h3llf/Euclid-8/Controller/ADC.kicad_sch

## KiCad design Controller/ADC.kicad_sch (2026-04-20)

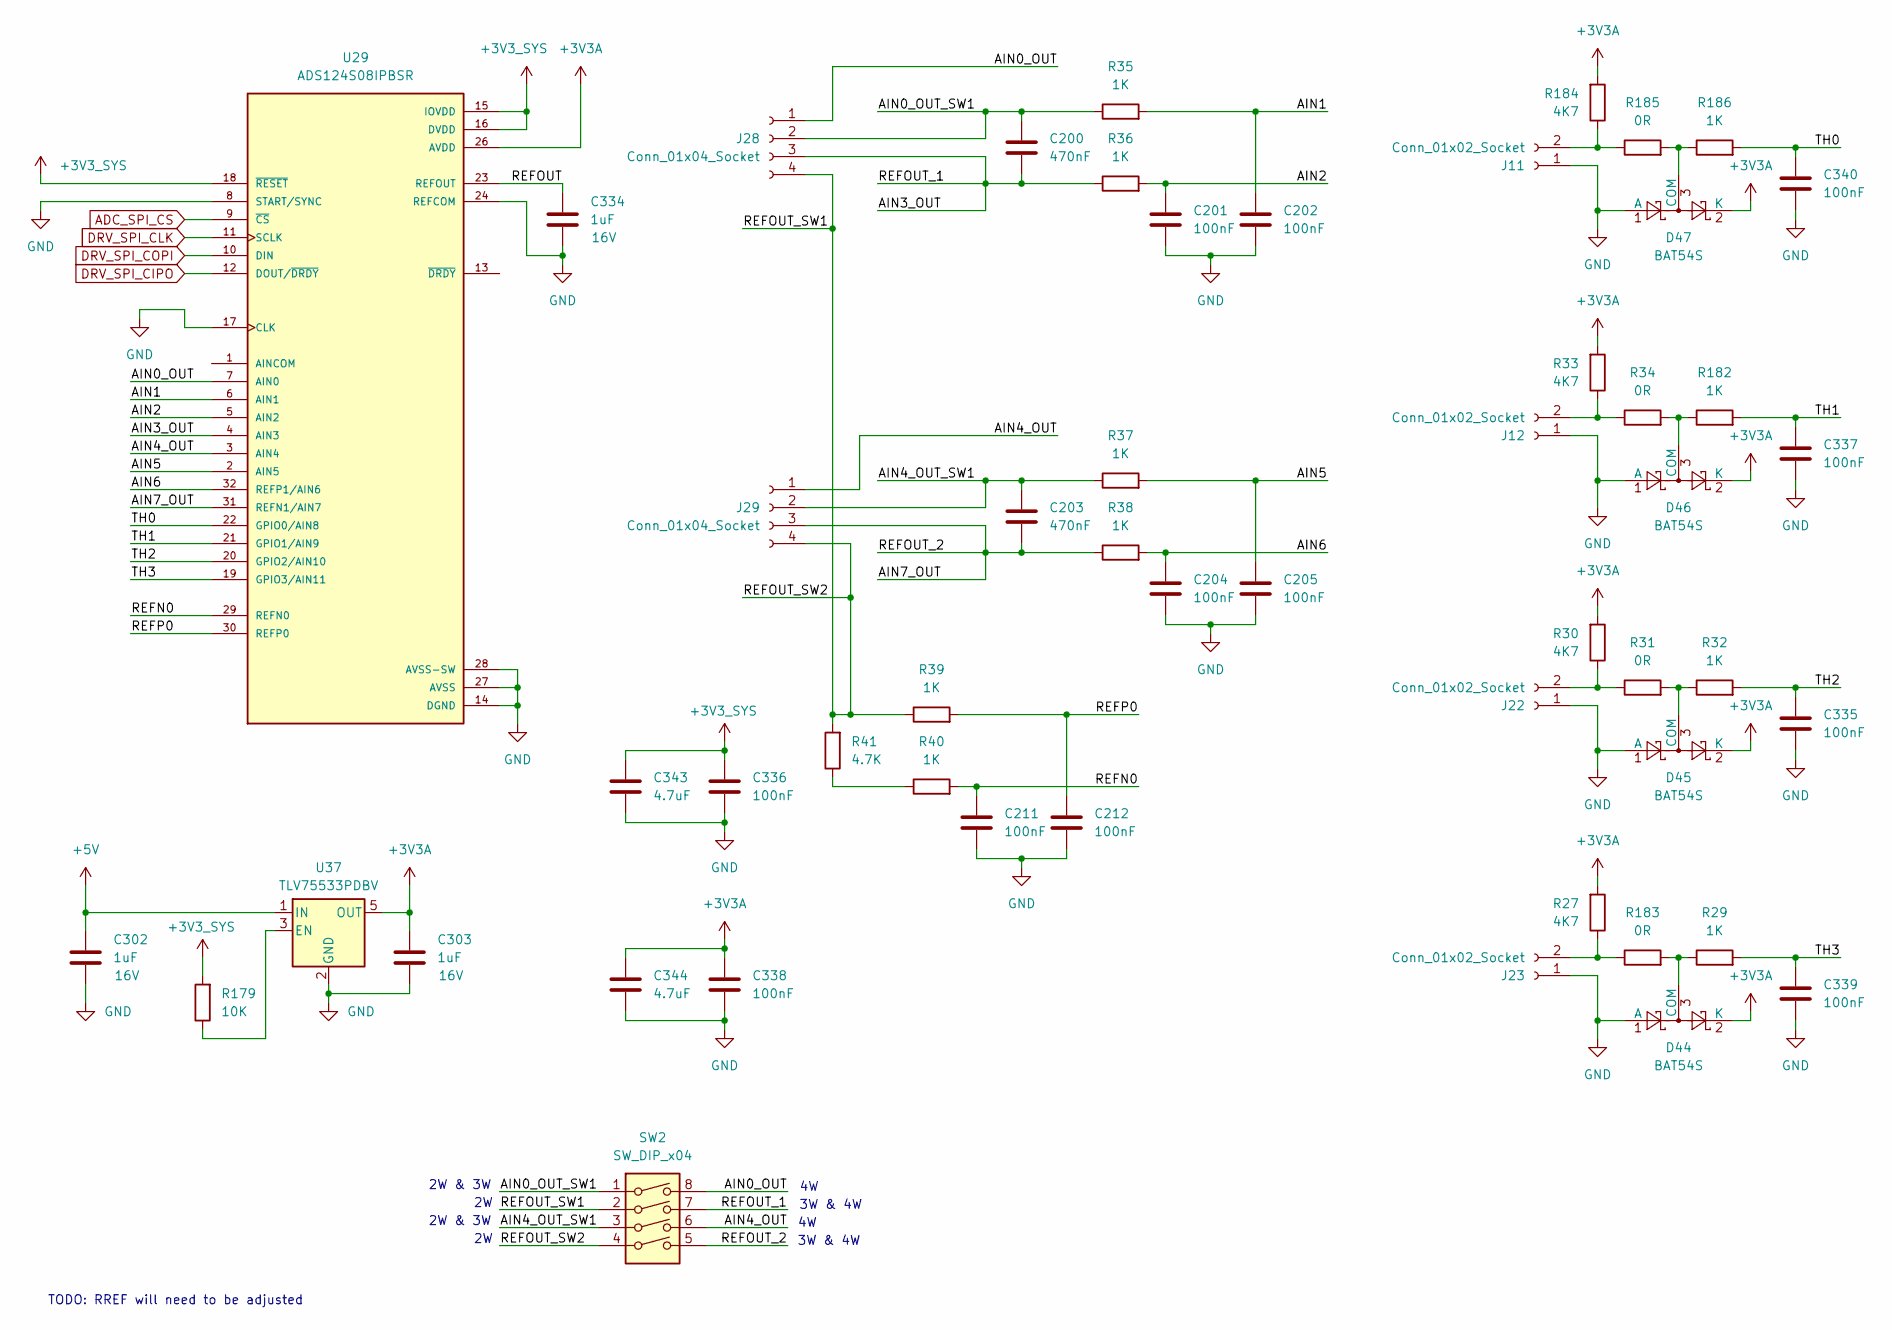
[picture p1: schematic ADC.kicad_sch]

Parts:
C200, C203: 470nF; C_0603_1608Metric
C201, C202, C204, C205, C211, C212, C335, C336, C337, C338, C339, C340: 100nF; C_0603_1608Metric
C302, C303, C334: 1uF; C_0402_1005Metric; voltage 16V; LCSC C29266
C343, C344: 4.7uF; C_0603_1608Metric; LCSC C69335
D44, D45, D46, D47: BAT54S; SOT-23
J11, J12, J22, J23: Conn_01x02_Socket; JST_XH_B2B-XH-A_1x02_P2.50mm_Vertical
J28, J29: Conn_01x04_Socket; JST_XH_B4B-XH-A_1x04_P2.50mm_Vertical
R27, R30, R33, R184: 4K7; R_0603_1608Metric
R29, R32, R35, R36, R37, R38, R39, R40, R182, R186: 1K; R_0603_1608Metric
R31, R34, R183, R185: 0R; R_0603_1608Metric
R41: 4.7K; R_0603_1608Metric
R179: 10K; R_0603_1608Metric
SW2: SW_DIP_x04; SW_DIP_SPSTx04_Slide_KingTek_DSHP04TS_W7.62mm_P1.27mm
U29: ADS124S08IPBSR; QFP50P700X700X120-32N; PARTREV C
U37: TLV75533PDBV; SOT-23-5

Connections:
+3V3A: C303.1, C338.1, C344.1, D44.2 (K), D45.2 (K), D46.2 (K), D47.2 (K), R27.2, R30.2, R33.2, R184.2, U29.26 (AVDD), U37.5 (OUT)
+3V3_SYS: C336.1, C343.1, R179.2, U29.15 (IOVDD), U29.16 (DVDD), U29.18 (~RESET)
+5V: C302.1, U37.1 (IN)
ADC_SPI_CS: U29.9 (~CS)
AIN0_OUT: J28.1, SW2.8, U29.7 (AIN0)
AIN0_OUT_SW1: C200.1, J28.2, R35.1, SW2.1
AIN1: C202.1, R35.2, U29.6 (AIN1)
AIN2: C201.1, R36.2, U29.5 (AIN2)
AIN3_OUT: C200.2, J28.3, R36.1, SW2.7, U29.4 (AIN3)
AIN4_OUT: J29.1, SW2.6, U29.3 (AIN4)
AIN4_OUT_SW1: C203.1, J29.2, R37.1, SW2.3
AIN5: C205.1, R37.2, U29.2 (AIN5)
AIN6: C204.1, R38.2, U29.32 (REFP1/AIN6)
AIN7_OUT: C203.2, J29.3, R38.1, SW2.5, U29.31 (REFN1/AIN7)
DRV_SPI_CIPO: U29.12 (DOUT/~DRDY)
DRV_SPI_CLK: U29.11 (SCLK)
DRV_SPI_COPI: U29.10 (DIN)
GND: C201.2, C202.2, C204.2, C205.2, C211.2, C212.2, C302.2, C303.2, C334.2, C335.2, C336.2, C337.2, C338.2, C339.2, C340.2, C343.2, C344.2, D44.1 (A), D45.1 (A), D46.1 (A), D47.1 (A), J11.1, J12.1, J22.1, J23.1, U29.8 (START/SYNC), U29.14 (DGND), U29.17 (CLK), U29.24 (REFCOM), U29.27 (AVSS), U29.28 (AVSS-SW), U37.2 (GND)
unnamed: D44.3 (COM), R29.1, R183.2
unnamed: D45.3 (COM), R31.2, R32.1
unnamed: D46.3 (COM), R34.2, R182.1
unnamed: D47.3 (COM), R185.2, R186.1
unnamed: J11.2, R184.1, R185.1
unnamed: J12.2, R33.1, R34.1
unnamed: J22.2, R30.1, R31.1
unnamed: J23.2, R27.1, R183.1
unnamed: R40.1, R41.1
unnamed: R179.1, U37.3 (EN)
REFN0: C211.1, R40.2, U29.29 (REFN0)
REFOUT: C334.1, U29.23 (REFOUT)
REFOUT_SW1: J28.4, J29.4, R39.1, R41.2, SW2.2, SW2.4
REFP0: C212.1, R39.2, U29.30 (REFP0)
TH0: C340.1, R186.2, U29.22 (GPIO0/AIN8)
TH1: C337.1, R182.2, U29.21 (GPIO1/AIN9)
TH2: C335.1, R32.2, U29.20 (GPIO2/AIN10)
TH3: C339.1, R29.2, U29.19 (GPIO3/AIN11)

Notes on the sheet:
TODO: RREF will need to be adjusted
3W & 4W
2W & 3W
