h3llf/Euclid-8/Controller/AM6254_DDR4.kicad_sch

## KiCad design Controller/AM6254_DDR4.kicad_sch (2026-04-20)

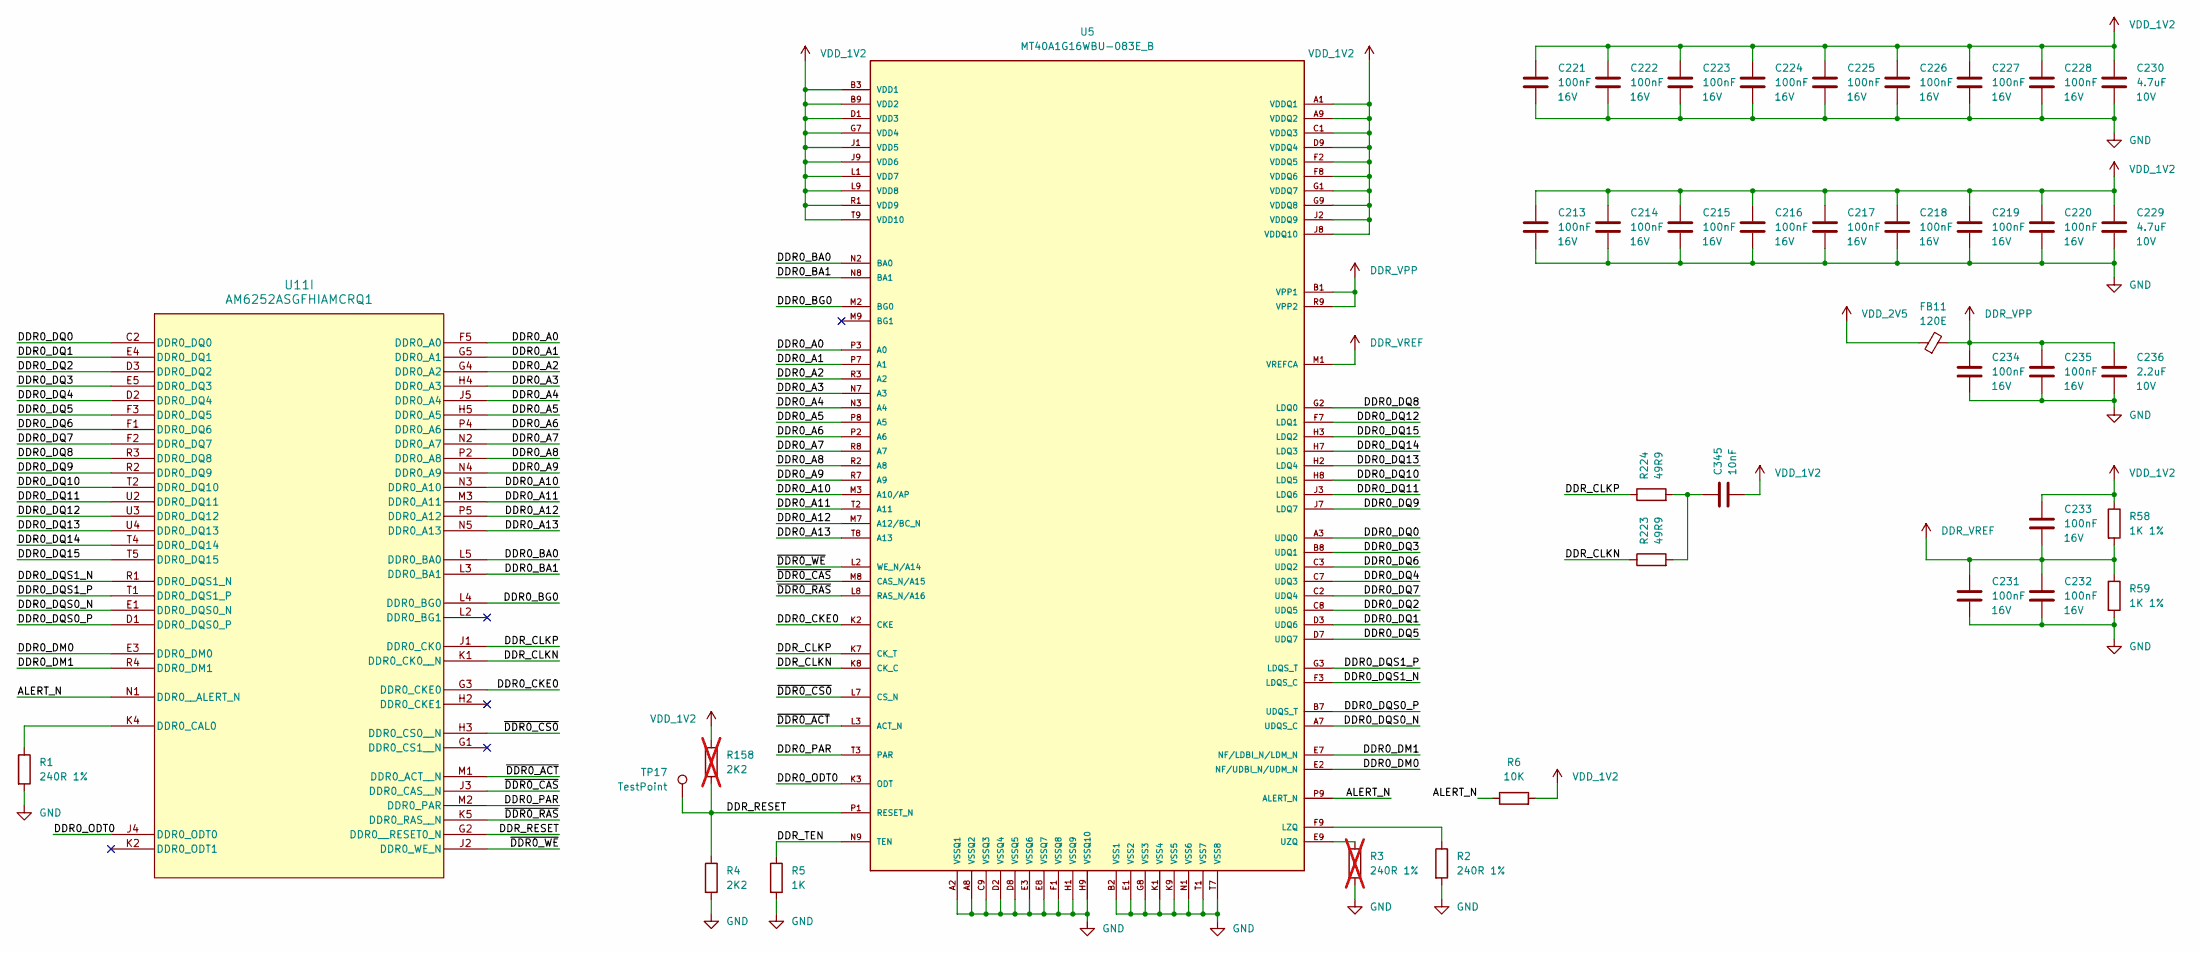
[picture p2: schematic AM6254_DDR4.kicad_sch]

Parts:
C213, C214, C215, C216, C217, C218, C219, C220, C221, C222, C223, C224, C225, C226, C227, C228, C231, C232, C233, C234, C235: 100nF; C_0402_1005Metric; Voltage 16V
C229, C230: 4.7uF; C_0402_1005Metric; voltage 10V; LCSC C368809
C236: 2.2uF; C_0402_1005Metric; voltage 10V; LCSC C170151
C345: 10nF; C_0402_1005Metric
FB11: 120E; L_0402_1005Metric; LCSC C88970
R1, R2: 240R 1%; R_0402_1005Metric; LCSC C114755
R3: 240R 1%; R_0402_1005Metric; LCSC C114755; not fitted
R4: 2K2; R_0402_1005Metric
R5: 1K; R_0402_1005Metric
R6: 10K; R_0402_1005Metric
R58, R59: 1K 1%; R_0402_1005Metric
R158: 2K2; R_0402_1005Metric; not fitted
R223, R224: 49R9; R_0402_1005Metric
TP17: TestPoint; TestPoint_Pad_D1.0mm
U5: MT40A1G16WBU-083E_B; BGA96C80P16X9_1400X800X110N
U11: AM6252ASGFHIAMCRQ1; FCBGA441_AMC_TEX

Connections:
ALERT_N: R6.1, U5.P9 (ALERT_N), U11.N1 (DDR0__ALERT_N)
DDR0_A0: U5.P3 (A0), U11.F5 (DDR0_A0)
DDR0_A1: U5.P7 (A1), U11.G5 (DDR0_A1)
DDR0_A2: U5.R3 (A2), U11.G4 (DDR0_A2)
DDR0_A3: U5.N7 (A3), U11.H4 (DDR0_A3)
DDR0_A4: U5.N3 (A4), U11.J5 (DDR0_A4)
DDR0_A5: U5.P8 (A5), U11.H5 (DDR0_A5)
DDR0_A6: U5.P2 (A6), U11.P4 (DDR0_A6)
DDR0_A7: U5.R8 (A7), U11.N2 (DDR0_A7)
DDR0_A8: U5.R2 (A8), U11.P2 (DDR0_A8)
DDR0_A9: U5.R7 (A9), U11.N4 (DDR0_A9)
DDR0_A10: U5.M3 (A10/AP), U11.N3 (DDR0_A10)
DDR0_A11: U5.T2 (A11), U11.M3 (DDR0_A11)
DDR0_A12: U5.M7 (A12/BC_N), U11.P5 (DDR0_A12)
DDR0_A13: U5.T8 (A13), U11.N5 (DDR0_A13)
DDR0_BA0: U5.N2 (BA0), U11.L5 (DDR0_BA0)
DDR0_BA1: U5.N8 (BA1), U11.L3 (DDR0_BA1)
DDR0_BG0: U5.M2 (BG0), U11.L4 (DDR0_BG0)
DDR0_CKE0: U5.K2 (CKE), U11.G3 (DDR0_CKE0)
DDR0_DM0: U5.E2 (NF/UDBI_N/UDM_N), U11.E3 (DDR0_DM0)
DDR0_DM1: U5.E7 (NF/LDBI_N/LDM_N), U11.R4 (DDR0_DM1)
DDR0_DQ0: U5.A3 (UDQ0), U11.C2 (DDR0_DQ0)
DDR0_DQ1: U5.D3 (UDQ6), U11.E4 (DDR0_DQ1)
DDR0_DQ2: U5.C8 (UDQ5), U11.D3 (DDR0_DQ2)
DDR0_DQ3: U5.B8 (UDQ1), U11.E5 (DDR0_DQ3)
DDR0_DQ4: U5.C7 (UDQ3), U11.D2 (DDR0_DQ4)
DDR0_DQ5: U5.D7 (UDQ7), U11.F3 (DDR0_DQ5)
DDR0_DQ6: U5.C3 (UDQ2), U11.F1 (DDR0_DQ6)
DDR0_DQ7: U5.C2 (UDQ4), U11.F2 (DDR0_DQ7)
DDR0_DQ8: U5.G2 (LDQ0), U11.R3 (DDR0_DQ8)
DDR0_DQ9: U5.J7 (LDQ7), U11.R2 (DDR0_DQ9)
DDR0_DQ10: U5.H8 (LDQ5), U11.T2 (DDR0_DQ10)
DDR0_DQ11: U5.J3 (LDQ6), U11.U2 (DDR0_DQ11)
DDR0_DQ12: U5.F7 (LDQ1), U11.U3 (DDR0_DQ12)
DDR0_DQ13: U5.H2 (LDQ4), U11.U4 (DDR0_DQ13)
DDR0_DQ14: U5.H7 (LDQ3), U11.T4 (DDR0_DQ14)
DDR0_DQ15: U5.H3 (LDQ2), U11.T5 (DDR0_DQ15)
DDR0_DQS0_N: U5.A7 (UDQS_C), U11.E1 (DDR0_DQS0_N)
DDR0_DQS0_P: U5.B7 (UDQS_T), U11.D1 (DDR0_DQS0_P)
DDR0_DQS1_N: U5.F3 (LDQS_C), U11.R1 (DDR0_DQS1_N)
DDR0_DQS1_P: U5.G3 (LDQS_T), U11.T1 (DDR0_DQS1_P)
DDR0_ODT0: U5.K3 (ODT), U11.J4 (DDR0_ODT0)
DDR0_PAR: U5.T3 (PAR), U11.M2 (DDR0_PAR)
DDR_CLKN: R223.1, U5.K8 (CK_C), U11.K1 (DDR0_CK0__N)
DDR_CLKP: R224.1, U5.K7 (CK_T), U11.J1 (DDR0_CK0)
DDR_RESET: R4.1, R158.2, TP17.1, U5.P1 (RESET_N), U11.G2 (DDR0__RESET0_N)
DDR_TEN: R5.1, U5.N9 (TEN)
DDR_VPP: C234.1, C235.1, C236.1, FB11.2, U5.B1 (VPP1), U5.R9 (VPP2)
DDR_VREF: C231.1, C232.1, C233.2, R58.2, R59.1, U5.M1 (VREFCA)
GND: C213.2, C214.2, C215.2, C216.2, C217.2, C218.2, C219.2, C220.2, C221.2, C222.2, C223.2, C224.2, C225.2, C226.2, C227.2, C228.2, C229.2, C230.2, C231.2, C232.2, C234.2, C235.2, C236.2, R1.2, R2.2, R3.2, R4.2, R5.2, R59.2, U5.A2 (VSSQ1), U5.A8 (VSSQ2), U5.B2 (VSS1), U5.C9 (VSSQ3), U5.D2 (VSSQ4), U5.D8 (VSSQ5), U5.E1 (VSS2), U5.E3 (VSSQ6), U5.E8 (VSSQ7), U5.F1 (VSSQ8), U5.G8 (VSS3), U5.H1 (VSSQ9), U5.H9 (VSSQ10), U5.K1 (VSS4), U5.K9 (VSS5), U5.N1 (VSS6), U5.T1 (VSS7), U5.T7 (VSS8)
unnamed: C345.1, R223.2, R224.2
unnamed: R1.1, U11.K4 (DDR0_CAL0)
unnamed: R2.1, U5.F9 (LZQ)
unnamed: R3.1, U5.E9 (UZQ)
VDD_1V2: C213.1, C214.1, C215.1, C216.1, C217.1, C218.1, C219.1, C220.1, C221.1, C222.1, C223.1, C224.1, C225.1, C226.1, C227.1, C228.1, C229.1, C230.1, C233.1, C345.2, R6.2, R58.1, R158.1, U5.A1 (VDDQ1), U5.A9 (VDDQ2), U5.B3 (VDD1), U5.B9 (VDD2), U5.C1 (VDDQ3), U5.D1 (VDD3), U5.D9 (VDDQ4), U5.F2 (VDDQ5), U5.F8 (VDDQ6), U5.G1 (VDDQ7), U5.G7 (VDD4), U5.G9 (VDDQ8), U5.J1 (VDD5), U5.J2 (VDDQ9), U5.J8 (VDDQ10), U5.J9 (VDD6), U5.L1 (VDD7), U5.L9 (VDD8), U5.R1 (VDD9), U5.T9 (VDD10)
VDD_2V5: FB11.1
~DDR0_ACT: U5.L3 (ACT_N), U11.M1 (DDR0_ACT__N)
~DDR0_CAS: U5.M8 (CAS_N/A15), U11.J3 (DDR0_CAS__N)
~DDR0_CS0: U5.L7 (CS_N), U11.H3 (DDR0_CS0__N)
~DDR0_RAS: U5.L8 (RAS_N/A16), U11.K5 (DDR0_RAS__N)
~DDR0_WE: U5.L2 (WE_N/A14), U11.J2 (DDR0_WE_N)
