h3llf/Euclid-8/Controller/Board_Power.kicad_sch

## KiCad design Controller/Board_Power.kicad_sch (2026-05-04)

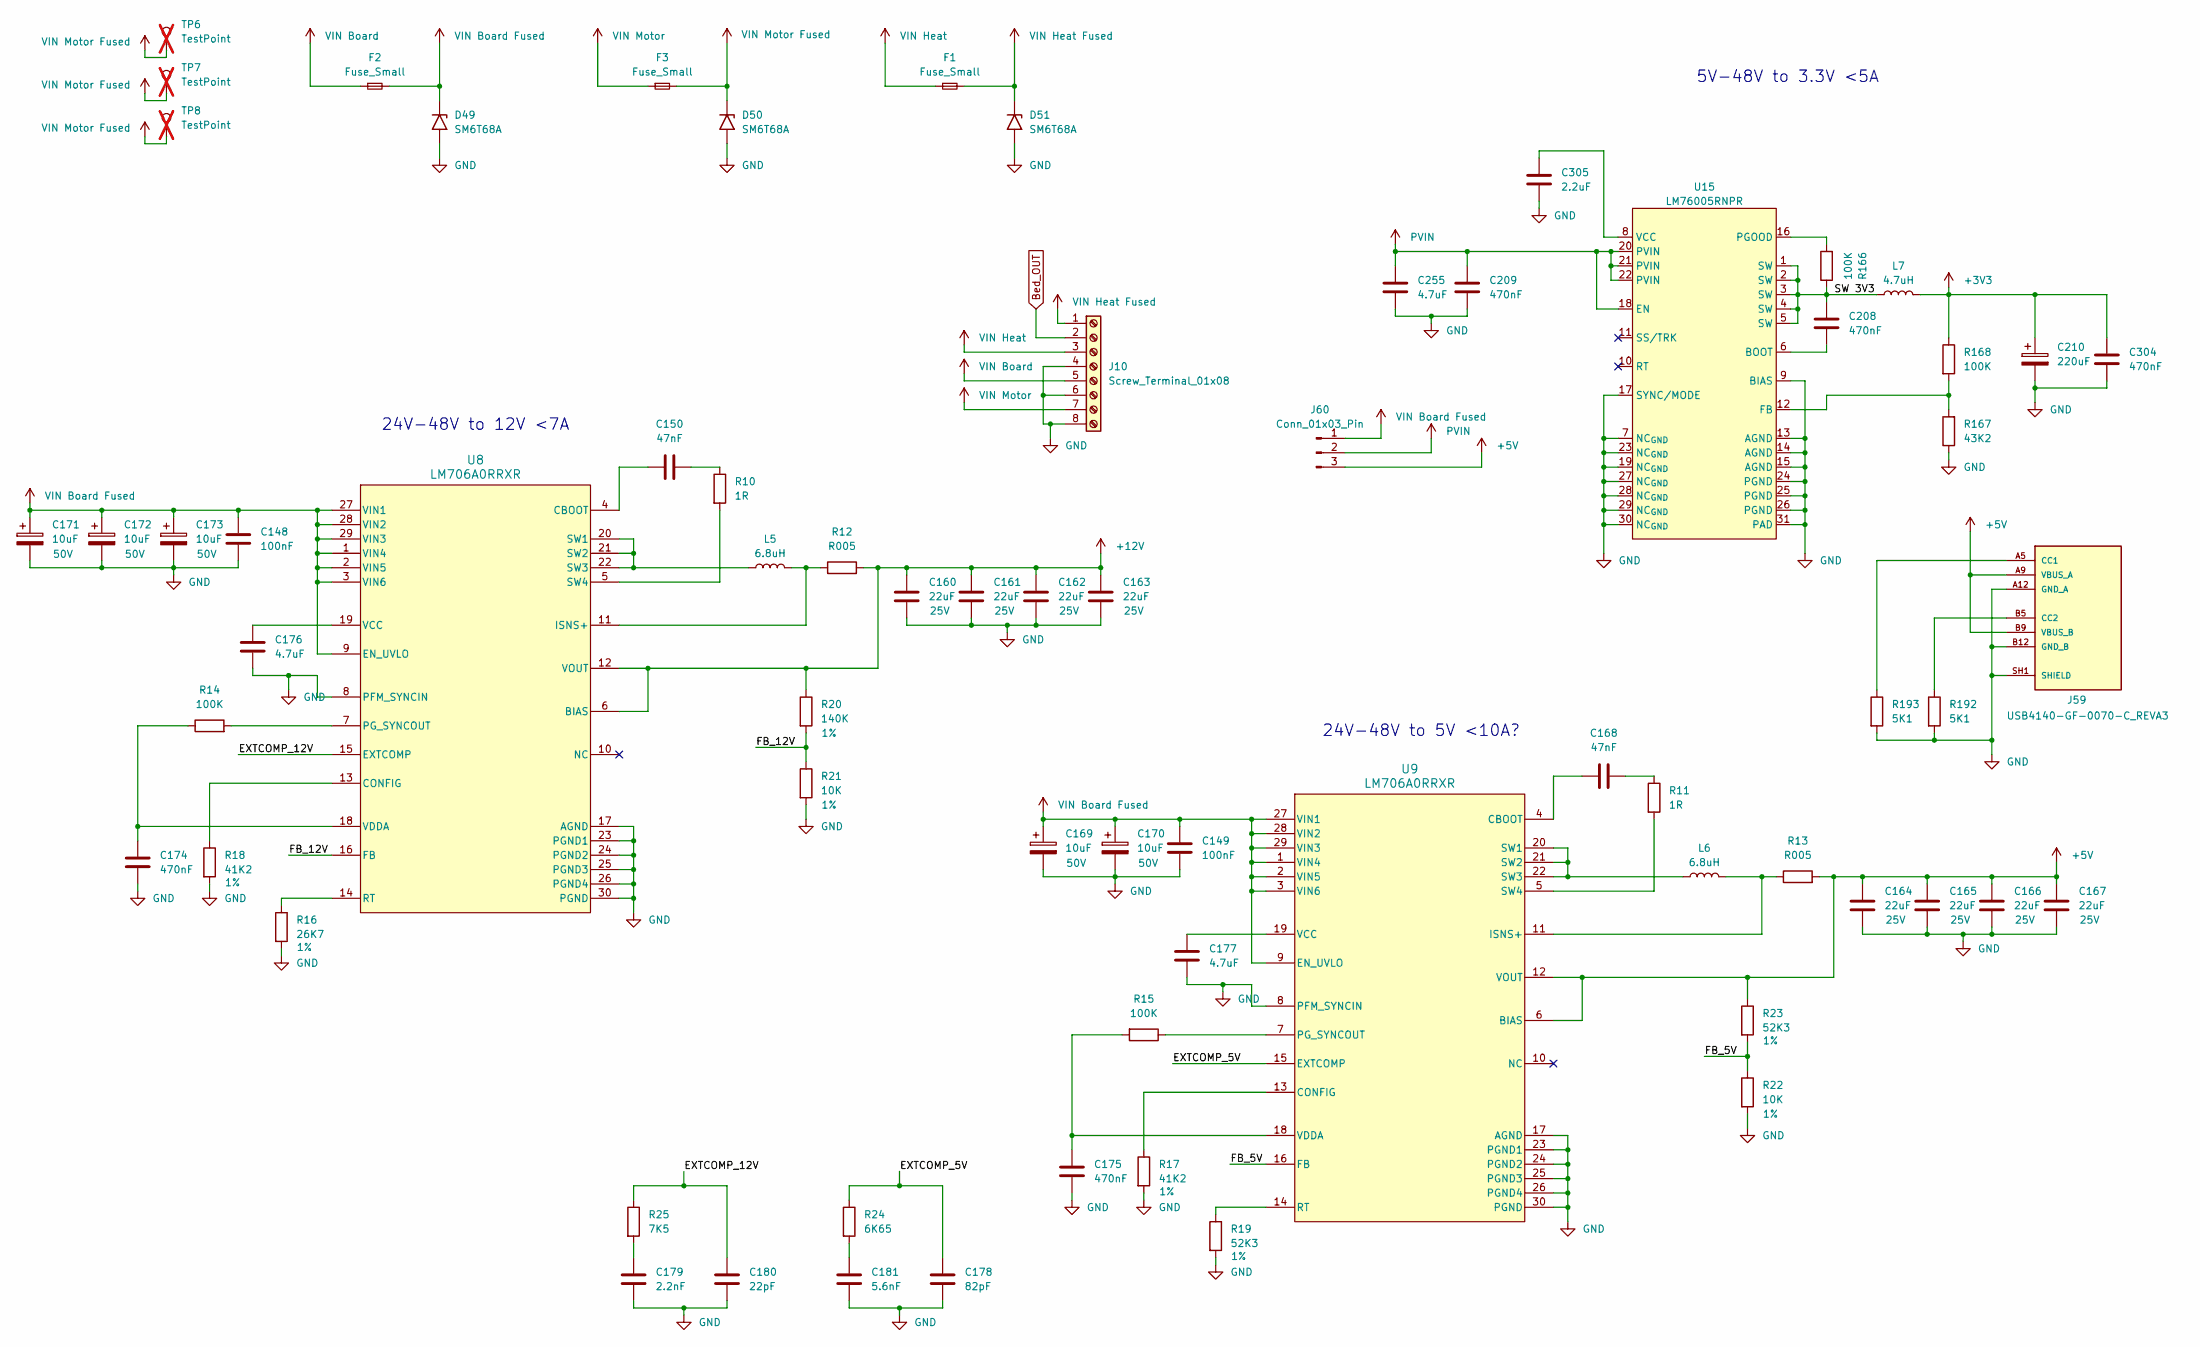
[picture p3: schematic Board_Power.kicad_sch]

Parts:
C148, C149: 100nF; C_0603_1608Metric; LCSC C15725
C150, C168: 47nF; C_0402_1005Metric; LCSC C5137574
C160, C161, C162, C163, C164, C165, C166, C167: 22uF; C_1210_3225Metric; Voltage 25V; LCSC C309062
C169, C170, C171, C172, C173: 10uF; CP_Elec_6.3x5.9; Voltage 50V; LCSC C2162323
C174, C175, C208, C209, C304: 470nF; C_0603_1608Metric; LCSC C513577
C176, C177: 4.7uF; C_0603_1608Metric; LCSC C69335
C178: 82pF; C_0603_1608Metric; LCSC C113796
C179: 2.2nF; C_0603_1608Metric; LCSC C106210
C180: 22pF; C_0603_1608Metric; LCSC C519549
C181: 5.6nF; C_0603_1608Metric; LCSC C100042
C210: 220uF; CP_EIA-3528-21_Kemet-B; LCSC C79111
C255: 4.7uF; C_1210_3225Metric; LCSC C697607
C305: 2.2uF; C_0603_1608Metric; LCSC C57895
D49, D50, D51: SM6T68A; D_SMB
F1, F2, F3: Fuse_Small; Fuseholder_Blade_Mini_Keystone_3568
J10: Screw_Terminal_01x08; DORABO-DBT50G-9.5-8P
J59: USB4140-GF-0070-C_REVA3; GCT_USB4140-GF-0070-C_REVA3; PARTREV A3
J60: Conn_01x03_Pin; PinHeader_1x03_P2.54mm_Vertical
L5, L6: 6.8uH; YJYCOIN YPRH1208-XXX; LCSC C970538
L7: 4.7uH; L_APV_APH0630
R10, R11: 1R; R_0603_1608Metric; LCSC C22936
R12: R005; R_2512_6332Metric
R13: R005; R_2512_6332Metric; LCSC C46634448
R14, R15, R166, R168: 100K; R_0603_1608Metric
R16: 26K7; R_0603_1608Metric; LCSC C23198
R17, R18: 41K2; R_0603_1608Metric; LCSC C706088
R19, R23: 52K3; R_0603_1608Metric; LCSC C23198
R20: 140K; R_0603_1608Metric; LCSC C185372
R21, R22: 10K; R_0603_1608Metric; LCSC C25804
R24: 6K65; R_0603_1608Metric; LCSC C859010
R25: 7K5; R_0603_1608Metric; LCSC C2933189
R167: 43K2; R_0603_1608Metric
R192, R193: 5K1; R_0603_1608Metric
TP6, TP7, TP8: TestPoint; TestPoint_Pad_4.0x4.0mm; not fitted
U8, U9: LM706A0RRXR; RRX0029B-MFG
U15: LM76005RNPR; Texas_RNP0030B_WQFN-30-1EP_4x6mm_P0.5mm_EP1.8x4.5mm

Connections:
+3V3: C210.1, C304.1, L7.2, R168.1
+5V: C164.1, C165.1, C166.1, C167.1, J59.A9 (VBUS_A), J59.B9 (VBUS_B), J60.3, R13.2, R23.1, U9.6 (BIAS), U9.12 (VOUT)
+12V: C160.1, C161.1, C162.1, C163.1, R12.2, R20.1, U8.6 (BIAS), U8.12 (VOUT)
Bed_OUT: J10.2
EXTCOMP_5V: C178.1, R24.1, U9.15 (EXTCOMP)
EXTCOMP_12V: C180.1, R25.1, U8.15 (EXTCOMP)
FB_5V: R22.1, R23.2, U9.16 (FB)
FB_12V: R20.2, R21.1, U8.16 (FB)
GND: C148.2, C149.2, C160.2, C161.2, C162.2, C163.2, C164.2, C165.2, C166.2, C167.2, C169.2, C170.2, C171.2, C172.2, C173.2, C174.2, C175.2, C176.2, C177.2, C178.2, C179.2, C180.2, C181.2, C209.2, C210.2, C255.2, C304.2, C305.2, D49.2 (A2), D50.2 (A2), D51.2 (A2), J10.4, J10.6, J10.8, J59.A12 (GND_A), J59.B12 (GND_B), J59.SH1 (SHIELD), J59.SH2 (SHIELD), J59.SH3 (SHIELD), J59.SH4 (SHIELD), R16.2, R17.2, R18.2, R19.2, R21.2, R22.2, R167.1, R192.2, R193.2, U8.8 (PFM_SYNCIN), U8.17 (AGND), U8.23 (PGND1), U8.24 (PGND2), U8.25 (PGND3), U8.26 (PGND4), U8.30 (PGND), U9.8 (PFM_SYNCIN), U9.17 (AGND), U9.23 (PGND1), U9.24 (PGND2), U9.25 (PGND3), U9.26 (PGND4), U9.30 (PGND), U15.7 (NC_{GND}), U15.9 (BIAS), U15.13 (AGND), U15.14 (AGND), U15.15 (AGND), U15.17 (SYNC/MODE), U15.19 (NC_{GND}), U15.23 (NC_{GND}), U15.24 (PGND), U15.25 (PGND), U15.26 (PGND), U15.27 (NC_{GND}), U15.28 (NC_{GND}), U15.29 (NC_{GND}), U15.30 (NC_{GND}), U15.31 (PAD)
unnamed: C150.1, U8.4 (CBOOT)
unnamed: C150.2, R10.1
unnamed: C168.1, U9.4 (CBOOT)
unnamed: C168.2, R11.1
unnamed: C174.1, R14.1, U8.18 (VDDA)
unnamed: C175.1, R15.2, U9.18 (VDDA)
unnamed: C176.1, U8.19 (VCC)
unnamed: C177.1, U9.19 (VCC)
unnamed: C179.1, R25.2
unnamed: C181.1, R24.2
unnamed: C208.2, U15.6 (BOOT)
unnamed: C305.1, U15.8 (VCC)
unnamed: J59.A5 (CC1), R193.1
unnamed: J59.B5 (CC2), R192.1
unnamed: L5.1, U8.20 (SW1), U8.21 (SW2), U8.22 (SW3)
unnamed: L5.2, R12.1, U8.11 (ISNS+)
unnamed: L6.1, U9.20 (SW1), U9.21 (SW2), U9.22 (SW3)
unnamed: L6.2, R13.1, U9.11 (ISNS+)
unnamed: R10.2, U8.5 (SW4)
unnamed: R11.2, U9.5 (SW4)
unnamed: R14.2, U8.7 (PG_SYNCOUT)
unnamed: R15.1, U9.7 (PG_SYNCOUT)
unnamed: R16.1, U8.14 (RT)
unnamed: R17.1, U9.13 (CONFIG)
unnamed: R18.1, U8.13 (CONFIG)
unnamed: R19.1, U9.14 (RT)
unnamed: R166.2, U15.16 (PGOOD)
unnamed: R167.2, R168.2, U15.12 (FB)
PVIN: C209.1, C255.1, J60.2, U15.18 (EN), U15.20 (PVIN), U15.21 (PVIN), U15.22 (PVIN)
SW 3V3: C208.1, L7.1, R166.1, U15.1 (SW), U15.2 (SW), U15.3 (SW), U15.4 (SW), U15.5 (SW)
VIN Board: F2.1, J10.5
VIN Board Fused: C148.1, C149.1, C169.1, C170.1, C171.1, C172.1, C173.1, D49.1 (A1), F2.2, J60.1, U8.1 (VIN4), U8.2 (VIN5), U8.3 (VIN6), U8.9 (EN_UVLO), U8.27 (VIN1), U8.28 (VIN2), U8.29 (VIN3), U9.1 (VIN4), U9.2 (VIN5), U9.3 (VIN6), U9.9 (EN_UVLO), U9.27 (VIN1), U9.28 (VIN2), U9.29 (VIN3)
VIN Heat: F1.1, J10.3
VIN Heat Fused: D51.1 (A1), F1.2, J10.1
VIN Motor: F3.1, J10.7
VIN Motor Fused: D50.1 (A1), F3.2, TP6.1, TP7.1, TP8.1

Notes on the sheet:
5V-48V to 3.3V <5A
24V-48V to 5V <10A?
24V-48V to 12V <7A
