h3llf/Euclid-8/Controller/CAN.kicad_sch

## KiCad design Controller/CAN.kicad_sch (2026-03-28)

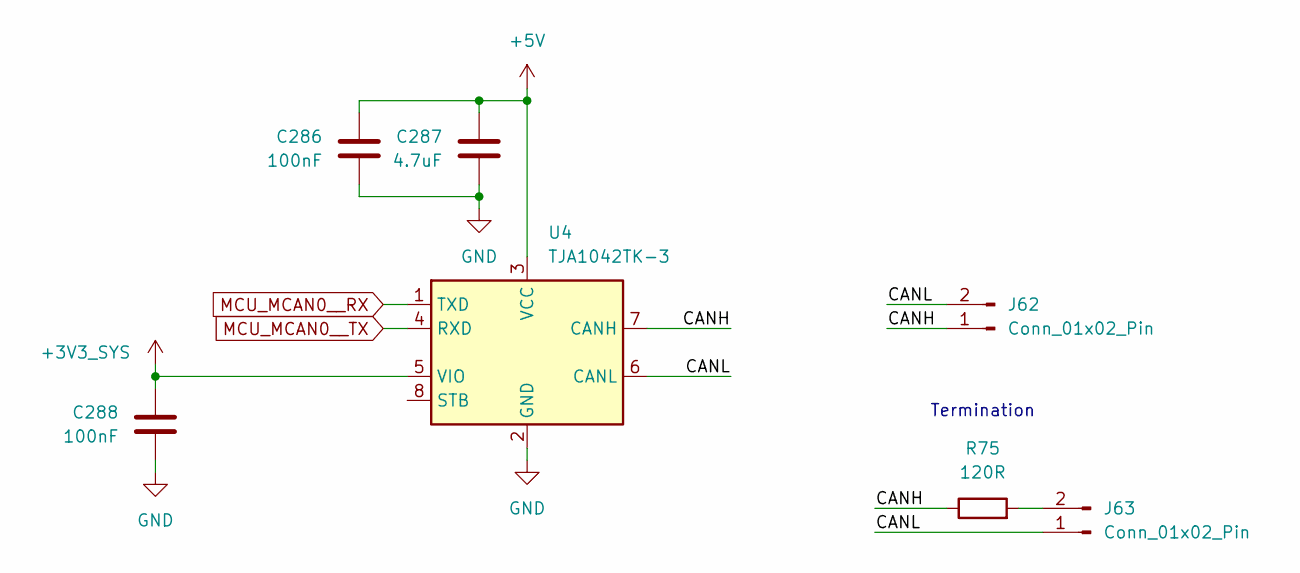
[picture p4: schematic CAN.kicad_sch]

Parts:
C286, C288: 100nF; C_0603_1608Metric
C287: 4.7uF; C_0603_1608Metric
J62, J63: Conn_01x02_Pin; PinHeader_1x02_P2.54mm_Vertical
R75: 120R; R_0603_1608Metric
U4: TJA1042TK-3; HVSON-8-1EP_3x3mm_P0.65mm_EP1.6x2.4mm

Connections:
+3V3_SYS: C288.1, U4.5 (VIO)
+5V: C286.1, C287.1, U4.3 (VCC)
CANH: J62.1, R75.1, U4.7 (CANH)
CANL: J62.2, J63.1, U4.6 (CANL)
GND: C286.2, C287.2, C288.2, U4.2 (GND), U4.9 (GND)
MCU_MCAN0__RX: U4.1 (TXD)
MCU_MCAN0__TX: U4.4 (RXD)
unnamed: J63.2, R75.2

Notes on the sheet:
Termination
