h3llf/Euclid-8/Controller/Controller.kicad_sch

## KiCad design Controller/Controller.kicad_sch (2026-04-20)

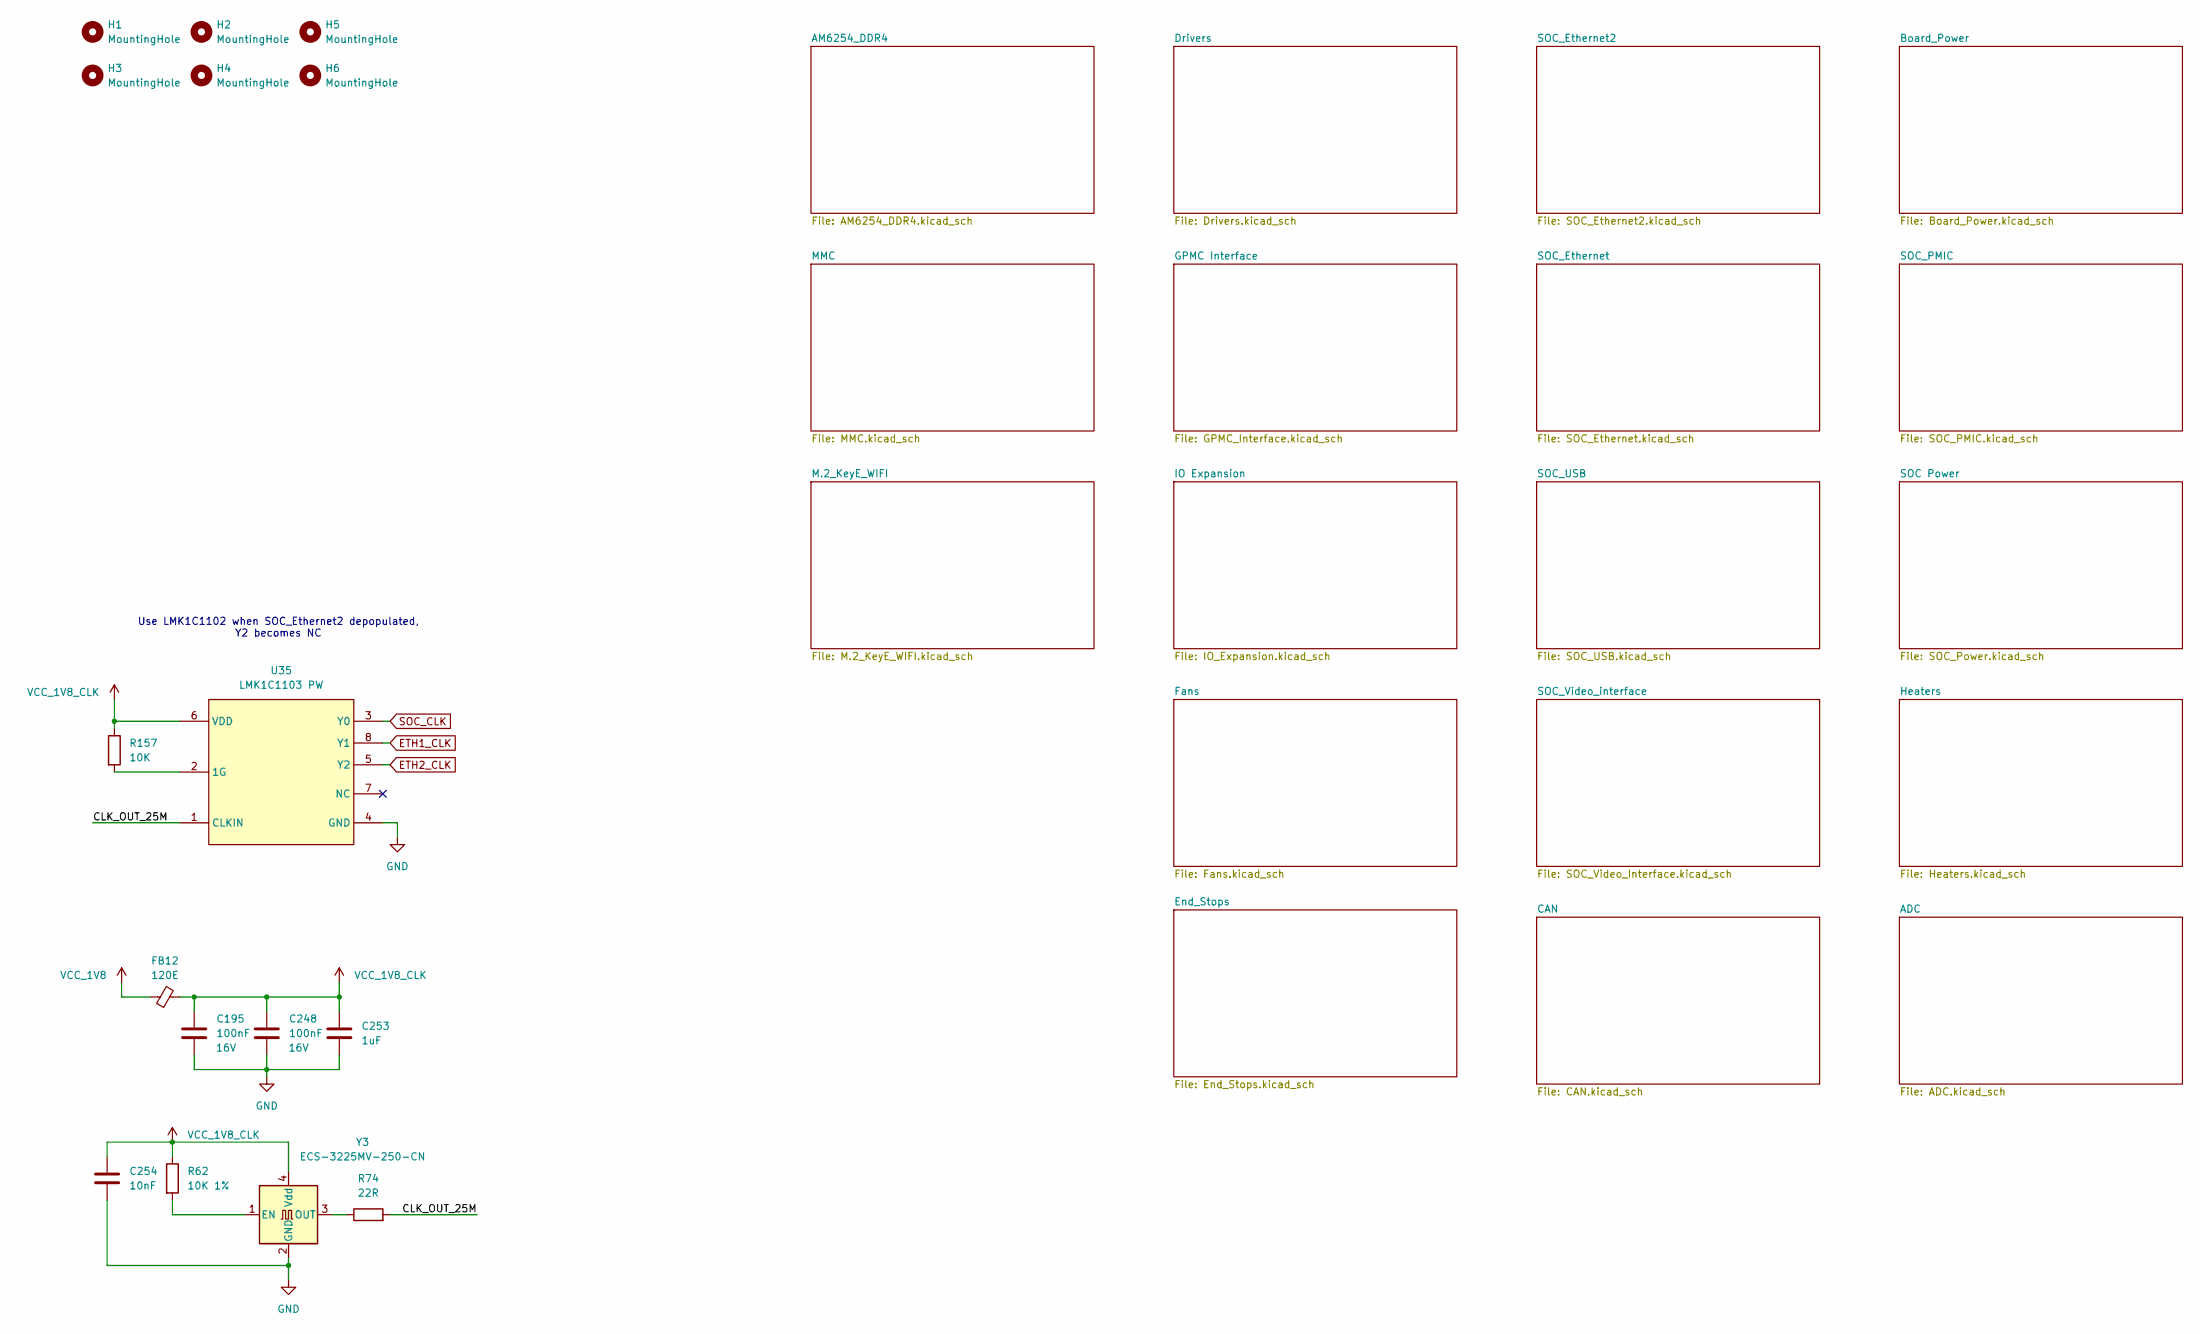
[picture p5: schematic Controller.kicad_sch]

Parts:
C195, C248: 100nF; C_0402_1005Metric; Voltage 16V
C253: 1uF; C_0603_1608Metric
C254: 10nF; C_0402_1005Metric
FB12: 120E; L_0402_1005Metric; LCSC C88970
H1, H2, H3, H4, H5, H6: MountingHole; MountingHole_4.3mm_M4
R62: 10K 1%; R_0603_1608Metric
R74: 22R; R_0402_1005Metric
R157: 10K; R_0603_1608Metric
U35: LMK1C1103 PW; LMK1C110X TSSOP-8
Y3: ECS-3225MV-250-CN; Oscillator_SMD_Abracon_ASE-4Pin_3.2x2.5mm

Connections:
CLK_OUT_25M: R74.2, U35.1 (CLKIN)
ETH1_CLK: U35.8 (Y1)
ETH2_CLK: U35.5 (Y2)
GND: C195.2, C248.2, C253.2, C254.2, U35.4 (GND), Y3.2 (GND)
unnamed: R62.2, Y3.1 (EN)
unnamed: R74.1, Y3.3 (OUT)
unnamed: R157.2, U35.2 (1G)
SOC_CLK: U35.3 (Y0)
VCC_1V8: FB12.1
VCC_1V8_CLK: C195.1, C248.1, C253.1, C254.1, FB12.2, R62.1, R157.1, U35.6 (VDD), Y3.4 (Vdd)

Notes on the sheet:
Use LMK1C1102 when SOC_Ethernet2 depopulated, Y2 becomes NC
