h3llf/Euclid-8/Controller/Drivers.kicad_sch

## KiCad design Controller/Drivers.kicad_sch (2026-04-20)

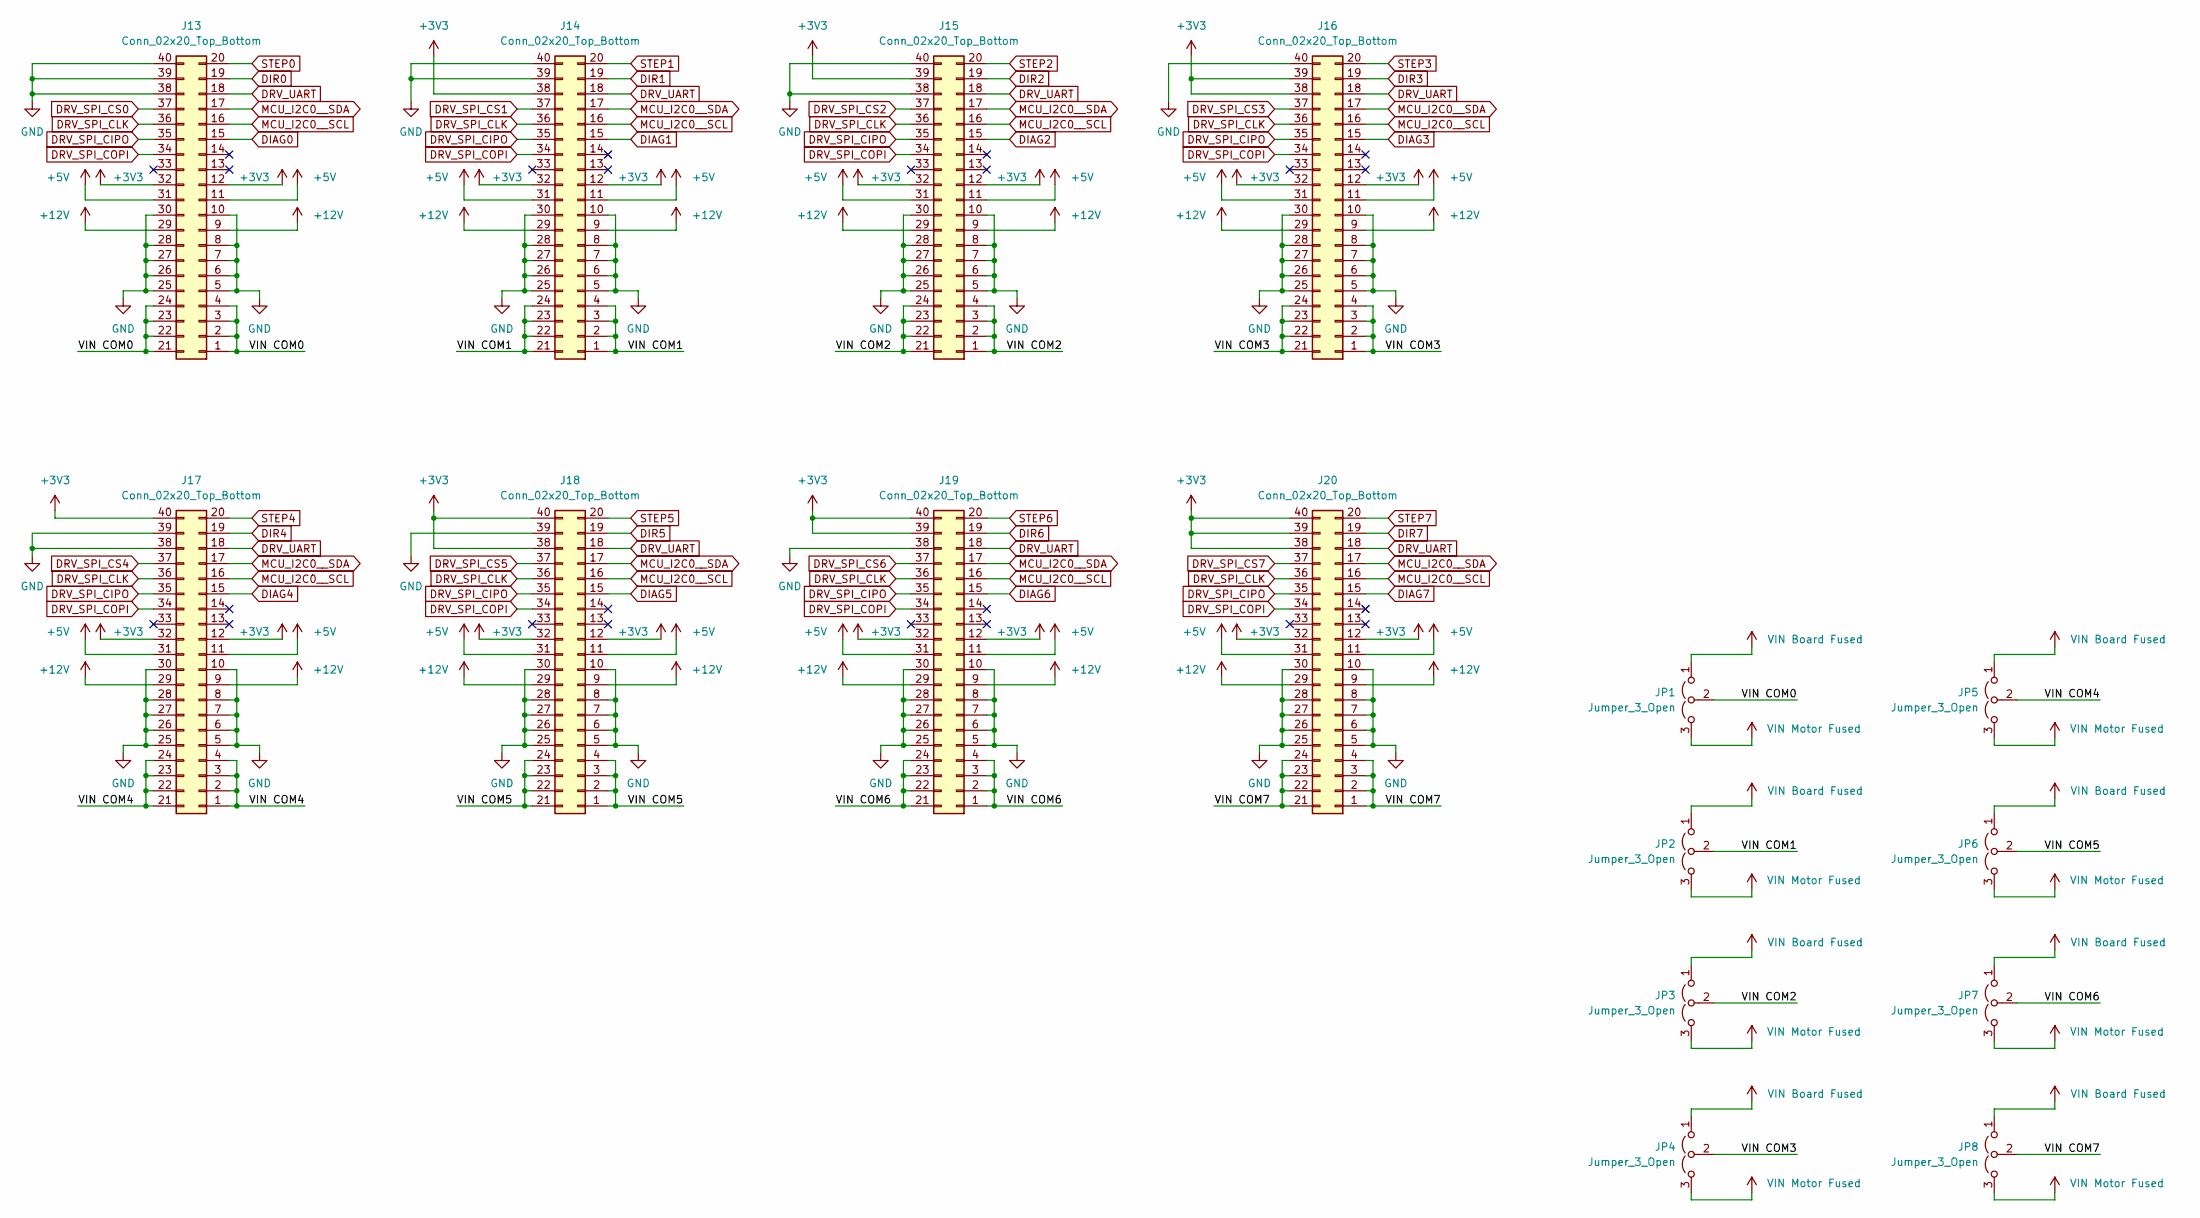
[picture p6: schematic Drivers.kicad_sch]

Parts:
J13, J14, J15, J16, J17, J18, J19, J20: Conn_02x20_Top_Bottom; TX24-40R-6ST-H1E
JP1, JP2, JP3, JP4, JP5, JP6, JP7, JP8: Jumper_3_Open; HarwinPinSocketX3

Connections:
+3V3: J13.12, J13.32, J14.12, J14.32, J14.38, J15.12, J15.32, J15.39, J16.12, J16.32, J16.38, J16.39, J17.12, J17.32, J17.40, J18.12, J18.32, J18.38, J18.40, J19.12, J19.32, J19.39, J19.40, J20.12, J20.32, J20.38, J20.39, J20.40
+5V: J13.11, J13.31, J14.11, J14.31, J15.11, J15.31, J16.11, J16.31, J17.11, J17.31, J18.11, J18.31, J19.11, J19.31, J20.11, J20.31
+12V: J13.9, J13.29, J14.9, J14.29, J15.9, J15.29, J16.9, J16.29, J17.9, J17.29, J18.9, J18.29, J19.9, J19.29, J20.9, J20.29
DIAG0: J13.15
DIAG1: J14.15
DIAG2: J15.15
DIAG3: J16.15
DIAG4: J17.15
DIAG5: J18.15
DIAG6: J19.15
DIAG7: J20.15
DIR0: J13.19
DIR1: J14.19
DIR2: J15.19
DIR3: J16.19
DIR4: J17.19
DIR5: J18.19
DIR6: J19.19
DIR7: J20.19
DRV_SPI_CIPO: J13.35, J14.35, J15.35, J16.35, J17.35, J18.35, J19.35, J20.35
DRV_SPI_CLK: J13.36, J14.36, J15.36, J16.36, J17.36, J18.36, J19.36, J20.36
DRV_SPI_COPI: J13.34, J14.34, J15.34, J16.34, J17.34, J18.34, J19.34, J20.34
DRV_SPI_CS0: J13.37
DRV_SPI_CS1: J14.37
DRV_SPI_CS2: J15.37
DRV_SPI_CS3: J16.37
DRV_SPI_CS4: J17.37
DRV_SPI_CS5: J18.37
DRV_SPI_CS6: J19.37
DRV_SPI_CS7: J20.37
DRV_UART: J13.18, J14.18, J15.18, J16.18, J17.18, J18.18, J19.18, J20.18
GND: J13.5, J13.6, J13.7, J13.8, J13.10, J13.25, J13.26, J13.27, J13.28, J13.30, J13.38, J13.39, J13.40, J14.5, J14.6, J14.7, J14.8, J14.10, J14.25, J14.26, J14.27, J14.28, J14.30, J14.39, J14.40, J15.5, J15.6, J15.7, J15.8, J15.10, J15.25, J15.26, J15.27, J15.28, J15.30, J15.38, J15.40, J16.5, J16.6, J16.7, J16.8, J16.10, J16.25, J16.26, J16.27, J16.28, J16.30, J16.40, J17.5, J17.6, J17.7, J17.8, J17.10, J17.25, J17.26, J17.27, J17.28, J17.30, J17.38, J17.39, J18.5, J18.6, J18.7, J18.8, J18.10, J18.25, J18.26, J18.27, J18.28, J18.30, J18.39, J19.5, J19.6, J19.7, J19.8, J19.10, J19.25, J19.26, J19.27, J19.28, J19.30, J19.38, J20.5, J20.6, J20.7, J20.8, J20.10, J20.25, J20.26, J20.27, J20.28, J20.30
MCU_I2C0__SCL: J13.16, J14.16, J15.16, J16.16, J17.16, J18.16, J19.16, J20.16
MCU_I2C0__SDA: J13.17, J14.17, J15.17, J16.17, J17.17, J18.17, J19.17, J20.17
STEP0: J13.20
STEP1: J14.20
STEP2: J15.20
STEP3: J16.20
STEP4: J17.20
STEP5: J18.20
STEP6: J19.20
STEP7: J20.20
VIN Board Fused: JP1.1 (A), JP2.1 (A), JP3.1 (A), JP4.1 (A), JP5.1 (A), JP6.1 (A), JP7.1 (A), JP8.1 (A)
VIN COM0: J13.1, J13.2, J13.3, J13.4, J13.21, J13.22, J13.23, J13.24, JP1.2 (C)
VIN COM1: J14.1, J14.2, J14.3, J14.4, J14.21, J14.22, J14.23, J14.24, JP2.2 (C)
VIN COM2: J15.1, J15.2, J15.3, J15.4, J15.21, J15.22, J15.23, J15.24, JP3.2 (C)
VIN COM3: J16.1, J16.2, J16.3, J16.4, J16.21, J16.22, J16.23, J16.24, JP4.2 (C)
VIN COM4: J17.1, J17.2, J17.3, J17.4, J17.21, J17.22, J17.23, J17.24, JP5.2 (C)
VIN COM5: J18.1, J18.2, J18.3, J18.4, J18.21, J18.22, J18.23, J18.24, JP6.2 (C)
VIN COM6: J19.1, J19.2, J19.3, J19.4, J19.21, J19.22, J19.23, J19.24, JP7.2 (C)
VIN COM7: J20.1, J20.2, J20.3, J20.4, J20.21, J20.22, J20.23, J20.24, JP8.2 (C)
VIN Motor Fused: JP1.3 (B), JP2.3 (B), JP3.3 (B), JP4.3 (B), JP5.3 (B), JP6.3 (B), JP7.3 (B), JP8.3 (B)
