h3llf/Euclid-8/Controller/End_Stops.kicad_sch

## KiCad design Controller/End_Stops.kicad_sch (2026-03-28)

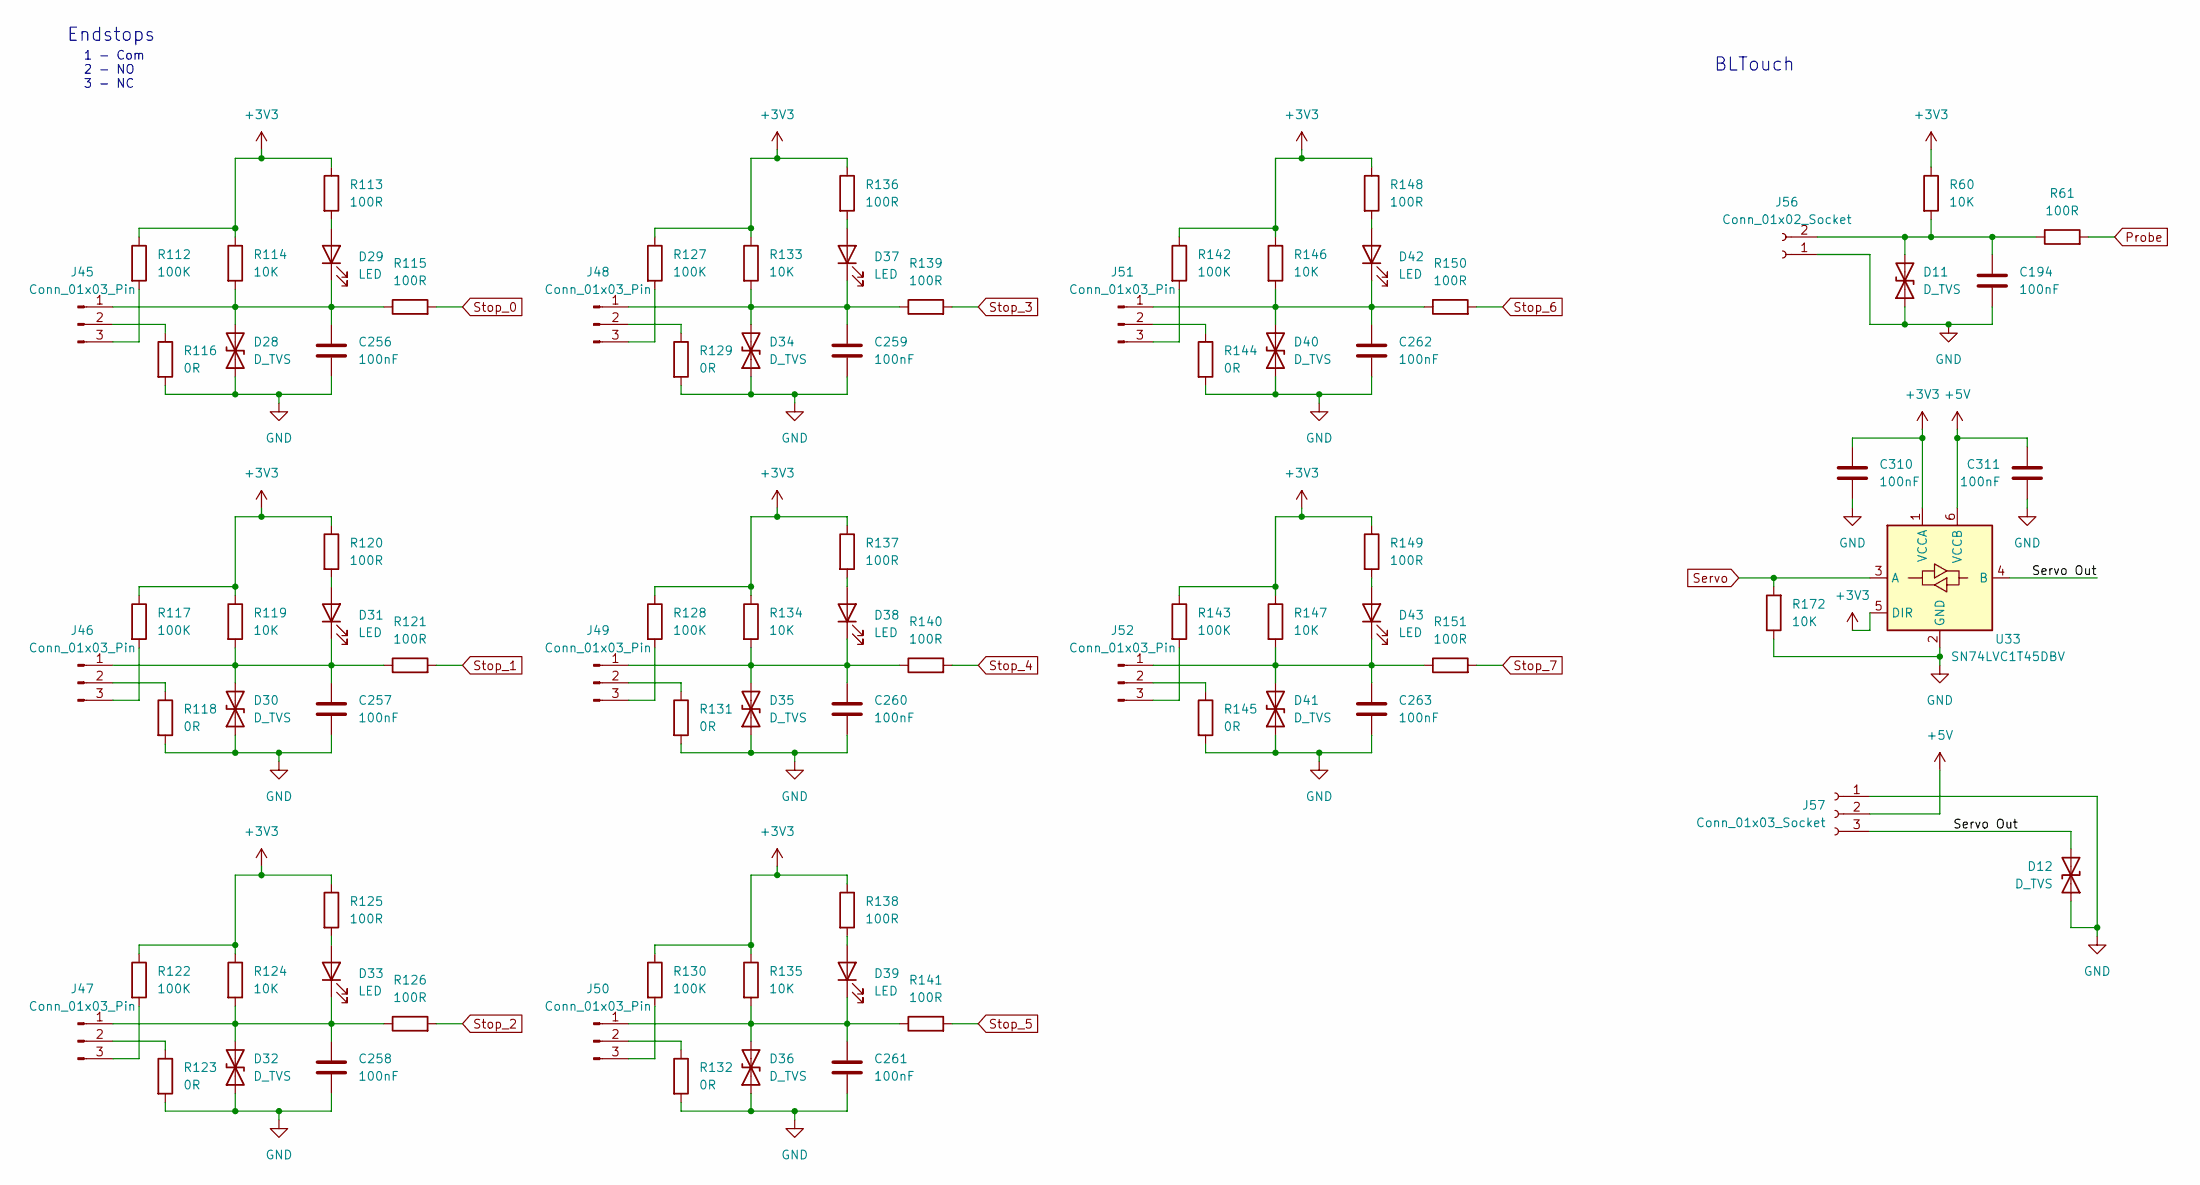
[picture p7: schematic End_Stops.kicad_sch]

Parts:
C194, C256, C257, C258, C259, C260, C261, C262, C263, C310, C311: 100nF; C_0603_1608Metric
D11, D12, D28, D30, D32, D34, D35, D36, D40, D41: D_TVS; D_SOD-882
D29, D31, D33, D37, D38, D39, D42, D43: LED; LED_0603_1608Metric
J45, J46, J47, J48, J49, J50, J51, J52: Conn_01x03_Pin; JST_XH_B3B-XH-A_1x03_P2.50mm_Vertical
J56: Conn_01x02_Socket; JST_XH_B2B-XH-A_1x02_P2.50mm_Vertical
J57: Conn_01x03_Socket; JST_XH_B3B-XH-A_1x03_P2.50mm_Vertical
R60, R114, R119, R124, R133, R134, R135, R146, R147, R172: 10K; R_0603_1608Metric
R61, R113, R115, R120, R121, R125, R126, R136, R137, R138, R139, R140, R141, R148, R149, R150, R151: 100R; R_0603_1608Metric
R112, R117, R122, R127, R128, R130, R142, R143: 100K; R_0603_1608Metric
R116, R118, R123, R129, R131, R132, R144, R145: 0R; R_0603_1608Metric
U33: SN74LVC1T45DBV; SOT-23-6

Connections:
+3V3: C310.1, R60.1, R112.1, R113.1, R114.1, R117.1, R119.1, R120.1, R122.1, R124.1, R125.1, R127.1, R128.1, R130.1, R133.1, R134.1, R135.1, R136.1, R137.1, R138.1, R142.1, R143.1, R146.1, R147.1, R148.1, R149.1, U33.1 (VCCA), U33.5 (DIR)
+5V: C311.1, J57.2, U33.6 (VCCB)
GND: C194.2, C256.2, C257.2, C258.2, C259.2, C260.2, C261.2, C262.2, C263.2, C310.2, C311.2, D11.1 (A1), D12.1 (A1), D28.1 (A1), D30.1 (A1), D32.1 (A1), D34.1 (A1), D35.1 (A1), D36.1 (A1), D40.1 (A1), D41.1 (A1), J56.1, J57.1, R116.2, R118.2, R123.2, R129.2, R131.2, R132.2, R144.2, R145.2, R172.1, U33.2 (GND)
unnamed: C194.1, D11.2 (A2), J56.2, R60.2, R61.1
unnamed: C256.1, D28.2 (A2), D29.1 (K), J45.1, R114.2, R115.1
unnamed: C257.1, D30.2 (A2), D31.1 (K), J46.1, R119.2, R121.1
unnamed: C258.1, D32.2 (A2), D33.1 (K), J47.1, R124.2, R126.1
unnamed: C259.1, D34.2 (A2), D37.1 (K), J48.1, R133.2, R139.1
unnamed: C260.1, D35.2 (A2), D38.1 (K), J49.1, R134.2, R140.1
unnamed: C261.1, D36.2 (A2), D39.1 (K), J50.1, R135.2, R141.1
unnamed: C262.1, D40.2 (A2), D42.1 (K), J51.1, R146.2, R150.1
unnamed: C263.1, D41.2 (A2), D43.1 (K), J52.1, R147.2, R151.1
unnamed: D29.2 (A), R113.2
unnamed: D31.2 (A), R120.2
unnamed: D33.2 (A), R125.2
unnamed: D37.2 (A), R136.2
unnamed: D38.2 (A), R137.2
unnamed: D39.2 (A), R138.2
unnamed: D42.2 (A), R148.2
unnamed: D43.2 (A), R149.2
unnamed: J45.2, R116.1
unnamed: J45.3, R112.2
unnamed: J46.2, R118.1
unnamed: J46.3, R117.2
unnamed: J47.2, R123.1
unnamed: J47.3, R122.2
unnamed: J48.2, R129.1
unnamed: J48.3, R127.2
unnamed: J49.2, R131.1
unnamed: J49.3, R128.2
unnamed: J50.2, R132.1
unnamed: J50.3, R130.2
unnamed: J51.2, R144.1
unnamed: J51.3, R142.2
unnamed: J52.2, R145.1
unnamed: J52.3, R143.2
Probe: R61.2
Servo: R172.2, U33.3 (A)
Servo Out: D12.2 (A2), J57.3, U33.4 (B)
Stop_0: R115.2
Stop_1: R121.2
Stop_2: R126.2
Stop_3: R139.2
Stop_4: R140.2
Stop_5: R141.2
Stop_6: R150.2
Stop_7: R151.2

Notes on the sheet:
1 - Com 2 - NO 3 - NC
Endstops
BLTouch
