h3llf/Euclid-8/Controller/Fans.kicad_sch

## KiCad design Controller/Fans.kicad_sch (2026-03-28)

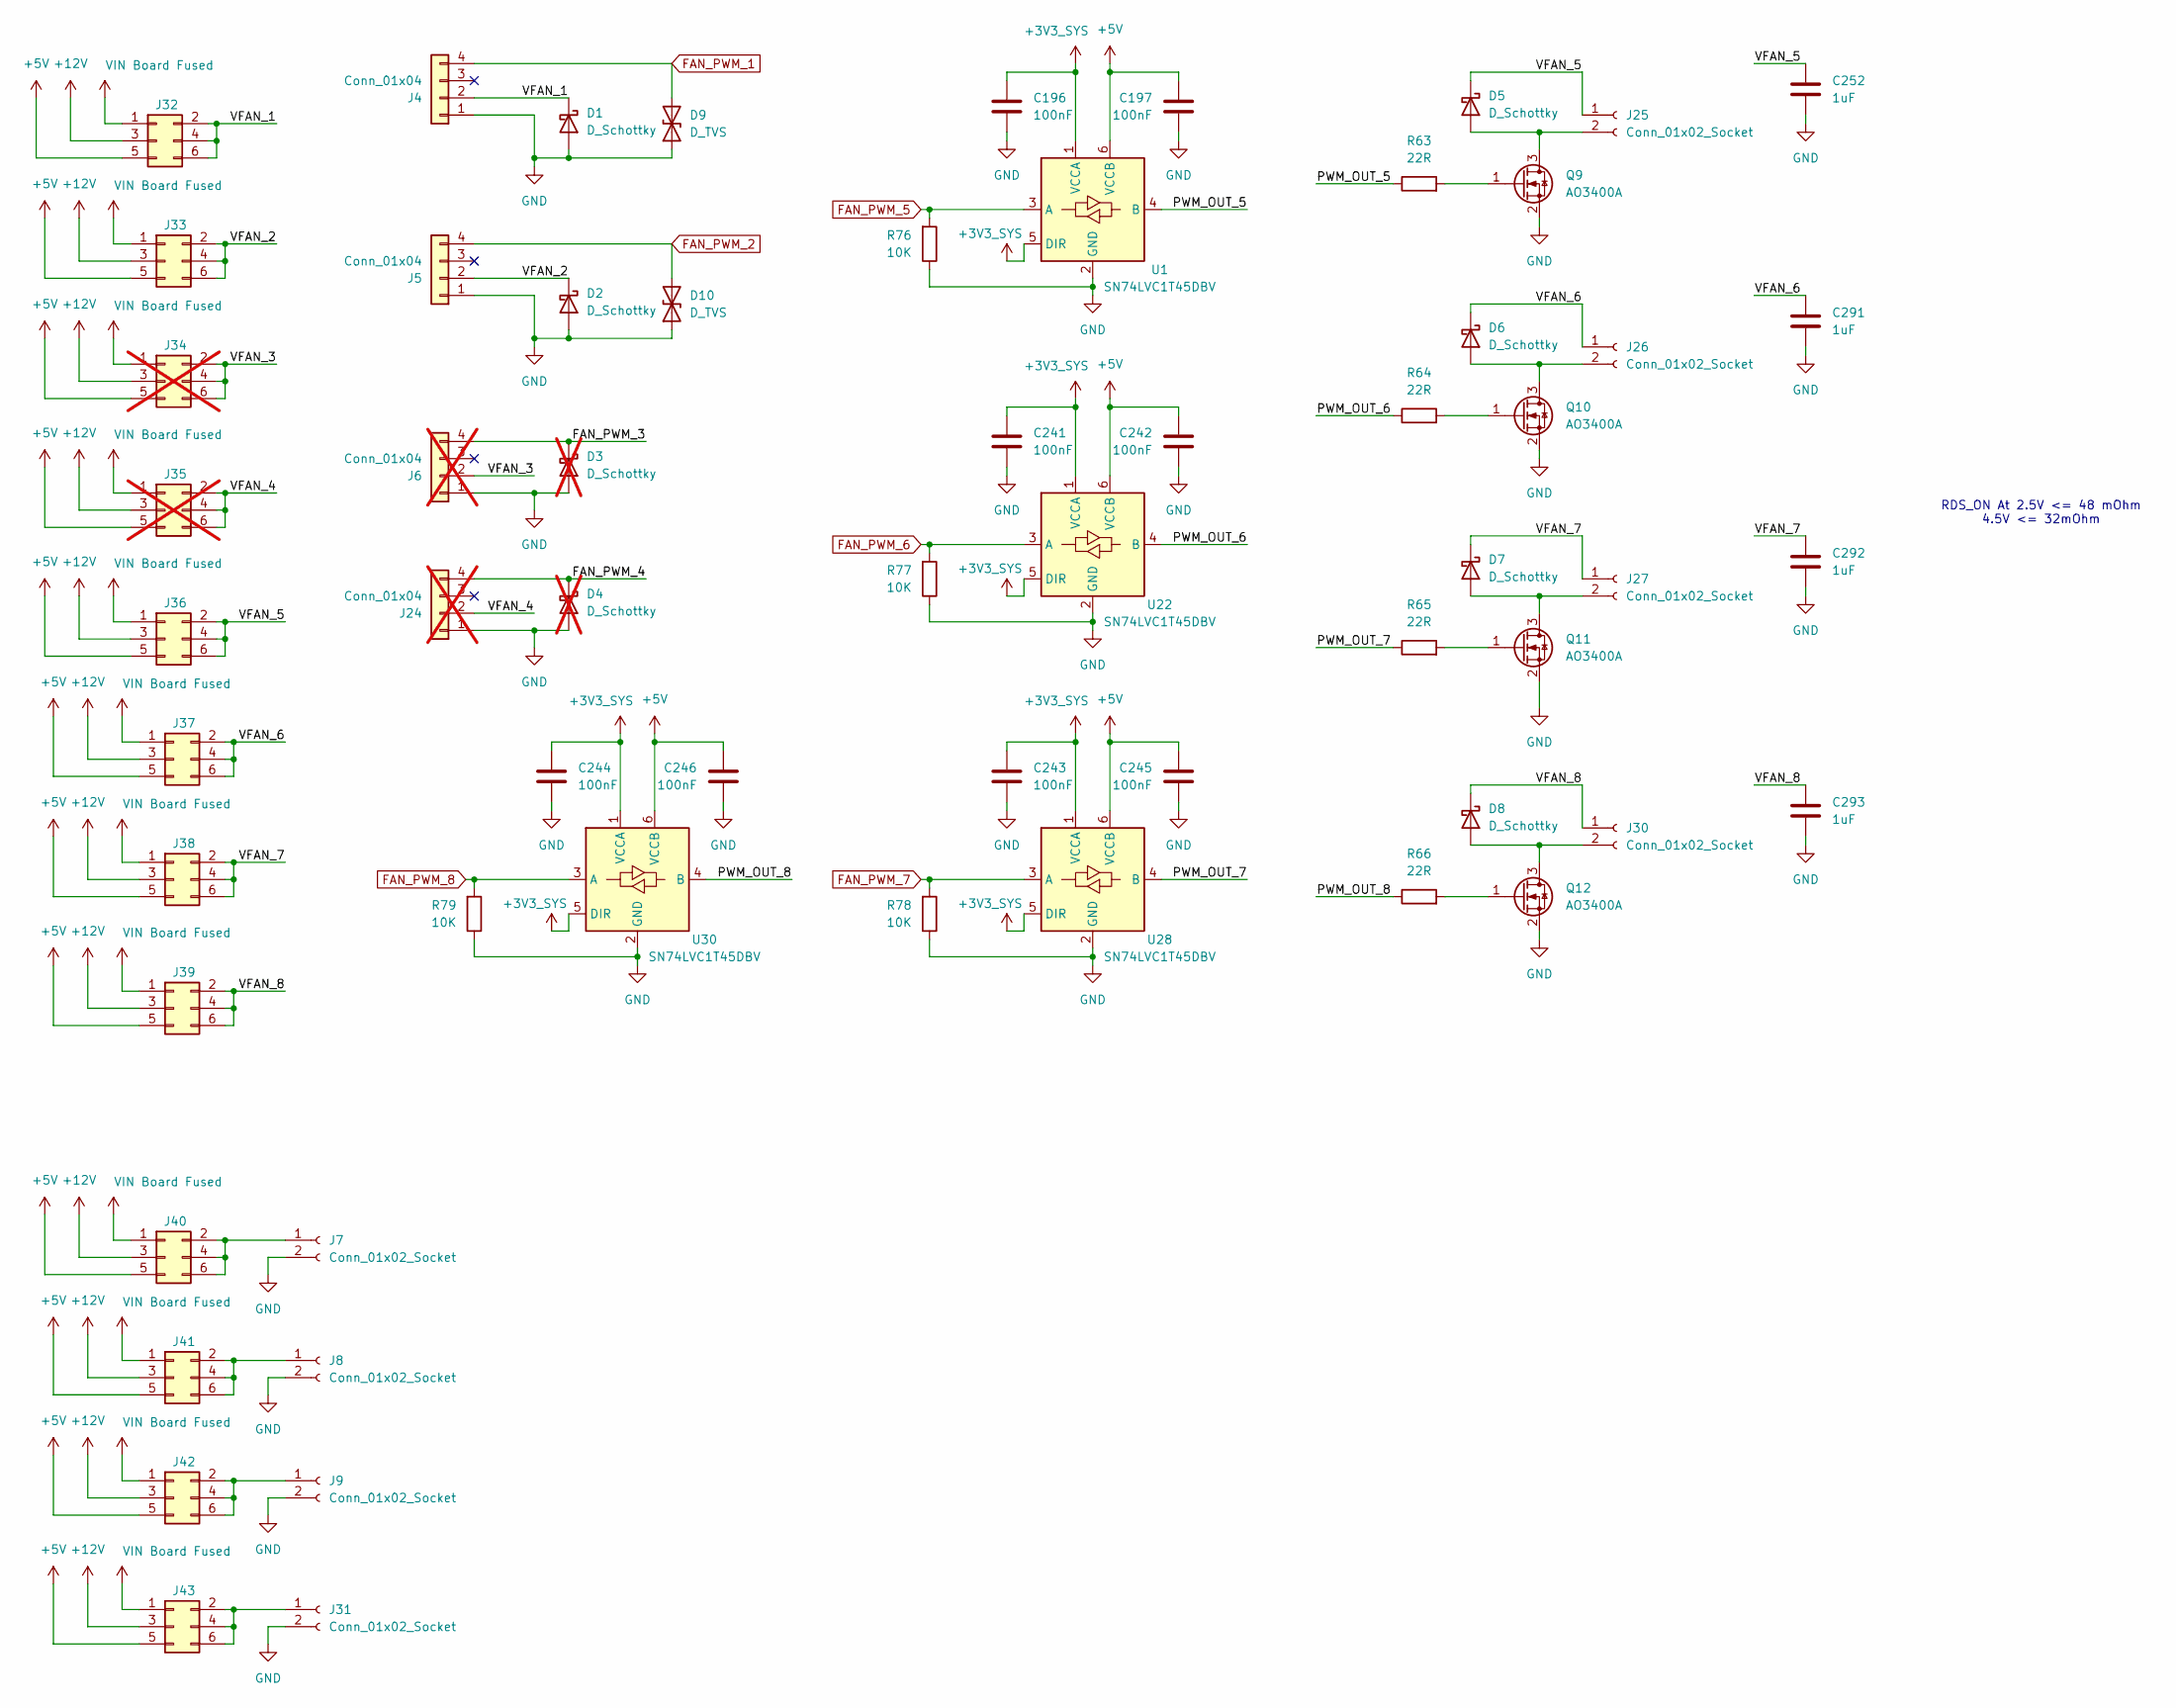
[picture p8: schematic Fans.kicad_sch]

Parts:
C196, C197, C241, C242, C243, C244, C245, C246: 100nF; C_0603_1608Metric
C252, C291, C292, C293: 1uF; C_1206_3216Metric; LCSC c13832
D1, D2, D5, D6, D7, D8: D_Schottky; D_SOD-123
D3, D4: D_Schottky; D_SOD-123; not fitted
D9, D10: D_TVS; D_SOD-882
J4, J5: Conn_01x04; FanPinHeader_1x04_P2.54mm_Vertical
J6, J24: Conn_01x04; FanPinHeader_1x04_P2.54mm_Vertical; not fitted
J7, J8, J9, J25, J26, J27, J30, J31: Conn_01x02_Socket; JST_XH_B2B-XH-A_1x02_P2.50mm_Vertical
J32, J33, J36, J37, J38, J39, J40, J41, J42, J43: Conn_02x03_Odd_Even; PinHeader_2x03_P2.54mm_Vertical
J34, J35: Conn_02x03_Odd_Even; PinHeader_2x03_P2.54mm_Vertical; not fitted
Q9, Q10, Q11, Q12: AO3400A; SOT-23
R63, R64, R65, R66: 22R; R_0603_1608Metric
R76, R77, R78, R79: 10K; R_0603_1608Metric
U1, U22, U28, U30: SN74LVC1T45DBV; SOT-23-6

Connections:
+3V3_SYS: C196.1, C241.1, C243.1, C244.1, U1.1 (VCCA), U1.5 (DIR), U22.1 (VCCA), U22.5 (DIR), U28.1 (VCCA), U28.5 (DIR), U30.1 (VCCA), U30.5 (DIR)
+5V: C197.1, C242.1, C245.1, C246.1, J32.5, J33.5, J34.5, J35.5, J36.5, J37.5, J38.5, J39.5, J40.5, J41.5, J42.5, J43.5, U1.6 (VCCB), U22.6 (VCCB), U28.6 (VCCB), U30.6 (VCCB)
+12V: J32.3, J33.3, J34.3, J35.3, J36.3, J37.3, J38.3, J39.3, J40.3, J41.3, J42.3, J43.3
FAN_PWM_1: D9.2 (A2), J4.4
FAN_PWM_2: D10.2 (A2), J5.4
FAN_PWM_3: D3.1 (K), J6.4
FAN_PWM_4: D4.1 (K), J24.4
FAN_PWM_5: R76.2, U1.3 (A)
FAN_PWM_6: R77.2, U22.3 (A)
FAN_PWM_7: R78.2, U28.3 (A)
FAN_PWM_8: R79.2, U30.3 (A)
GND: C196.2, C197.2, C241.2, C242.2, C243.2, C244.2, C245.2, C246.2, C252.2, C291.2, C292.2, C293.2, D1.2 (A), D2.2 (A), D3.2 (A), D4.2 (A), D9.1 (A1), D10.1 (A1), J4.1, J5.1, J6.1, J7.2, J8.2, J9.2, J24.1, J31.2, Q9.2 (S), Q10.2 (S), Q11.2 (S), Q12.2 (S), R76.1, R77.1, R78.1, R79.1, U1.2 (GND), U22.2 (GND), U28.2 (GND), U30.2 (GND)
unnamed: D5.2 (A), J25.2, Q9.3 (D)
unnamed: D6.2 (A), J26.2, Q10.3 (D)
unnamed: D7.2 (A), J27.2, Q11.3 (D)
unnamed: D8.2 (A), J30.2, Q12.3 (D)
unnamed: J31.1, J43.2, J43.4, J43.6
unnamed: J7.1, J40.2, J40.4, J40.6
unnamed: J8.1, J41.2, J41.4, J41.6
unnamed: J9.1, J42.2, J42.4, J42.6
unnamed: Q9.1 (G), R63.2
unnamed: Q10.1 (G), R64.2
unnamed: Q11.1 (G), R65.2
unnamed: Q12.1 (G), R66.2
PWM_OUT_5: R63.1, U1.4 (B)
PWM_OUT_6: R64.1, U22.4 (B)
PWM_OUT_7: R65.1, U28.4 (B)
PWM_OUT_8: R66.1, U30.4 (B)
VFAN_1: D1.1 (K), J4.2, J32.2, J32.4, J32.6
VFAN_2: D2.1 (K), J5.2, J33.2, J33.4, J33.6
VFAN_3: J6.2, J34.2, J34.4, J34.6
VFAN_4: J24.2, J35.2, J35.4, J35.6
VFAN_5: C252.1, D5.1 (K), J25.1, J36.2, J36.4, J36.6
VFAN_6: C291.1, D6.1 (K), J26.1, J37.2, J37.4, J37.6
VFAN_7: C292.1, D7.1 (K), J27.1, J38.2, J38.4, J38.6
VFAN_8: C293.1, D8.1 (K), J30.1, J39.2, J39.4, J39.6
VIN Board Fused: J32.1, J33.1, J34.1, J35.1, J36.1, J37.1, J38.1, J39.1, J40.1, J41.1, J42.1, J43.1

Notes on the sheet:
RDS_ON At 2.5V <= 48 mOhm 4.5V <= 32mOhm
