h3llf/Euclid-8/Controller/GPMC_Interface.kicad_sch

## KiCad design Controller/GPMC_Interface.kicad_sch (2026-05-04)

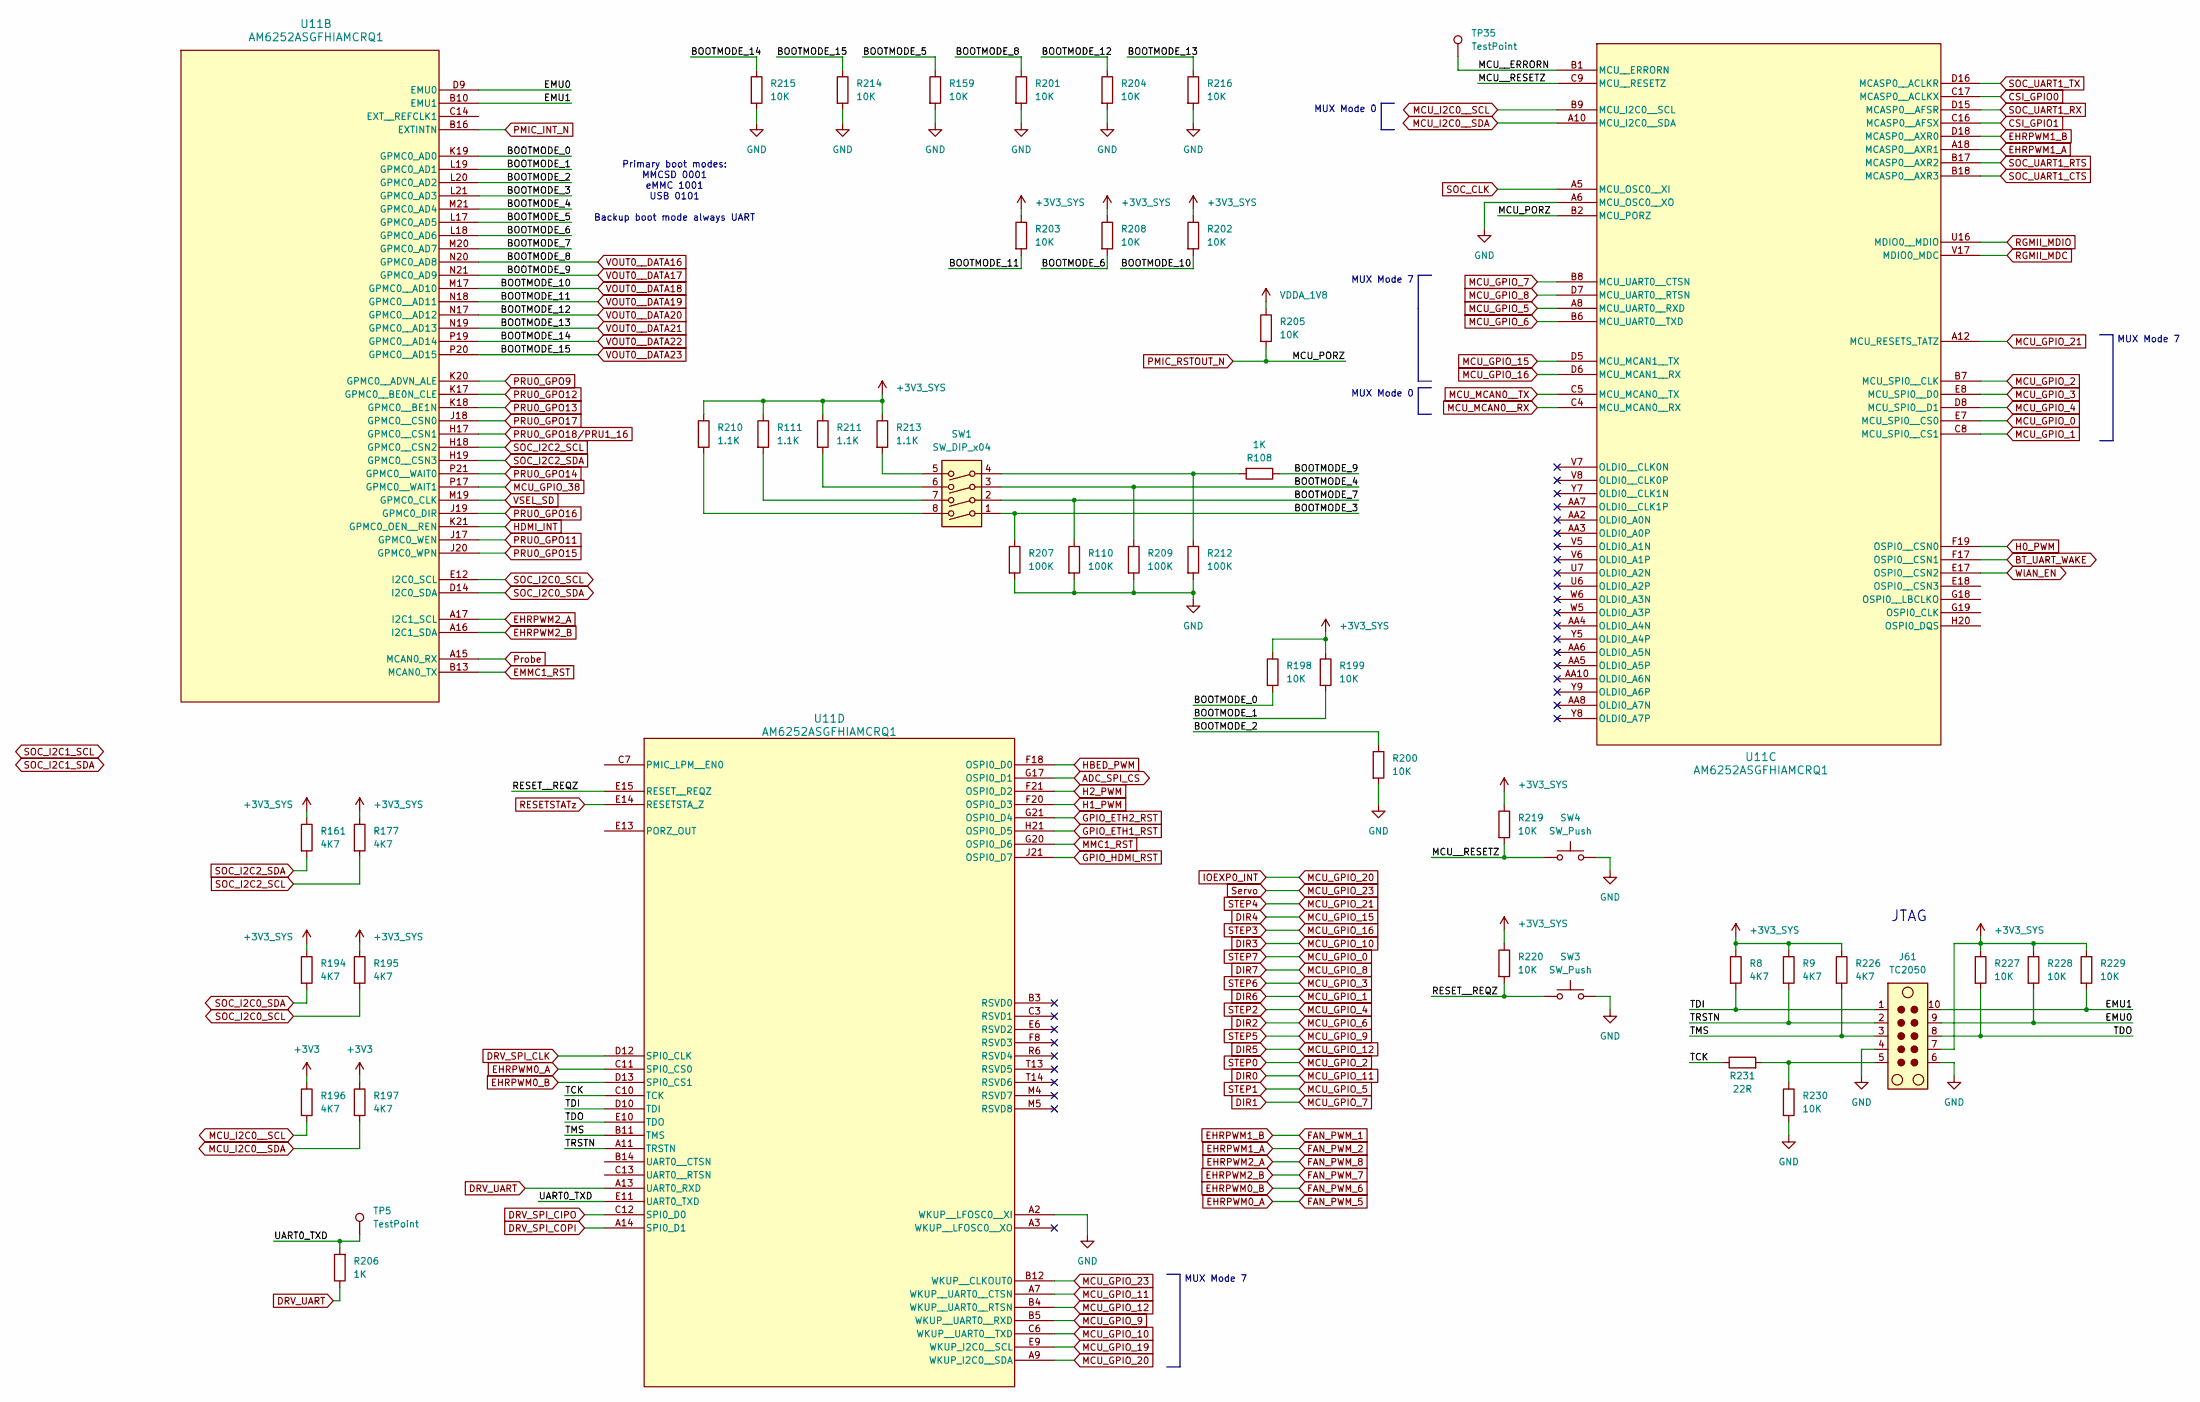
[picture p9: schematic GPMC_Interface.kicad_sch]

Parts:
J61: TC2050; Tag-Connect_TC2050-IDC-NL_2x05_P1.27mm_Vertical
R8, R9, R161, R177, R194, R195, R196, R197, R226: 4K7; R_0603_1608Metric
R108, R206: 1K; R_0402_1005Metric
R110, R207, R209, R212: 100K; R_0402_1005Metric
R111, R210, R211, R213: 1.1K; R_0402_1005Metric
R159, R198, R199, R200, R201, R202, R203, R204, R205, R208, R214, R215, R216, R219, R220: 10K; R_0402_1005Metric
R227, R228, R229, R230: 10K; R_0603_1608Metric
R231: 22R; R_0402_1005Metric
SW1: SW_DIP_x04; SW_DIP_SPSTx04_Slide_KingTek_DSHP04TS_W7.62mm_P1.27mm
SW3, SW4: SW_Push; SW_Push_1P1T_NO_Vertical_Wuerth_434133025816
TP5: TestPoint; TestPoint_THTPad_D2.0mm_Drill1.0mm
TP35: TestPoint; TestPoint_Pad_D1.5mm
U11: AM6252ASGFHIAMCRQ1; FCBGA441_AMC_TEX

Connections:
+3V3: R196.1, R197.1
+3V3_SYS: J61.7, R8.1, R9.1, R111.1, R161.1, R177.1, R194.1, R195.1, R198.1, R199.1, R202.1, R203.1, R208.1, R210.1, R211.1, R213.1, R219.1, R220.1, R226.1, R227.1, R228.1, R229.1
ADC_SPI_CS: U11.G17 (OSPI0_D1)
BOOTMODE_0: R198.2, U11.K19 (GPMC0_AD0)
BOOTMODE_1: R199.2, U11.L19 (GPMC0_AD1)
BOOTMODE_2: R200.1, U11.L20 (GPMC0_AD2)
BOOTMODE_3: R207.1, SW1.1, U11.L21 (GPMC0_AD3)
BOOTMODE_4: R209.1, SW1.3, U11.M21 (GPMC0_AD4)
BOOTMODE_5: R159.1, U11.L17 (GPMC0_AD5)
BOOTMODE_6: R208.2, U11.L18 (GPMC0_AD6)
BOOTMODE_7: R110.1, SW1.2, U11.M20 (GPMC0_AD7)
BT_UART_WAKE: U11.F17 (OSPI0__CSN1)
CSI_GPIO0: U11.C17 (MCASP0__ACLKX)
CSI_GPIO1: U11.C16 (MCASP0__AFSX)
DIR0: U11.A7 (WKUP__UART0__CTSN)
DIR1: U11.B8 (MCU_UART0__CTSN)
DIR2: U11.B6 (MCU_UART0__TXD)
DIR3: U11.C6 (WKUP__UART0__TXD)
DIR4: U11.D5 (MCU_MCAN1__TX)
DIR5: U11.B4 (WKUP__UART0__RTSN)
DIR6: U11.C8 (MCU_SPI0__CS1)
DIR7: U11.D7 (MCU_UART0__RTSN)
DRV_SPI_CIPO: U11.C12 (SPI0_D0)
DRV_SPI_CLK: U11.D12 (SPI0_CLK)
DRV_SPI_COPI: U11.A14 (SPI0_D1)
DRV_UART: R206.1, U11.A13 (UART0_RXD)
EHRPWM0_A: U11.C11 (SPI0_CS0)
EHRPWM0_B: U11.D13 (SPI0_CS1)
EHRPWM1_A: U11.A18 (MCASP0__AXR1)
EHRPWM1_B: U11.D18 (MCASP0__AXR0)
EHRPWM2_A: U11.A17 (I2C1_SCL)
EHRPWM2_B: U11.A16 (I2C1_SDA)
EMMC1_RST: U11.B13 (MCAN0_TX)
EMU0: J61.9, R228.2, U11.D9 (EMU0)
EMU1: J61.10, R229.2, U11.B10 (EMU1)
GND: J61.4, J61.6, R110.2, R159.2, R200.2, R201.2, R204.2, R207.2, R209.2, R212.2, R214.2, R215.2, R216.2, R230.2, SW3.2, SW4.2, U11.A2 (WKUP__LFOSC0__XI), U11.A6 (MCU_OSC0__XO)
GPIO_ETH1_RST: U11.H21 (OSPI0_D5)
GPIO_ETH2_RST: U11.G21 (OSPI0_D4)
GPIO_HDMI_RST: U11.J21 (OSPI0_D7)
H0_PWM: U11.F19 (OSPI0__CSN0)
H1_PWM: U11.F20 (OSPI0_D3)
H2_PWM: U11.F21 (OSPI0_D2)
HBED_PWM: U11.F18 (OSPI0_D0)
HDMI_INT: U11.K21 (GPMC0_OEN__REN)
IOEXP0_INT: U11.A9 (WKUP_I2C0__SDA)
MCU_GPIO_0: U11.E7 (MCU_SPI0__CS0)
MCU_GPIO_2: U11.B7 (MCU_SPI0__CLK)
MCU_GPIO_3: U11.E8 (MCU_SPI0__D0)
MCU_GPIO_4: U11.D8 (MCU_SPI0__D1)
MCU_GPIO_5: U11.A8 (MCU_UART0__RXD)
MCU_GPIO_9: U11.B5 (WKUP__UART0__RXD)
MCU_GPIO_16: U11.D6 (MCU_MCAN1__RX)
MCU_GPIO_19: U11.E9 (WKUP_I2C0__SCL)
MCU_GPIO_21: U11.A12 (MCU_RESETS_TATZ)
MCU_GPIO_23: U11.B12 (WKUP__CLKOUT0)
MCU_GPIO_38: U11.P17 (GPMC0__WAIT1)
MCU_I2C0__SCL: R196.2, U11.B9 (MCU_I2C0__SCL)
MCU_I2C0__SDA: R197.2, U11.A10 (MCU_I2C0__SDA)
MCU_MCAN0__RX: U11.C4 (MCU_MCAN0__RX)
MCU_MCAN0__TX: U11.C5 (MCU_MCAN0__TX)
MCU__ERRORN: TP35.1, U11.B1 (MCU__ERRORN)
MCU__RESETZ: R219.2, SW4.1, U11.C9 (MCU__RESETZ)
MMC1_RST: U11.G20 (OSPI0_D6)
unnamed: J61.5, R230.1, R231.2
unnamed: R108.2, R212.1, SW1.4
unnamed: R111.2, SW1.7
unnamed: R210.2, SW1.8
unnamed: R211.2, SW1.6
unnamed: R213.2, SW1.5
PMIC_INT_N: U11.B16 (EXTINTN)
PMIC_RSTOUT_N: R205.2, U11.B2 (MCU_PORZ)
PRU0_GPO9: U11.K20 (GPMC0__ADVN_ALE)
PRU0_GPO11: U11.J17 (GPMC0_WEN)
PRU0_GPO12: U11.K17 (GPMC0__BE0N_CLE)
PRU0_GPO13: U11.K18 (GPMC0__BE1N)
PRU0_GPO14: U11.P21 (GPMC0__WAIT0)
PRU0_GPO15: U11.J20 (GPMC0_WPN)
PRU0_GPO16: U11.J19 (GPMC0_DIR)
PRU0_GPO17: U11.J18 (GPMC0__CSN0)
PRU0_GPO18/PRU1_16: U11.H17 (GPMC0__CSN1)
Probe: U11.A15 (MCAN0_RX)
RESETSTATz: U11.E14 (RESETSTA_Z)
RESET__REQZ: R220.2, SW3.1, U11.E15 (RESET__REQZ)
RGMII_MDC: U11.V17 (MDIO0_MDC)
RGMII_MDIO: U11.U16 (MDIO0__MDIO)
SOC_CLK: U11.A5 (MCU_OSC0__XI)
SOC_I2C0_SCL: R195.2, U11.E12 (I2C0_SCL)
SOC_I2C0_SDA: R194.2, U11.D14 (I2C0_SDA)
SOC_I2C2_SCL: R177.2, U11.H18 (GPMC0__CSN2)
SOC_I2C2_SDA: R161.2, U11.H19 (GPMC0__CSN3)
SOC_UART1_CTS: U11.B18 (MCASP0__AXR3)
SOC_UART1_RTS: U11.B17 (MCASP0__AXR2)
SOC_UART1_RX: U11.D15 (MCASP0__AFSR)
SOC_UART1_TX: U11.D16 (MCASP0__ACLKR)
TCK: R231.1, U11.C10 (TCK)
TDI: J61.1, R8.2, U11.D10 (TDI)
TDO: J61.8, R227.2, U11.E10 (TDO)
TMS: J61.3, R226.2, U11.B11 (TMS)
TRSTN: J61.2, R9.2, U11.A11 (TRSTN)
UART0_TXD: R206.2, TP5.1, U11.E11 (UART0_TXD)
VDDA_1V8: R205.1
VOUT0__DATA16: R201.1, U11.N20 (GPMC0_AD8)
VOUT0__DATA17: R108.1, U11.N21 (GPMC0_AD9)
VOUT0__DATA18: R202.2, U11.M17 (GPMC0__AD10)
VOUT0__DATA19: R203.2, U11.N18 (GPMC0__AD11)
VOUT0__DATA20: R204.1, U11.N17 (GPMC0__AD12)
VOUT0__DATA21: R216.1, U11.N19 (GPMC0__AD13)
VOUT0__DATA22: R215.1, U11.P19 (GPMC0__AD14)
VOUT0__DATA23: R214.1, U11.P20 (GPMC0__AD15)
VSEL_SD: U11.M19 (GPMC0_CLK)
WlAN_EN: U11.E17 (OSPI0__CSN2)

Notes on the sheet:
MUX Mode 0
JTAG
MUX Mode 7
Primary boot modes: MMCSD 0001 eMMC 1001 USB 0101 Backup boot mode always UART
