h3llf/Euclid-8/Controller/Heaters.kicad_sch

## KiCad design Controller/Heaters.kicad_sch (2026-04-20)

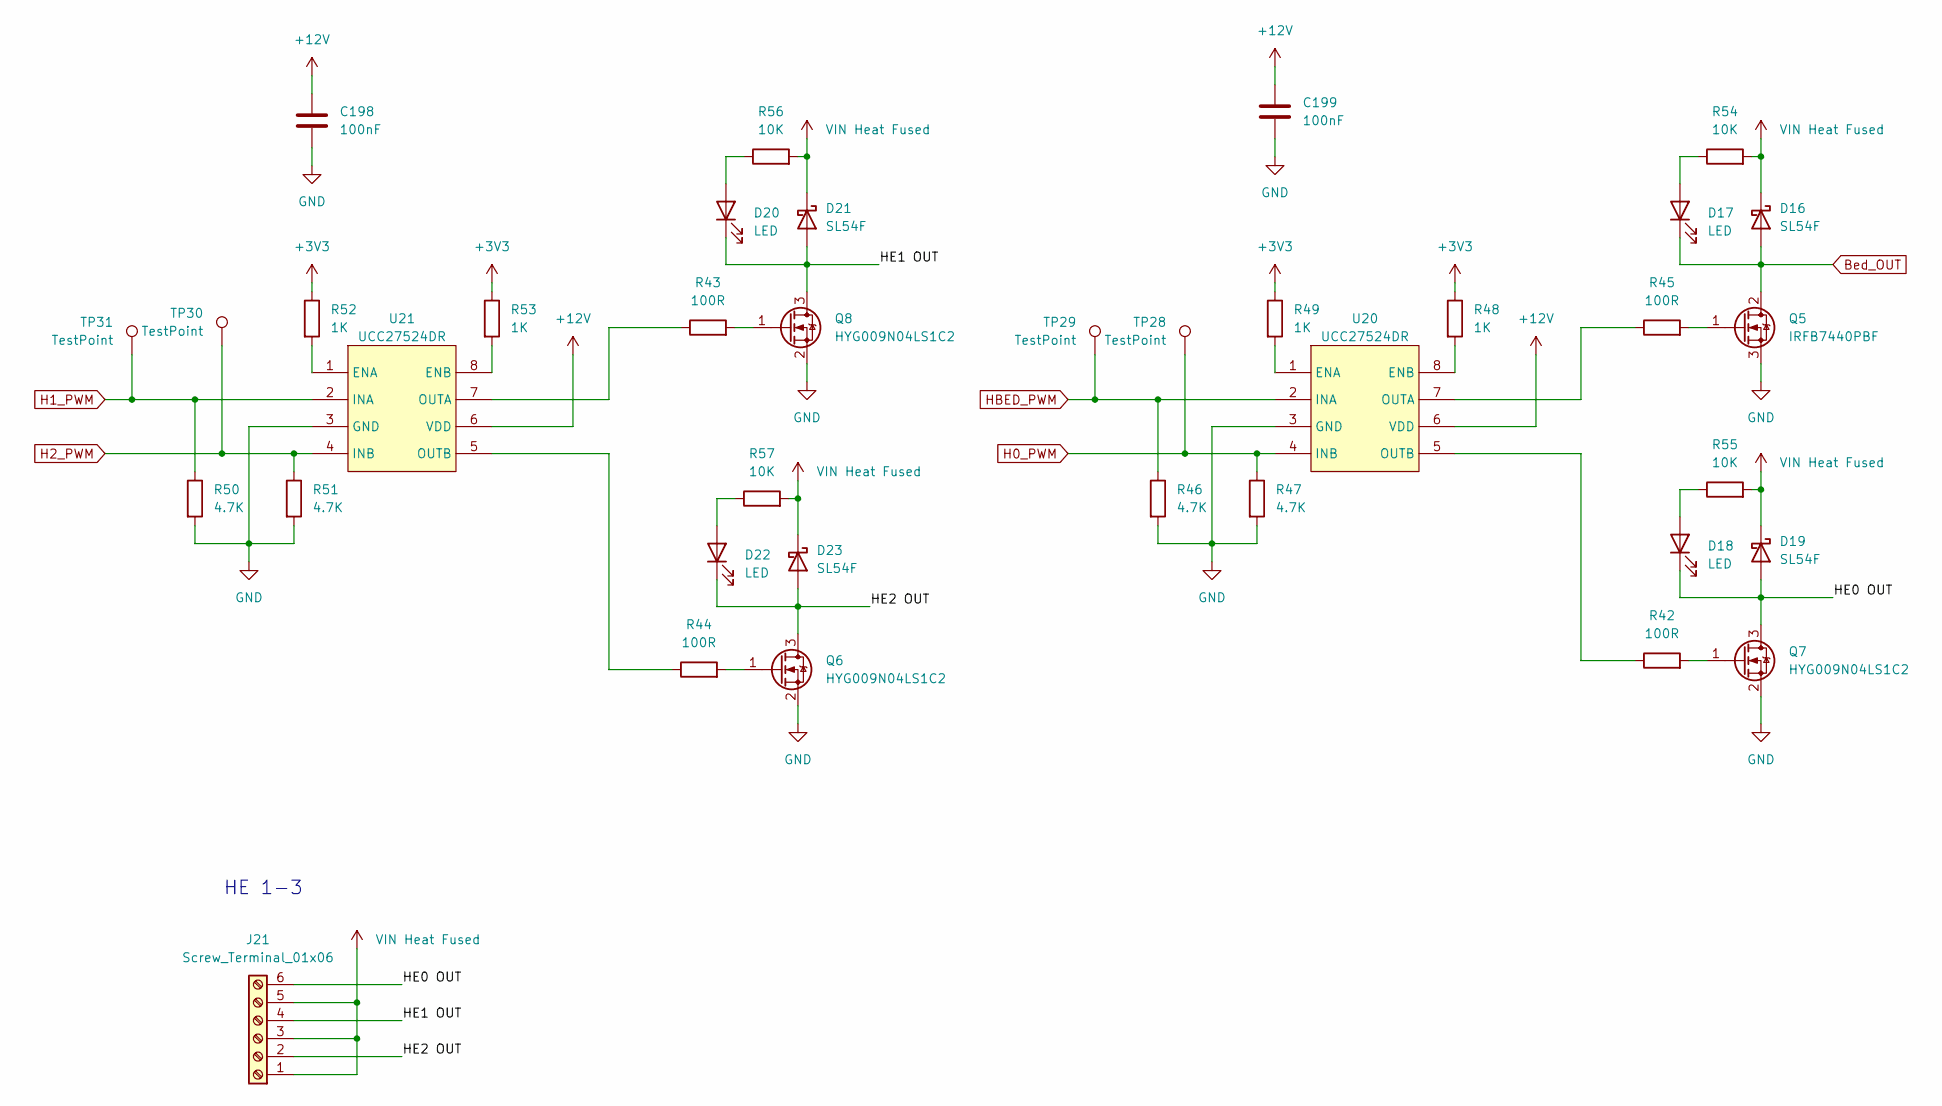
[picture p10: schematic Heaters.kicad_sch]

Parts:
C198, C199: 100nF; C_0603_1608Metric
D16, D19, D21, D23: SL54F; D_SMA; LCSC C113939
D17, D18, D20, D22: LED; LED_0603_1608Metric; LCSC C965799
J21: Screw_Terminal_01x06; TerminalBlock_Phoenix_MKDS-1,5-6_1x06_P5.00mm_Horizontal
Q5: IRFB7440PBF; TO-220-3_Vertical
Q6, Q7, Q8: HYG009N04LS1C2; PQFN-8-EP_6x5mm_P1.27mm_Generic; LCSC C2890387
R42, R43, R44, R45: 100R; R_0603_1608Metric
R46, R47, R50, R51: 4.7K; R_0603_1608Metric
R48, R49, R52, R53: 1K; R_0603_1608Metric
R54, R55, R56, R57: 10K; R_0603_1608Metric
TP28, TP29, TP30, TP31: TestPoint; TestPoint_Pad_D1.5mm
U20: UCC27524DR; SOIC-8_3.9x4.9mm_P1.27mm
U21: UCC27524DR; SOIC-8_3.9x4.9mm_P1.27mm; LCSC C465729

Connections:
+3V3: R48.1, R49.1, R52.1, R53.1
+12V: C198.1, C199.1, U20.6 (VDD), U21.6 (VDD)
Bed_OUT: D16.2 (A), D17.1 (K), Q5.2 (D)
GND: C198.2, C199.2, Q5.3 (S), Q6.2 (S), Q7.2 (S), Q8.2 (S), R46.2, R47.2, R50.2, R51.2, U20.3 (GND), U21.3 (GND)
H0_PWM: R47.1, TP28.1, U20.4 (INB)
H1_PWM: R50.1, TP31.1, U21.2 (INA)
H2_PWM: R51.1, TP30.1, U21.4 (INB)
HBED_PWM: R46.1, TP29.1, U20.2 (INA)
HE0 OUT: D18.1 (K), D19.2 (A), J21.6, Q7.3 (D)
HE1 OUT: D20.1 (K), D21.2 (A), J21.4, Q8.3 (D)
HE2 OUT: D22.1 (K), D23.2 (A), J21.2, Q6.3 (D)
unnamed: D17.2 (A), R54.1
unnamed: D18.2 (A), R55.1
unnamed: D20.2 (A), R56.1
unnamed: D22.2 (A), R57.1
unnamed: Q5.1 (G), R45.2
unnamed: Q6.1 (G), R44.2
unnamed: Q7.1 (G), R42.2
unnamed: Q8.1 (G), R43.2
unnamed: R42.1, U20.5 (OUTB)
unnamed: R43.1, U21.7 (OUTA)
unnamed: R44.1, U21.5 (OUTB)
unnamed: R45.1, U20.7 (OUTA)
unnamed: R48.2, U20.8 (ENB)
unnamed: R49.2, U20.1 (ENA)
unnamed: R52.2, U21.1 (ENA)
unnamed: R53.2, U21.8 (ENB)
VIN Heat Fused: D16.1 (K), D19.1 (K), D21.1 (K), D23.1 (K), J21.1, J21.3, J21.5, R54.2, R55.2, R56.2, R57.2

Notes on the sheet:
HE 1-3
