h3llf/Euclid-8/Controller/IO_Expansion.kicad_sch

## KiCad design Controller/IO_Expansion.kicad_sch (2026-03-28)

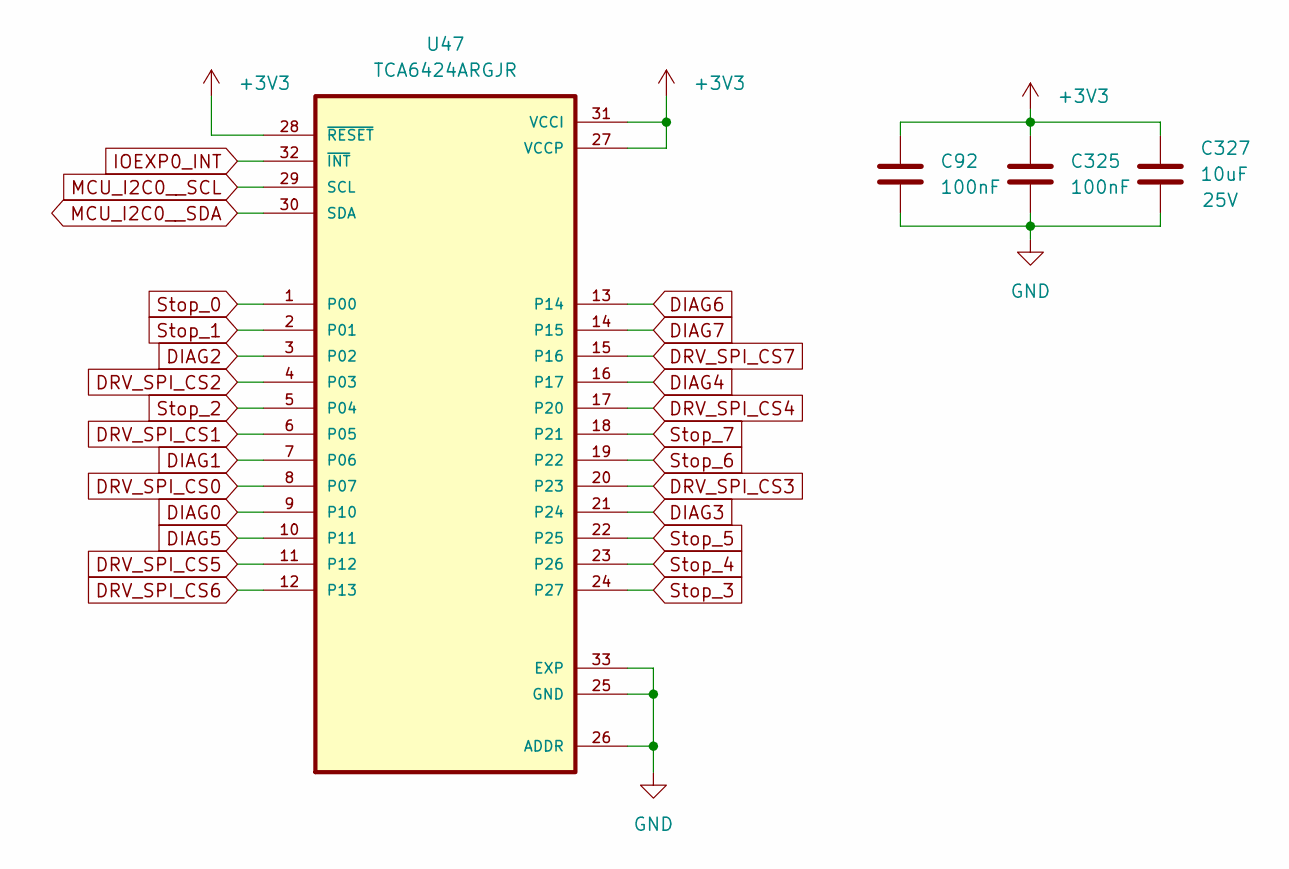
[picture p11: schematic IO_Expansion.kicad_sch]

Parts:
C92, C325: 100nF; C_0603_1608Metric
C327: 10uF; C_0603_1608Metric; voltage 25V; LCSC C96446
U47: TCA6424ARGJR; QFN-32-1EP_5x5mm_P0.5mm_EP3.1x3.1mm

Connections:
+3V3: C92.1, C325.1, C327.1, U47.27 (VCCP), U47.28 (~RESET), U47.31 (VCCI)
DIAG0: U47.9 (P10)
DIAG1: U47.7 (P06)
DIAG2: U47.3 (P02)
DIAG3: U47.21 (P24)
DIAG4: U47.16 (P17)
DIAG5: U47.10 (P11)
DIAG6: U47.13 (P14)
DIAG7: U47.14 (P15)
DRV_SPI_CS0: U47.8 (P07)
DRV_SPI_CS1: U47.6 (P05)
DRV_SPI_CS2: U47.4 (P03)
DRV_SPI_CS3: U47.20 (P23)
DRV_SPI_CS4: U47.17 (P20)
DRV_SPI_CS5: U47.11 (P12)
DRV_SPI_CS6: U47.12 (P13)
DRV_SPI_CS7: U47.15 (P16)
GND: C92.2, C325.2, C327.2, U47.25 (GND), U47.26 (ADDR), U47.33 (EXP)
IOEXP0_INT: U47.32 (~INT)
MCU_I2C0__SCL: U47.29 (SCL)
MCU_I2C0__SDA: U47.30 (SDA)
Stop_0: U47.1 (P00)
Stop_1: U47.2 (P01)
Stop_2: U47.5 (P04)
Stop_3: U47.24 (P27)
Stop_4: U47.23 (P26)
Stop_5: U47.22 (P25)
Stop_6: U47.19 (P22)
Stop_7: U47.18 (P21)
