h3llf/Euclid-8/Controller/M.2_KeyE_WIFI.kicad_sch

## KiCad design Controller/M.2_KeyE_WIFI.kicad_sch (2026-04-20)

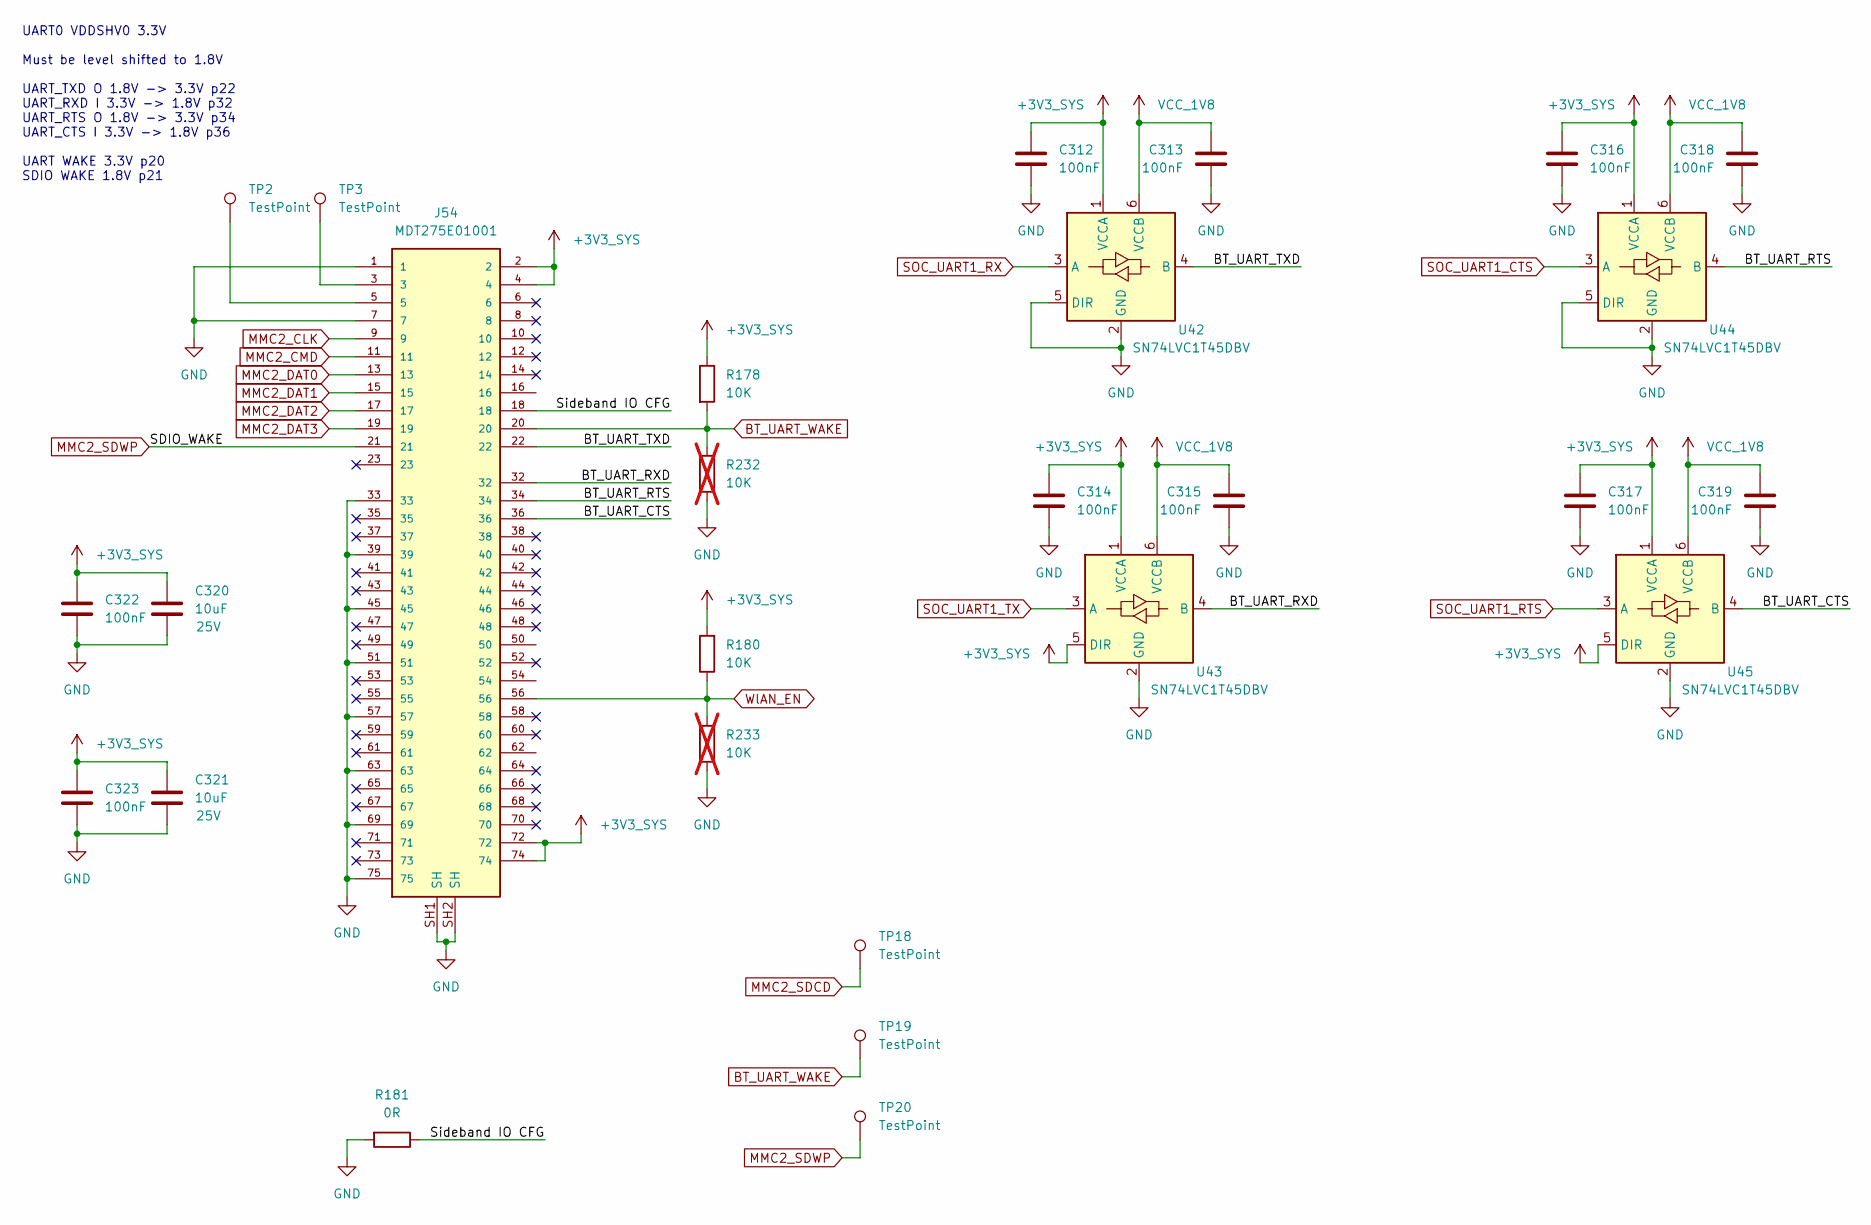
[picture p12: schematic M.2_KeyE_WIFI.kicad_sch]

Parts:
C312, C313, C314, C315, C316, C317, C318, C319, C322, C323: 100nF; C_0603_1608Metric
C320, C321: 10uF; C_0603_1608Metric; voltage 25V; LCSC C96446
J54: MDT275E01001; AMPHENOL_MDT275E01001; PARTREV 7
R178, R180: 10K; R_0603_1608Metric
R181: 0R; R_0603_1608Metric
R232, R233: 10K; R_0603_1608Metric; not fitted
TP2, TP3: TestPoint; TestPoint_Pad_1.5x1.5mm
TP18, TP19, TP20: TestPoint; TestPoint_Pad_D1.0mm
U42, U43, U44, U45: SN74LVC1T45DBV; SOT-23-6

Connections:
+3V3_SYS: C312.1, C314.1, C316.1, C317.1, C320.1, C321.1, C322.1, C323.1, J54.2, J54.4, J54.72, J54.74, R178.1, R180.2, U42.1 (VCCA), U43.1 (VCCA), U43.5 (DIR), U44.1 (VCCA), U45.1 (VCCA), U45.5 (DIR)
BT_UART_CTS: J54.36, U45.4 (B)
BT_UART_RTS: J54.34, U44.4 (B)
BT_UART_RXD: J54.32, U43.4 (B)
BT_UART_TXD: J54.22, U42.4 (B)
BT_UART_WAKE: J54.20, R178.2, R232.1, TP19.1
GND: C312.2, C313.2, C314.2, C315.2, C316.2, C317.2, C318.2, C319.2, C320.2, C321.2, C322.2, C323.2, J54.1, J54.7, J54.33, J54.39, J54.45, J54.51, J54.57, J54.63, J54.69, J54.75, J54.SH1 (SH), J54.SH2 (SH), R181.2, R232.2, R233.2, U42.2 (GND), U42.5 (DIR), U43.2 (GND), U44.2 (GND), U44.5 (DIR), U45.2 (GND)
MMC2_CLK: J54.9
MMC2_CMD: J54.11
MMC2_DAT0: J54.13
MMC2_DAT1: J54.15
MMC2_DAT2: J54.17
MMC2_DAT3: J54.19
MMC2_SDCD: TP18.1
MMC2_SDWP: J54.21, TP20.1
unnamed: J54.3, TP3.1
unnamed: J54.5, TP2.1
SOC_UART1_CTS: U44.3 (A)
SOC_UART1_RTS: U45.3 (A)
SOC_UART1_RX: U42.3 (A)
SOC_UART1_TX: U43.3 (A)
Sideband IO CFG: J54.18, R181.1
VCC_1V8: C313.1, C315.1, C318.1, C319.1, U42.6 (VCCB), U43.6 (VCCB), U44.6 (VCCB), U45.6 (VCCB)
WlAN_EN: J54.56, R180.1, R233.1

Notes on the sheet:
UART0 VDDSHV0 3.3V Must be level shifted to 1.8V UART_TXD O 1.8V -> 3.3V p22 UART_RXD I 3.3V -> 1.8V p32 UART_RTS O 1.8V -> 3.3V p34 UART_CTS I 3.3V -> 1.8V p36 UART WAKE 3.3V p20 SDIO WAKE 1.8V p21
