h3llf/Euclid-8/Controller/MMC.kicad_sch

## KiCad design Controller/MMC.kicad_sch (2026-04-20)

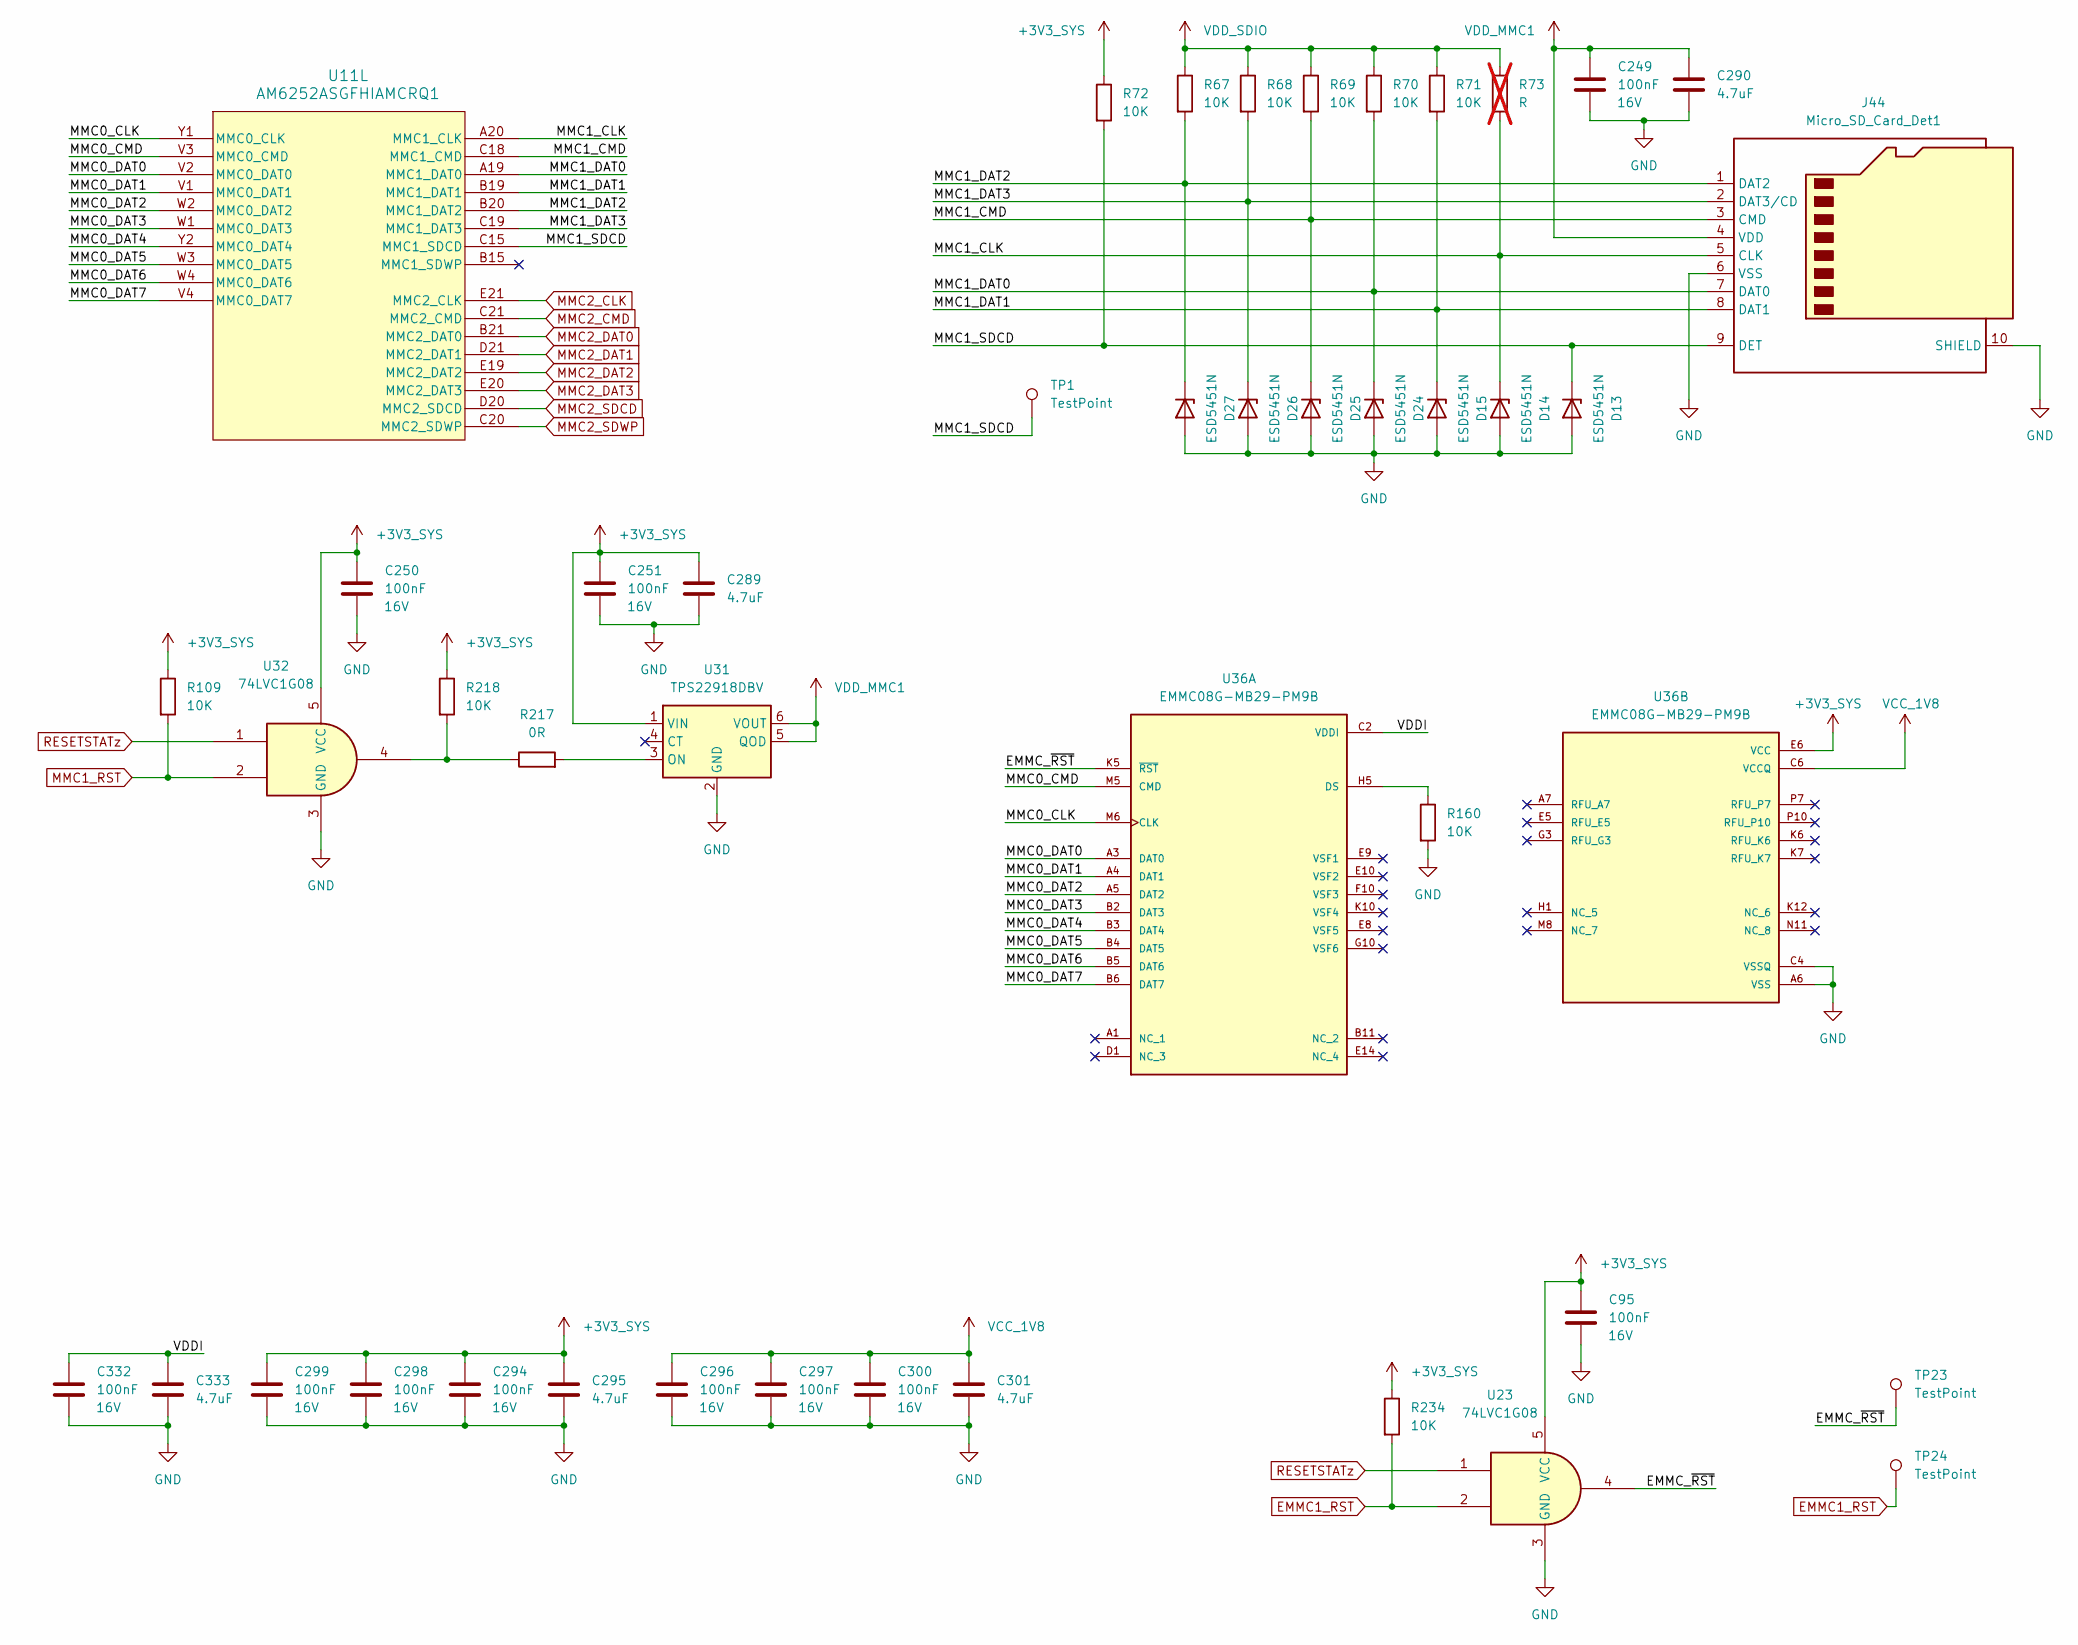
[picture p13: schematic MMC.kicad_sch]

Parts:
C95, C249, C250, C251, C294, C296, C297, C298, C299, C300, C332: 100nF; C_0402_1005Metric; Voltage 16V
C289, C290, C295, C301, C333: 4.7uF; C_0603_1608Metric; LCSC C69335
D13, D14, D15, D24, D25, D26, D27: ESD5451N; D_SOD-882; LCSC C2936977
J44: Micro_SD_Card_Det1; TF-115
R67, R68, R69, R70, R71, R72, R109, R160, R218, R234: 10K; R_0603_1608Metric
R73: R; R_0603_1608Metric; not fitted
R217: 0R; R_0603_1608Metric
TP1: TestPoint; TestPoint_Pad_2.0x2.0mm
TP23, TP24: TestPoint; TestPoint_Pad_D1.5mm
U11: AM6252ASGFHIAMCRQ1; FCBGA441_AMC_TEX
U23, U32: 74LVC1G08; Texas_R-PDSO-G5_DCK-5; LCSC2 C2983745 (UMW) or C2870856 (TI)
U31: TPS22918DBV; SOT-23-6
U36: EMMC08G-MB29-PM9B; LFBGA-153_11.5x13mm_Layout14x14_P0.5mm; PARTREV N/A

Connections:
+3V3_SYS: C95.1, C250.1, C251.1, C289.1, C294.1, C295.1, C298.1, C299.1, R72.1, R109.1, R218.1, R234.1, U23.5 (VCC), U31.1 (VIN), U32.5 (VCC), U36.E6 (VCC), U36.F5 (VCC), U36.J10 (VCC), U36.K9 (VCC)
EMMC1_RST: R234.2, TP24.1, U23.2
EMMC_~RST: TP23.1, U23.4, U36.K5 (~RST)
GND: C95.2, C249.2, C250.2, C251.2, C289.2, C290.2, C294.2, C295.2, C296.2, C297.2, C298.2, C299.2, C300.2, C301.2, C332.2, C333.2, D13.2 (A), D14.2 (A), D15.2 (A), D24.2 (A), D25.2 (A), D26.2 (A), D27.2 (A), J44.6 (VSS), J44.10 (SHIELD), R160.2, U23.3 (GND), U31.2 (GND), U32.3 (GND), U36.A6 (VSS), U36.C4 (VSSQ), U36.E7 (VSS), U36.G5 (VSS), U36.H10 (VSS), U36.J5 (VSS), U36.K8 (VSS), U36.N2 (VSSQ), U36.N5 (VSSQ), U36.P4 (VSSQ), U36.P6 (VSSQ)
MMC0_CLK: U11.Y1 (MMC0_CLK), U36.M6 (CLK)
MMC0_CMD: U11.V3 (MMC0_CMD), U36.M5 (CMD)
MMC0_DAT0: U11.V2 (MMC0_DAT0), U36.A3 (DAT0)
MMC0_DAT1: U11.V1 (MMC0_DAT1), U36.A4 (DAT1)
MMC0_DAT2: U11.W2 (MMC0_DAT2), U36.A5 (DAT2)
MMC0_DAT3: U11.W1 (MMC0_DAT3), U36.B2 (DAT3)
MMC0_DAT4: U11.Y2 (MMC0_DAT4), U36.B3 (DAT4)
MMC0_DAT5: U11.W3 (MMC0_DAT5), U36.B4 (DAT5)
MMC0_DAT6: U11.W4 (MMC0_DAT6), U36.B5 (DAT6)
MMC0_DAT7: U11.V4 (MMC0_DAT7), U36.B6 (DAT7)
MMC1_CLK: D14.1 (K), J44.5 (CLK), R73.2, U11.A20 (MMC1_CLK)
MMC1_CMD: D25.1 (K), J44.3 (CMD), R69.2, U11.C18 (MMC1_CMD)
MMC1_DAT0: D24.1 (K), J44.7 (DAT0), R70.2, U11.A19 (MMC1_DAT0)
MMC1_DAT1: D15.1 (K), J44.8 (DAT1), R71.2, U11.B19 (MMC1_DAT1)
MMC1_DAT2: D27.1 (K), J44.1 (DAT2), R67.2, U11.B20 (MMC1_DAT2)
MMC1_DAT3: D26.1 (K), J44.2 (DAT3/CD), R68.2, U11.C19 (MMC1_DAT3)
MMC1_RST: R109.2, U32.2
MMC1_SDCD: D13.1 (K), J44.9 (DET), R72.2, TP1.1, U11.C15 (MMC1_SDCD)
MMC2_CLK: U11.E21 (MMC2_CLK)
MMC2_CMD: U11.C21 (MMC2_CMD)
MMC2_DAT0: U11.B21 (MMC2_DAT0)
MMC2_DAT1: U11.D21 (MMC2_DAT1)
MMC2_DAT2: U11.E19 (MMC2_DAT2)
MMC2_DAT3: U11.E20 (MMC2_DAT3)
MMC2_SDCD: U11.D20 (MMC2_SDCD)
MMC2_SDWP: U11.C20 (MMC2_SDWP)
unnamed: R160.1, U36.H5 (DS)
unnamed: R217.1, R218.2, U32.4
unnamed: R217.2, U31.3 (ON)
unnamed: U36.A1 (NC_1), U36.A2 (NC_1), U36.A8 (NC_1), U36.A9 (NC_1), U36.A10 (NC_1), U36.A11 (NC_1), U36.A12 (NC_1), U36.A13 (NC_1), U36.A14 (NC_1), U36.B1 (NC_1), U36.B7 (NC_1), U36.B8 (NC_1), U36.B9 (NC_1), U36.B10 (NC_1)
unnamed: U36.B11 (NC_2), U36.B12 (NC_2), U36.B13 (NC_2), U36.B14 (NC_2), U36.C1 (NC_2), U36.C3 (NC_2), U36.C5 (NC_2), U36.C7 (NC_2), U36.C8 (NC_2), U36.C9 (NC_2), U36.C10 (NC_2), U36.C11 (NC_2), U36.C12 (NC_2), U36.C13 (NC_2), U36.C14 (NC_2)
unnamed: U36.D1 (NC_3), U36.D2 (NC_3), U36.D3 (NC_3), U36.D4 (NC_3), U36.D12 (NC_3), U36.D13 (NC_3), U36.D14 (NC_3), U36.E1 (NC_3), U36.E2 (NC_3), U36.E3 (NC_3), U36.E12 (NC_3), U36.E13 (NC_3)
unnamed: U36.E14 (NC_4), U36.F1 (NC_4), U36.F2 (NC_4), U36.F3 (NC_4), U36.F12 (NC_4), U36.F13 (NC_4), U36.F14 (NC_4), U36.G1 (NC_4), U36.G2 (NC_4), U36.G12 (NC_4), U36.G13 (NC_4), U36.G14 (NC_4)
unnamed: U36.H1 (NC_5), U36.H2 (NC_5), U36.H3 (NC_5), U36.H12 (NC_5), U36.H13 (NC_5), U36.H14 (NC_5), U36.J1 (NC_5), U36.J2 (NC_5), U36.J3 (NC_5), U36.J12 (NC_5), U36.J13 (NC_5), U36.J14 (NC_5), U36.K1 (NC_5), U36.K2 (NC_5), U36.K3 (NC_5)
unnamed: U36.K12 (NC_6), U36.K13 (NC_6), U36.K14 (NC_6), U36.L1 (NC_6), U36.L2 (NC_6), U36.L3 (NC_6), U36.L12 (NC_6), U36.L13 (NC_6), U36.L14 (NC_6), U36.M1 (NC_6), U36.M2 (NC_6), U36.M3 (NC_6), U36.M7 (NC_6)
unnamed: U36.M8 (NC_7), U36.M9 (NC_7), U36.M10 (NC_7), U36.M11 (NC_7), U36.M12 (NC_7), U36.M13 (NC_7), U36.M14 (NC_7), U36.N1 (NC_7), U36.N3 (NC_7), U36.N6 (NC_7), U36.N7 (NC_7), U36.N8 (NC_7), U36.N9 (NC_7), U36.N10 (NC_7)
unnamed: U36.N11 (NC_8), U36.N12 (NC_8), U36.N13 (NC_8), U36.N14 (NC_8), U36.P1 (NC_8), U36.P2 (NC_8), U36.P8 (NC_8), U36.P9 (NC_8), U36.P11 (NC_8), U36.P12 (NC_8), U36.P13 (NC_8), U36.P14 (NC_8)
RESETSTATz: U23.1, U32.1
VCC_1V8: C296.1, C297.1, C300.1, C301.1, U36.C6 (VCCQ), U36.M4 (VCCQ), U36.N4 (VCCQ), U36.P3 (VCCQ), U36.P5 (VCCQ)
VDDI: C332.1, C333.1, U36.C2 (VDDI)
VDD_MMC1: C249.1, C290.1, J44.4 (VDD), U31.5 (QOD), U31.6 (VOUT)
VDD_SDIO: R67.1, R68.1, R69.1, R70.1, R71.1, R73.1
