h3llf/Euclid-8/Controller/SOC_Ethernet2.kicad_sch

## KiCad design Controller/SOC_Ethernet2.kicad_sch (2026-03-28)

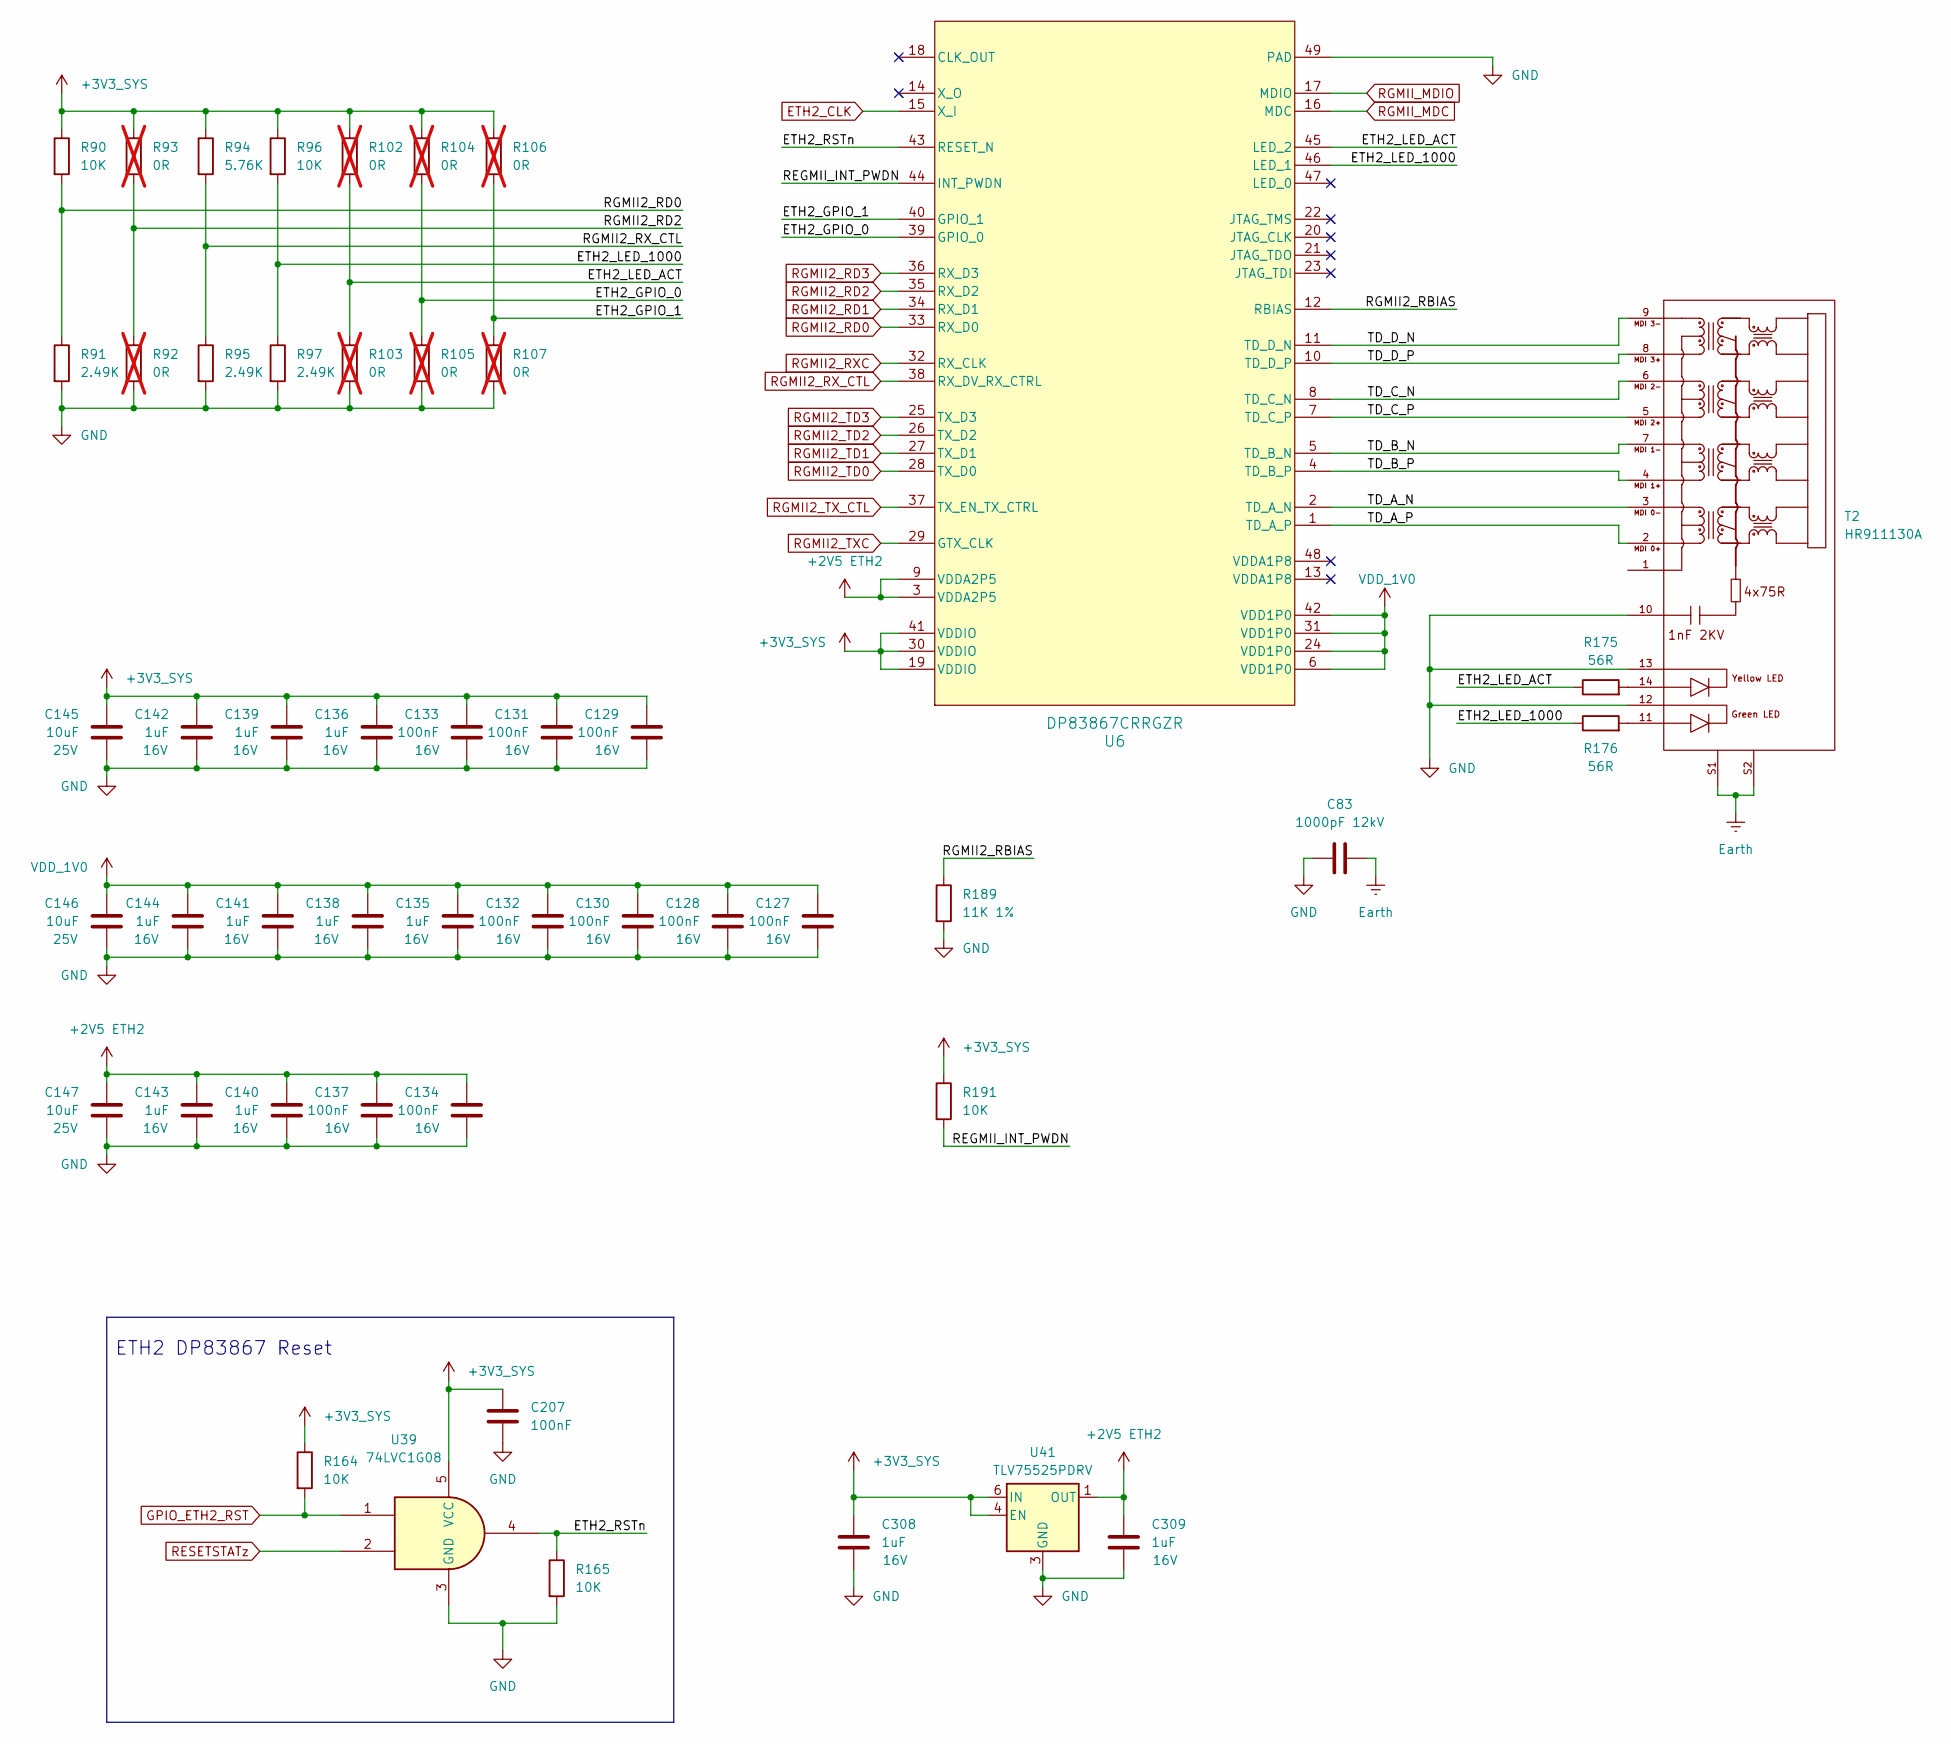
[picture p14: schematic SOC_Ethernet2.kicad_sch]

Parts:
C83: 1000pF 12kV; C_1206_3216Metric
C127, C128, C129, C130, C131, C132, C133, C134, C137: 100nF; C_0402_1005Metric; Voltage 16V
C135, C136, C138, C139, C140, C141, C142, C143, C144, C308, C309: 1uF; C_0402_1005Metric; voltage 16V; LCSC C29266
C145, C146, C147: 10uF; C_0603_1608Metric; voltage 25V; LCSC C96446
C207: 100nF; C_0603_1608Metric; LCSC C1591
R90, R96, R191: 10K; R_0402_1005Metric
R91, R95, R97: 2.49K; R_0402_1005Metric
R92, R93, R102, R103, R104, R105, R106, R107: 0R; R_0402_1005Metric; not fitted
R94: 5.76K; R_0402_1005Metric
R164, R165: 10K; R_0603_1608Metric
R175, R176: 56R; R_0603_1608Metric
R189: 11K 1%; R_0402_1005Metric
T2: HR911130A; HANRUN_HR911130A
U6: DP83867CRRGZR; RGZ0048B
U39: 74LVC1G08; Texas_R-PDSO-G5_DCK-5; LCSC2 C2983745 (UMW) or C2870856 (TI)
U41: TLV75525PDRV; WSON-6-1EP_2x2mm_P0.65mm_EP1x1.6mm

Connections:
+2V5 ETH2: C134.1, C137.1, C140.1, C143.1, C147.1, C309.1, U6.3 (VDDA2P5), U6.9 (VDDA2P5), U41.1 (OUT)
+3V3_SYS: C129.1, C131.1, C133.1, C136.1, C139.1, C142.1, C145.1, C207.1, C308.1, R90.1, R93.1, R94.1, R96.1, R102.1, R104.1, R106.1, R164.1, R191.1, U6.19 (VDDIO), U6.30 (VDDIO), U6.41 (VDDIO), U39.5 (VCC), U41.4 (EN), U41.6 (IN)
ETH2_CLK: U6.15 (X_I)
ETH2_GPIO_0: R104.2, R105.1, U6.39 (GPIO_0)
ETH2_GPIO_1: R106.2, R107.1, U6.40 (GPIO_1)
ETH2_LED_1000: R96.2, R97.1, R176.1, U6.46 (LED_1)
ETH2_LED_ACT: R102.2, R103.1, R175.1, U6.45 (LED_2)
ETH2_RSTn: R165.1, U6.43 (RESET_N), U39.4
Earth: C83.2, T2.S1, T2.S2
GND: C83.1, C127.2, C128.2, C129.2, C130.2, C131.2, C132.2, C133.2, C134.2, C135.2, C136.2, C137.2, C138.2, C139.2, C140.2, C141.2, C142.2, C143.2, C144.2, C145.2, C146.2, C147.2, C207.2, C308.2, C309.2, R91.2, R92.2, R95.2, R97.2, R103.2, R105.2, R107.2, R165.2, R189.2, T2.10, T2.12, T2.13, U6.49 (PAD), U39.3 (GND), U41.3 (GND), U41.7 (GND)
GPIO_ETH2_RST: R164.2, U39.1
unnamed: R175.2, T2.14
unnamed: R176.2, T2.11
REGMII_INT_PWDN: R191.2, U6.44 (INT_PWDN)
RESETSTATz: U39.2
RGMII2_RBIAS: R189.1, U6.12 (RBIAS)
RGMII2_RD0: R90.2, R91.1, U6.33 (RX_D0)
RGMII2_RD1: U6.34 (RX_D1)
RGMII2_RD2: R92.1, R93.2, U6.35 (RX_D2)
RGMII2_RD3: U6.36 (RX_D3)
RGMII2_RXC: U6.32 (RX_CLK)
RGMII2_RX_CTL: R94.2, R95.1, U6.38 (RX_DV_RX_CTRL)
RGMII2_TD0: U6.28 (TX_D0)
RGMII2_TD1: U6.27 (TX_D1)
RGMII2_TD2: U6.26 (TX_D2)
RGMII2_TD3: U6.25 (TX_D3)
RGMII2_TXC: U6.29 (GTX_CLK)
RGMII2_TX_CTL: U6.37 (TX_EN_TX_CTRL)
RGMII_MDC: U6.16 (MDC)
RGMII_MDIO: U6.17 (MDIO)
TD_A_N: T2.3, U6.2 (TD_A_N)
TD_A_P: T2.2, U6.1 (TD_A_P)
TD_B_N: T2.7, U6.5 (TD_B_N)
TD_B_P: T2.4, U6.4 (TD_B_P)
TD_C_N: T2.6, U6.8 (TD_C_N)
TD_C_P: T2.5, U6.7 (TD_C_P)
TD_D_N: T2.9, U6.11 (TD_D_N)
TD_D_P: T2.8, U6.10 (TD_D_P)
VDD_1V0: C127.1, C128.1, C130.1, C132.1, C135.1, C138.1, C141.1, C144.1, C146.1, U6.6 (VDD1P0), U6.24 (VDD1P0), U6.31 (VDD1P0), U6.42 (VDD1P0)

Notes on the sheet:
ETH2 DP83867 Reset
