h3llf/Euclid-8/Controller/SOC_Ethernet.kicad_sch

## KiCad design Controller/SOC_Ethernet.kicad_sch (2026-03-28)

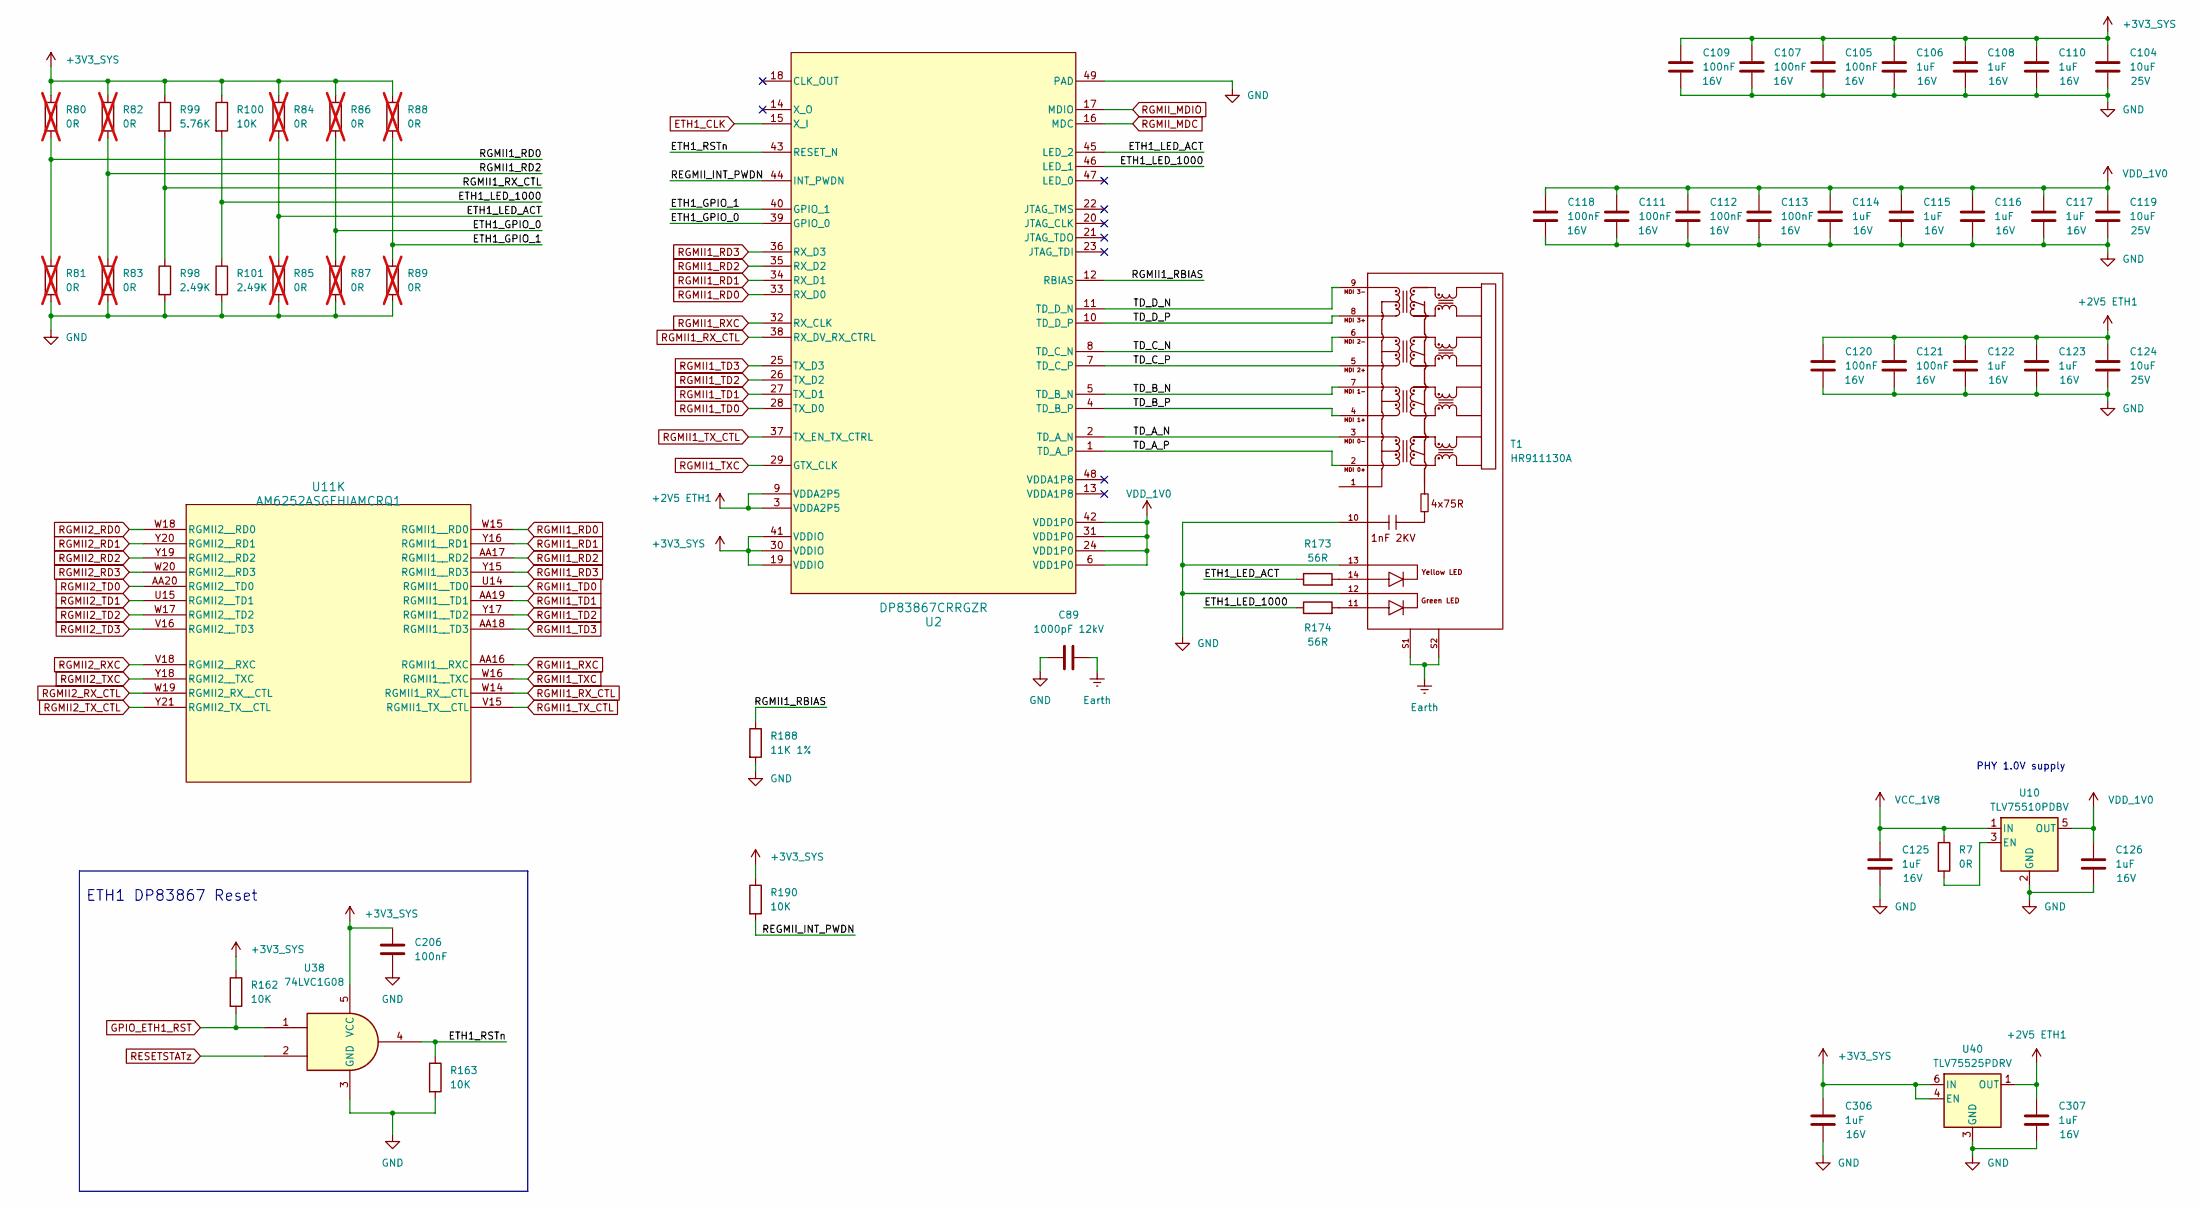
[picture p15: schematic SOC_Ethernet.kicad_sch]

Parts:
C89: 1000pF 12kV; C_1206_3216Metric
C104, C119, C124: 10uF; C_0603_1608Metric; voltage 25V; LCSC C96446
C105, C107, C109, C111, C112, C113, C118, C120, C121: 100nF; C_0402_1005Metric; Voltage 16V
C106, C108, C110, C114, C115, C116, C117, C122, C123, C125, C126, C306, C307: 1uF; C_0402_1005Metric; voltage 16V; LCSC C29266
C206: 100nF; C_0603_1608Metric; LCSC C1591
R7: 0R; R_0603_1608Metric
R80, R81, R82, R83, R84, R85, R86, R87, R88, R89: 0R; R_0402_1005Metric; not fitted
R98, R101: 2.49K; R_0402_1005Metric
R99: 5.76K; R_0402_1005Metric
R100, R190: 10K; R_0402_1005Metric
R162, R163: 10K; R_0603_1608Metric
R173, R174: 56R; R_0603_1608Metric
R188: 11K 1%; R_0402_1005Metric
T1: HR911130A; HANRUN_HR911130A
U2: DP83867CRRGZR; RGZ0048B
U10: TLV75510PDBV; SOT-23-5
U11: AM6252ASGFHIAMCRQ1; FCBGA441_AMC_TEX
U38: 74LVC1G08; Texas_R-PDSO-G5_DCK-5; LCSC2 C2983745 (UMW) or C2870856 (TI)
U40: TLV75525PDRV; WSON-6-1EP_2x2mm_P0.65mm_EP1x1.6mm

Connections:
+2V5 ETH1: C120.1, C121.1, C122.1, C123.1, C124.1, C307.1, U2.3 (VDDA2P5), U2.9 (VDDA2P5), U40.1 (OUT)
+3V3_SYS: C104.1, C105.1, C106.1, C107.1, C108.1, C109.1, C110.1, C206.1, C306.1, R80.1, R82.1, R84.1, R86.1, R88.1, R99.1, R100.1, R162.1, R190.1, U2.19 (VDDIO), U2.30 (VDDIO), U2.41 (VDDIO), U38.5 (VCC), U40.4 (EN), U40.6 (IN)
ETH1_CLK: U2.15 (X_I)
ETH1_GPIO_0: R86.2, R87.1, U2.39 (GPIO_0)
ETH1_GPIO_1: R88.2, R89.1, U2.40 (GPIO_1)
ETH1_LED_1000: R100.2, R101.1, R174.1, U2.46 (LED_1)
ETH1_LED_ACT: R84.2, R85.1, R173.1, U2.45 (LED_2)
ETH1_RSTn: R163.1, U2.43 (RESET_N), U38.4
Earth: C89.2, T1.S1, T1.S2
GND: C89.1, C104.2, C105.2, C106.2, C107.2, C108.2, C109.2, C110.2, C111.2, C112.2, C113.2, C114.2, C115.2, C116.2, C117.2, C118.2, C119.2, C120.2, C121.2, C122.2, C123.2, C124.2, C125.2, C126.2, C206.2, C306.2, C307.2, R81.2, R83.2, R85.2, R87.2, R89.2, R98.2, R101.2, R163.2, R188.2, T1.10, T1.12, T1.13, U2.49 (PAD), U10.2 (GND), U38.3 (GND), U40.3 (GND), U40.7 (GND)
GPIO_ETH1_RST: R162.2, U38.1
unnamed: R7.2, U10.3 (EN)
unnamed: R173.2, T1.14
unnamed: R174.2, T1.11
REGMII_INT_PWDN: R190.2, U2.44 (INT_PWDN)
RESETSTATz: U38.2
RGMII1_RBIAS: R188.1, U2.12 (RBIAS)
RGMII1_RD0: R80.2, R81.1, U2.33 (RX_D0), U11.W15 (RGMII1__RD0)
RGMII1_RD1: U2.34 (RX_D1), U11.Y16 (RGMII1__RD1)
RGMII1_RD2: R82.2, R83.1, U2.35 (RX_D2), U11.AA17 (RGMII1__RD2)
RGMII1_RD3: U2.36 (RX_D3), U11.Y15 (RGMII1__RD3)
RGMII1_RXC: U2.32 (RX_CLK), U11.AA16 (RGMII1__RXC)
RGMII1_RX_CTL: R98.1, R99.2, U2.38 (RX_DV_RX_CTRL), U11.W14 (RGMII1_RX__CTL)
RGMII1_TD0: U2.28 (TX_D0), U11.U14 (RGMII1__TD0)
RGMII1_TD1: U2.27 (TX_D1), U11.AA19 (RGMII1__TD1)
RGMII1_TD2: U2.26 (TX_D2), U11.Y17 (RGMII1__TD2)
RGMII1_TD3: U2.25 (TX_D3), U11.AA18 (RGMII1__TD3)
RGMII1_TXC: U2.29 (GTX_CLK), U11.W16 (RGMII1__TXC)
RGMII1_TX_CTL: U2.37 (TX_EN_TX_CTRL), U11.V15 (RGMII1_TX__CTL)
RGMII2_RD0: U11.W18 (RGMII2__RD0)
RGMII2_RD1: U11.Y20 (RGMII2__RD1)
RGMII2_RD2: U11.Y19 (RGMII2__RD2)
RGMII2_RD3: U11.W20 (RGMII2__RD3)
RGMII2_RXC: U11.V18 (RGMII2__RXC)
RGMII2_RX_CTL: U11.W19 (RGMII2_RX__CTL)
RGMII2_TD0: U11.AA20 (RGMII2__TD0)
RGMII2_TD1: U11.U15 (RGMII2__TD1)
RGMII2_TD2: U11.W17 (RGMII2__TD2)
RGMII2_TD3: U11.V16 (RGMII2__TD3)
RGMII2_TXC: U11.Y18 (RGMII2__TXC)
RGMII2_TX_CTL: U11.Y21 (RGMII2_TX__CTL)
RGMII_MDC: U2.16 (MDC)
RGMII_MDIO: U2.17 (MDIO)
TD_A_N: T1.3, U2.2 (TD_A_N)
TD_A_P: T1.2, U2.1 (TD_A_P)
TD_B_N: T1.7, U2.5 (TD_B_N)
TD_B_P: T1.4, U2.4 (TD_B_P)
TD_C_N: T1.6, U2.8 (TD_C_N)
TD_C_P: T1.5, U2.7 (TD_C_P)
TD_D_N: T1.9, U2.11 (TD_D_N)
TD_D_P: T1.8, U2.10 (TD_D_P)
VCC_1V8: C125.1, R7.1, U10.1 (IN)
VDD_1V0: C111.1, C112.1, C113.1, C114.1, C115.1, C116.1, C117.1, C118.1, C119.1, C126.1, U2.6 (VDD1P0), U2.24 (VDD1P0), U2.31 (VDD1P0), U2.42 (VDD1P0), U10.5 (OUT)

Notes on the sheet:
ETH1 DP83867 Reset
PHY 1.0V supply
