h3llf/Euclid-8/Controller/SOC_PMIC.kicad_sch

## KiCad design Controller/SOC_PMIC.kicad_sch (2026-05-04)

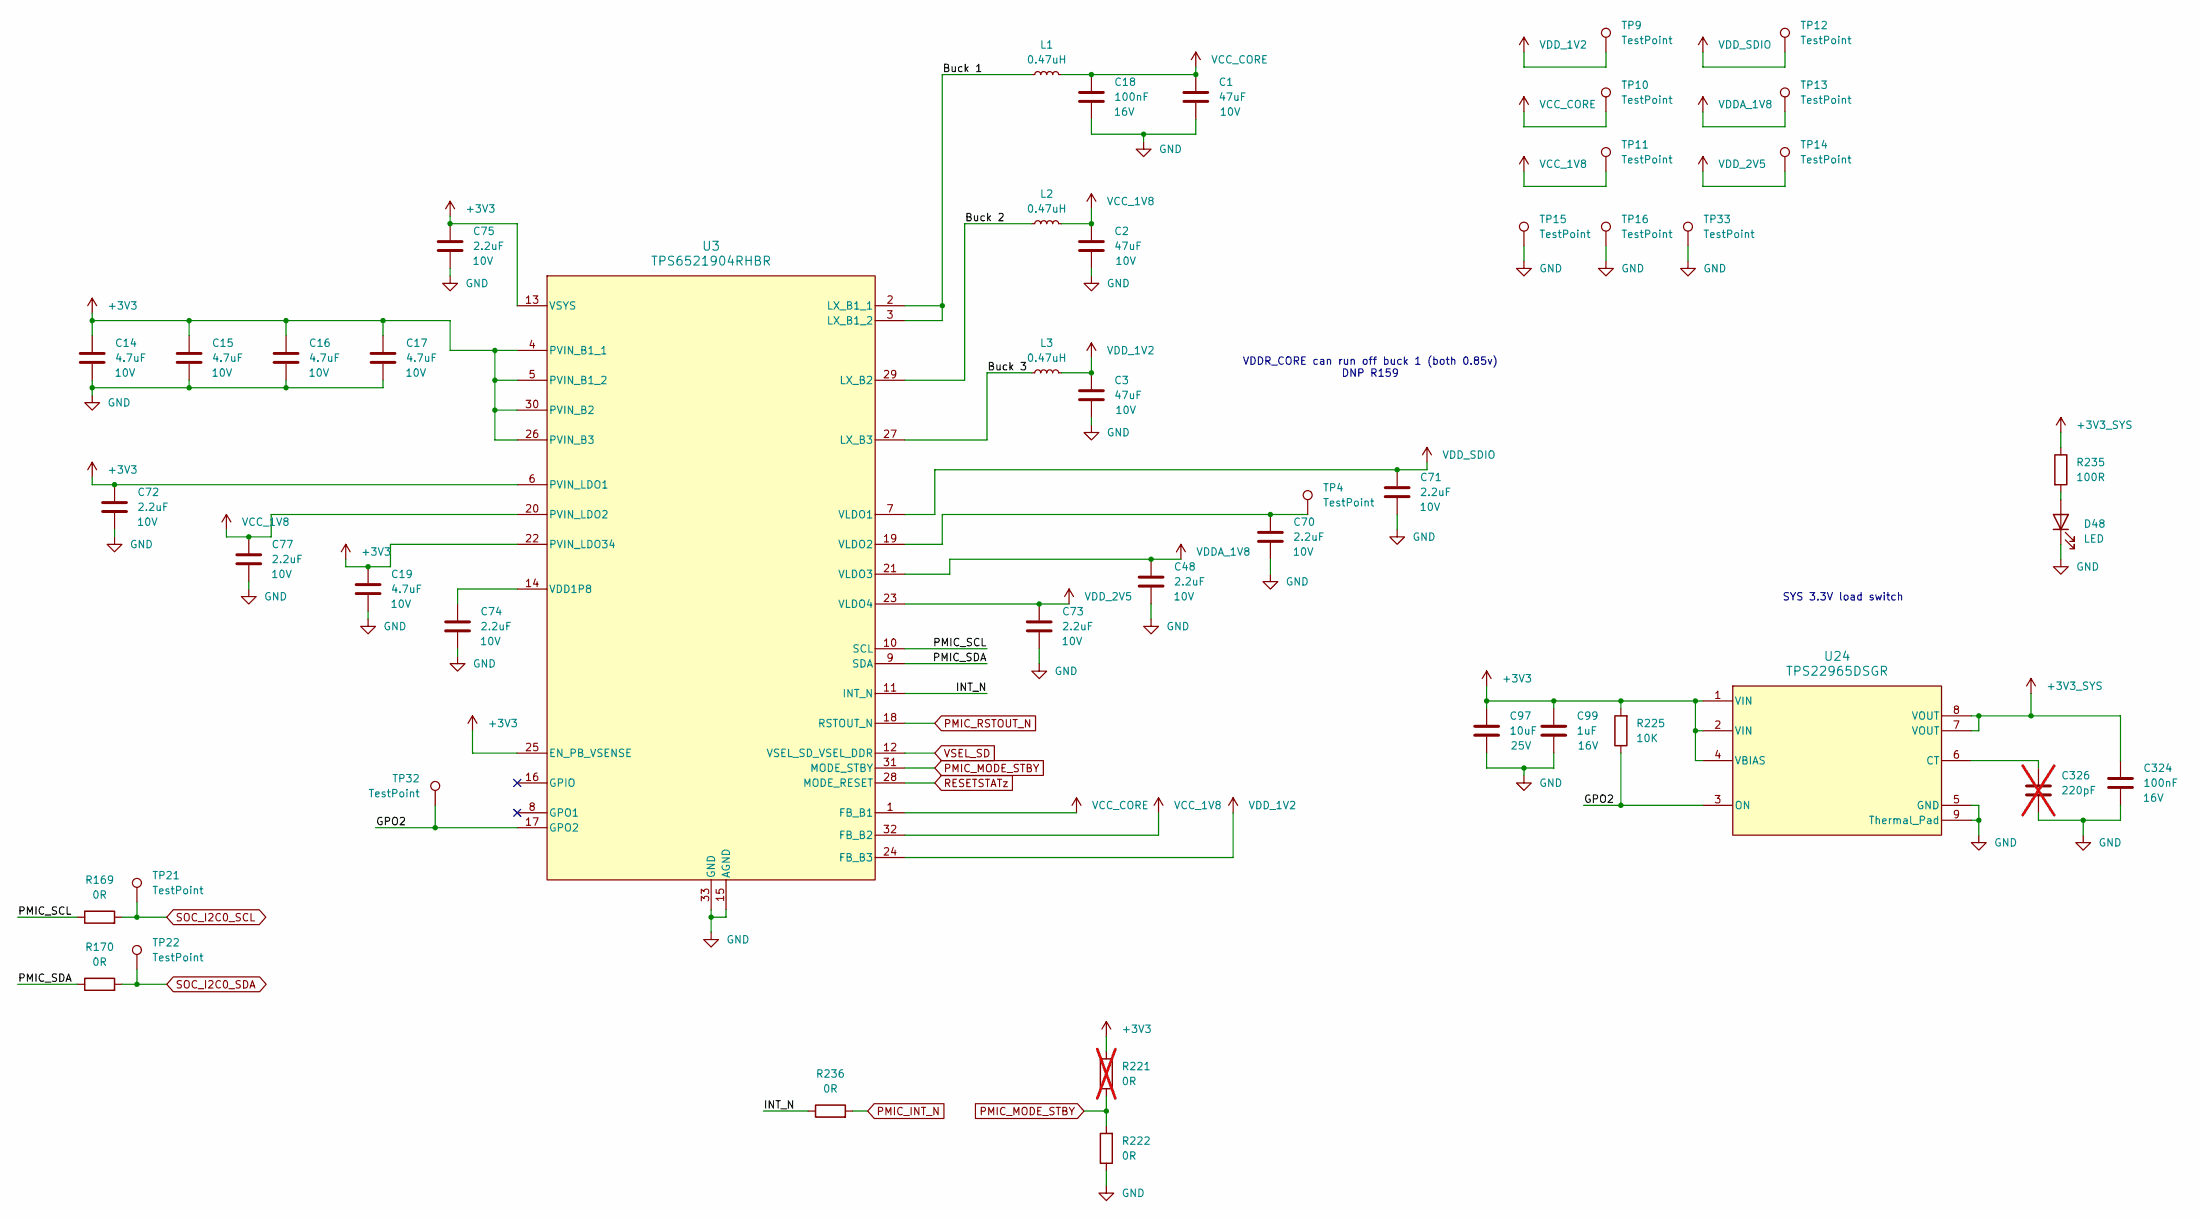
[picture p16: schematic SOC_PMIC.kicad_sch]

Parts:
C1, C2, C3: 47uF; C_0805_2012Metric; voltage 10V; LCSC C124129
C14, C15, C16, C17, C19: 4.7uF; C_0402_1005Metric; voltage 10V; LCSC C368809
C18, C324: 100nF; C_0402_1005Metric; Voltage 16V
C48, C70, C71, C72, C73, C74, C75, C77: 2.2uF; C_0402_1005Metric; voltage 10V; LCSC C170151
C97: 10uF; C_0603_1608Metric; voltage 25V; LCSC C96446
C99: 1uF; C_0402_1005Metric; voltage 16V; LCSC C29266
C326: 220pF; C_0402_1005Metric; not fitted
D48: LED; LED_0603_1608Metric
L1, L2, L3: 0.47uH; L_Cenker_CKCS201610; LCSC C5832340
R169, R170, R222, R236: 0R; R_0603_1608Metric
R221: 0R; R_0603_1608Metric; not fitted
R225: 10K; R_0603_1608Metric
R235: 100R; R_0603_1608Metric
TP4: TestPoint; TestPoint_Pad_2.0x2.0mm
TP9, TP10, TP11, TP12, TP13, TP14, TP15, TP16, TP21, TP22, TP32, TP33: TestPoint; TestPoint_Pad_D1.5mm
U3: TPS6521904RHBR; RHB0032U-IPC_A
U24: TPS22965DSGR; DSG0008A-MFG

Connections:
+3V3: C14.1, C15.1, C16.1, C17.1, C19.1, C72.1, C75.1, C97.1, C99.1, R221.2, R225.2, U3.4 (PVIN_B1_1), U3.5 (PVIN_B1_2), U3.6 (PVIN_LDO1), U3.13 (VSYS), U3.22 (PVIN_LDO34), U3.25 (EN_PB_VSENSE), U3.26 (PVIN_B3), U3.30 (PVIN_B2), U24.1 (VIN), U24.2 (VIN), U24.4 (VBIAS)
+3V3_SYS: C324.1, R235.1, U24.7 (VOUT), U24.8 (VOUT)
Buck 1: L1.1, U3.2 (LX_B1_1), U3.3 (LX_B1_2)
Buck 2: L2.1, U3.29 (LX_B2)
Buck 3: L3.1, U3.27 (LX_B3)
GND: C1.2, C2.2, C3.2, C14.2, C15.2, C16.2, C17.2, C18.2, C19.2, C48.2, C70.2, C71.2, C72.2, C73.2, C74.2, C75.2, C77.2, C97.2, C99.2, C324.2, C326.2, D48.1 (K), R222.1, TP15.1, TP16.1, TP33.1, U3.15 (AGND), U3.33 (GND), U24.5 (GND), U24.9 (Thermal_Pad)
GPO2: R225.1, TP32.1, U3.17 (GPO2), U24.3 (ON)
INT_N: R236.1, U3.11 (INT_N)
unnamed: C70.1, TP4.1, U3.19 (VLDO2)
unnamed: C74.1, U3.14 (VDD1P8)
unnamed: C326.1, U24.6 (CT)
unnamed: D48.2 (A), R235.2
PMIC_INT_N: R236.2
PMIC_MODE_STBY: R221.1, R222.2, U3.31 (MODE_STBY)
PMIC_RSTOUT_N: U3.18 (RSTOUT_N)
PMIC_SCL: R169.1, U3.10 (SCL)
PMIC_SDA: R170.1, U3.9 (SDA)
RESETSTATz: U3.28 (MODE_RESET)
SOC_I2C0_SCL: R169.2, TP21.1
SOC_I2C0_SDA: R170.2, TP22.1
VCC_1V8: C2.1, C77.1, L2.2, TP11.1, U3.20 (PVIN_LDO2), U3.32 (FB_B2)
VCC_CORE: C1.1, C18.1, L1.2, TP10.1, U3.1 (FB_B1)
VDDA_1V8: C48.1, TP13.1, U3.21 (VLDO3)
VDD_1V2: C3.1, L3.2, TP9.1, U3.24 (FB_B3)
VDD_2V5: C73.1, TP14.1, U3.23 (VLDO4)
VDD_SDIO: C71.1, TP12.1, U3.7 (VLDO1)
VSEL_SD: U3.12 (VSEL_SD_VSEL_DDR)

Notes on the sheet:
SYS 3.3V load switch
VDDR_CORE can run off buck 1 (both 0.85v) DNP R159
