h3llf/Euclid-8/Controller/SOC_Power.kicad_sch

## KiCad design Controller/SOC_Power.kicad_sch (2026-03-28)

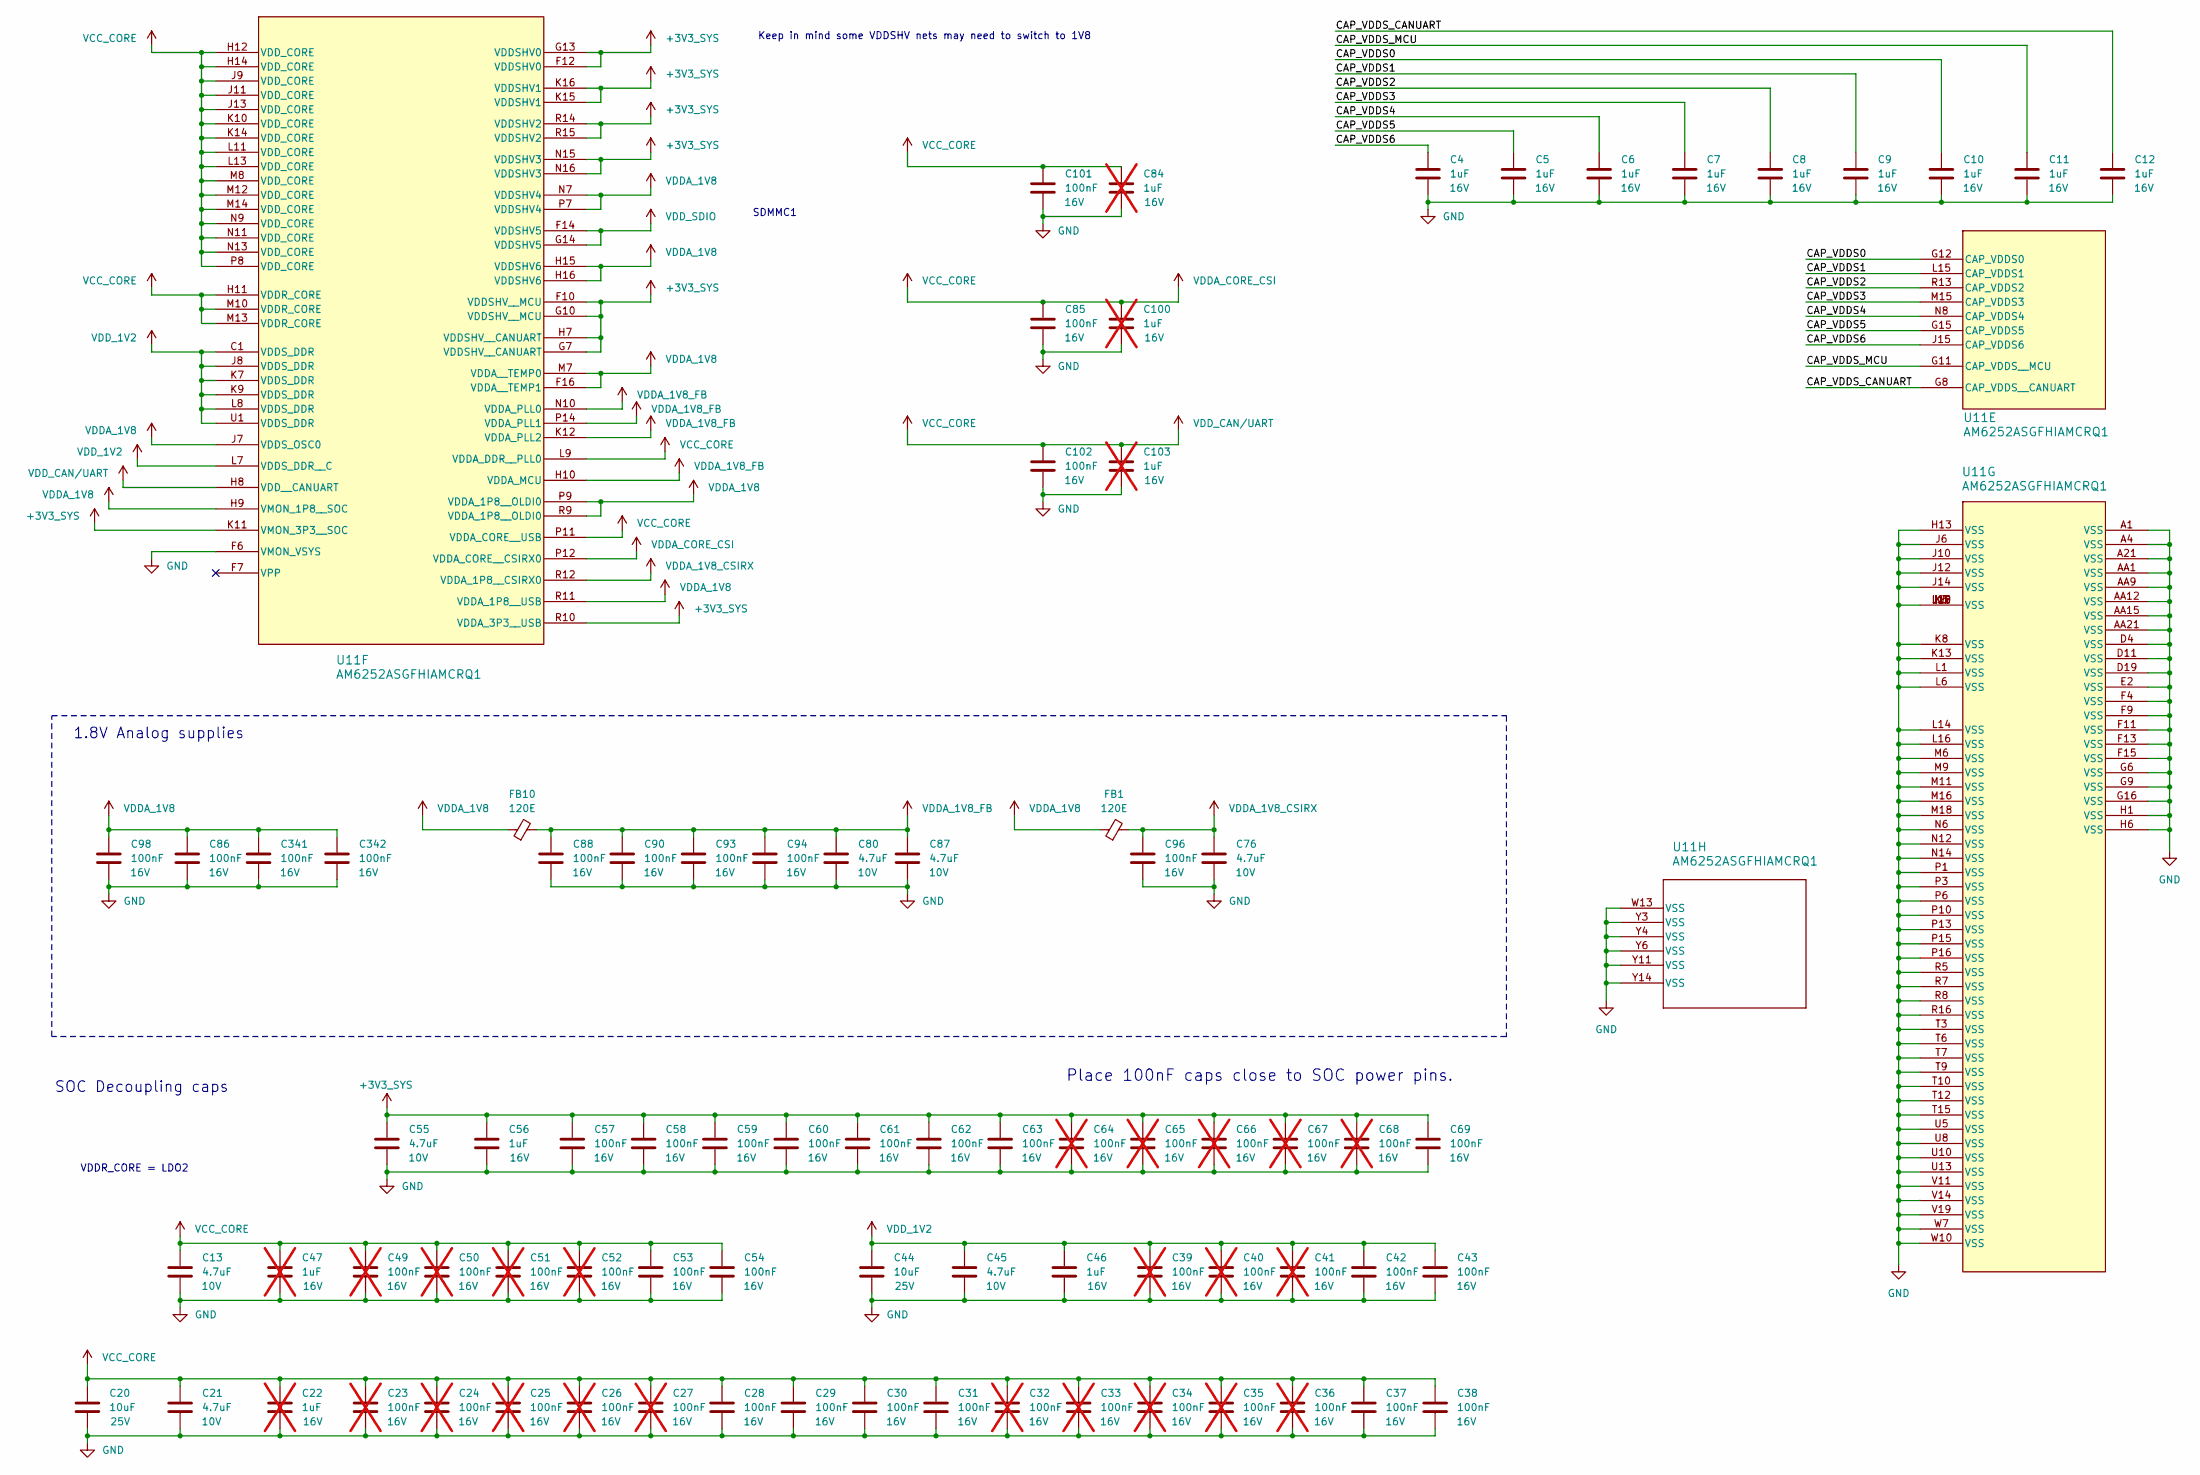
[picture p17: schematic SOC_Power.kicad_sch]

Parts:
C4, C5, C6, C7, C8, C9, C10, C11, C12, C46, C56: 1uF; C_0402_1005Metric; voltage 16V; LCSC C29266
C13, C21, C45, C55, C76, C80, C87: 4.7uF; C_0402_1005Metric; voltage 10V; LCSC C368809
C20, C44: 10uF; C_0603_1608Metric; voltage 25V; LCSC C96446
C22, C47, C84, C100, C103: 1uF; C_0402_1005Metric; voltage 16V; LCSC C29266; not fitted
C23, C24, C25, C26, C27, C32, C33, C34, C35, C36, C39, C40, C41, C49, C50, C51, C52, C64, C65, C66, C67, C68: 100nF; C_0402_1005Metric; Voltage 16V; not fitted
C28, C29, C30, C31, C37, C38, C42, C43, C53, C54, C57, C58, C59, C60, C61, C62, C63, C69, C85, C86, C88, C90, C93, C94, C96, C98, C101, C102, C341, C342: 100nF; C_0402_1005Metric; Voltage 16V
FB1, FB10: 120E; L_0402_1005Metric; LCSC C88970
U11: AM6252ASGFHIAMCRQ1; FCBGA441_AMC_TEX

Connections:
+3V3_SYS: C55.1, C56.1, C57.1, C58.1, C59.1, C60.1, C61.1, C62.1, C63.1, C64.1, C65.1, C66.1, C67.1, C68.1, C69.1, U11.F10 (VDDSHV__MCU), U11.F12 (VDDSHV0), U11.G7 (VDDSHV__CANUART), U11.G10 (VDDSHV__MCU), U11.G13 (VDDSHV0), U11.H7 (VDDSHV__CANUART), U11.K11 (VMON_3P3__SOC), U11.K15 (VDDSHV1), U11.K16 (VDDSHV1), U11.N15 (VDDSHV3), U11.N16 (VDDSHV3), U11.R10 (VDDA_3P3__USB), U11.R14 (VDDSHV2), U11.R15 (VDDSHV2)
CAP_VDDS0: C10.1, U11.G12 (CAP_VDDS0)
CAP_VDDS1: C9.1, U11.L15 (CAP_VDDS1)
CAP_VDDS2: C8.1, U11.R13 (CAP_VDDS2)
CAP_VDDS3: C7.1, U11.M15 (CAP_VDDS3)
CAP_VDDS4: C6.1, U11.N8 (CAP_VDDS4)
CAP_VDDS5: C5.1, U11.G15 (CAP_VDDS5)
CAP_VDDS6: C4.1, U11.J15 (CAP_VDDS6)
CAP_VDDS_CANUART: C12.1, U11.G8 (CAP_VDDS__CANUART)
CAP_VDDS_MCU: C11.1, U11.G11 (CAP_VDDS__MCU)
GND: C4.2, C5.2, C6.2, C7.2, C8.2, C9.2, C10.2, C11.2, C12.2, C13.2, C20.2, C21.2, C22.2, C23.2, C24.2, C25.2, C26.2, C27.2, C28.2, C29.2, C30.2, C31.2, C32.2, C33.2, C34.2, C35.2, C36.2, C37.2, C38.2, C39.2, C40.2, C41.2, C42.2, C43.2, C44.2, C45.2, C46.2, C47.2, C49.2, C50.2, C51.2, C52.2, C53.2, C54.2, C55.2, C56.2, C57.2, C58.2, C59.2, C60.2, C61.2, C62.2, C63.2, C64.2, C65.2, C66.2, C67.2, C68.2, C69.2, C76.2, C80.2, C84.2, C85.2, C86.2, C87.2, C88.2, C90.2, C93.2, C94.2, C96.2, C98.2, C100.2, C101.2, C102.2, C103.2, C341.2, C342.2, U11.A1 (VSS), U11.A4 (VSS), U11.A21 (VSS), U11.AA1 (VSS), U11.AA9 (VSS), U11.AA12 (VSS), U11.AA15 (VSS), U11.AA21 (VSS), U11.D4 (VSS), U11.D11 (VSS), U11.D19 (VSS), U11.E2 (VSS), U11.F4 (VSS), U11.F6 (VMON_VSYS), U11.F9 (VSS), U11.F11 (VSS), U11.F13 (VSS), U11.F15 (VSS), U11.G6 (VSS), U11.G9 (VSS), U11.G16 (VSS), U11.H1 (VSS), U11.H6 (VSS), U11.H13 (VSS), U11.J6 (VSS), U11.J10 (VSS), U11.J12 (VSS), U11.J14 (VSS), U11.J16 (VSS), U11.K3 (VSS), U11.K6 (VSS), U11.K8 (VSS), U11.K13 (VSS), U11.L1 (VSS), U11.L6 (VSS), U11.L10 (VSS), U11.L12 (VSS), U11.L14 (VSS), U11.L16 (VSS), U11.M6 (VSS), U11.M9 (VSS), U11.M11 (VSS), U11.M16 (VSS), U11.M18 (VSS), U11.N6 (VSS), U11.N12 (VSS), U11.N14 (VSS), U11.P1 (VSS), U11.P3 (VSS), U11.P6 (VSS), U11.P10 (VSS), U11.P13 (VSS), U11.P15 (VSS), U11.P16 (VSS), U11.R5 (VSS), U11.R7 (VSS), U11.R8 (VSS), U11.R16 (VSS), U11.T3 (VSS), U11.T6 (VSS), U11.T7 (VSS), U11.T9 (VSS), U11.T10 (VSS), U11.T12 (VSS), U11.T15 (VSS), U11.U5 (VSS), U11.U8 (VSS), U11.U10 (VSS), U11.U13 (VSS), U11.V11 (VSS), U11.V14 (VSS), U11.V19 (VSS), U11.W7 (VSS), U11.W10 (VSS), U11.W13 (VSS), U11.Y3 (VSS), U11.Y4 (VSS), U11.Y6 (VSS), U11.Y11 (VSS), U11.Y14 (VSS)
VCC_CORE: C13.1, C20.1, C21.1, C22.1, C23.1, C24.1, C25.1, C26.1, C27.1, C28.1, C29.1, C30.1, C31.1, C32.1, C33.1, C34.1, C35.1, C36.1, C37.1, C38.1, C47.1, C49.1, C50.1, C51.1, C52.1, C53.1, C54.1, C84.1, C85.1, C100.1, C101.1, C102.1, C103.1, U11.H8 (VDD__CANUART), U11.H11 (VDDR_CORE), U11.H12 (VDD_CORE), U11.H14 (VDD_CORE), U11.J9 (VDD_CORE), U11.J11 (VDD_CORE), U11.J13 (VDD_CORE), U11.K10 (VDD_CORE), U11.K14 (VDD_CORE), U11.L9 (VDDA_DDR__PLL0), U11.L11 (VDD_CORE), U11.L13 (VDD_CORE), U11.M8 (VDD_CORE), U11.M10 (VDDR_CORE), U11.M12 (VDD_CORE), U11.M13 (VDDR_CORE), U11.M14 (VDD_CORE), U11.N9 (VDD_CORE), U11.N11 (VDD_CORE), U11.N13 (VDD_CORE), U11.P8 (VDD_CORE), U11.P11 (VDDA_CORE__USB), U11.P12 (VDDA_CORE__CSIRX0)
VDDA_1V8: C86.1, C98.1, C341.1, C342.1, FB1.1, FB10.1, U11.F16 (VDDA__TEMP1), U11.H9 (VMON_1P8__SOC), U11.H15 (VDDSHV6), U11.H16 (VDDSHV6), U11.J7 (VDDS_OSC0), U11.M7 (VDDA__TEMP0), U11.N7 (VDDSHV4), U11.P7 (VDDSHV4), U11.P9 (VDDA_1P8__OLDI0), U11.R9 (VDDA_1P8__OLDI0), U11.R11 (VDDA_1P8__USB)
VDDA_1V8_CSIRX: C76.1, C96.1, FB1.2, U11.R12 (VDDA_1P8__CSIRX0)
VDDA_1V8_FB: C80.1, C87.1, C88.1, C90.1, C93.1, C94.1, FB10.2, U11.H10 (VDDA_MCU), U11.K12 (VDDA_PLL2), U11.N10 (VDDA_PLL0), U11.P14 (VDDA_PLL1)
VDD_1V2: C39.1, C40.1, C41.1, C42.1, C43.1, C44.1, C45.1, C46.1, U11.C1 (VDDS_DDR), U11.J8 (VDDS_DDR), U11.K7 (VDDS_DDR), U11.K9 (VDDS_DDR), U11.L7 (VDDS_DDR__C), U11.L8 (VDDS_DDR), U11.U1 (VDDS_DDR)
VDD_SDIO: U11.F14 (VDDSHV5), U11.G14 (VDDSHV5)

Notes on the sheet:
Keep in mind some VDDSHV nets may need to switch to 1V8
1.8V Analog supplies
VDDR_CORE = LDO2
SOC Decoupling caps
SDMMC1
Place 100nF caps close to SOC power pins.
