h3llf/Euclid-8/Controller/SOC_USB.kicad_sch

## KiCad design Controller/SOC_USB.kicad_sch (2026-04-20)

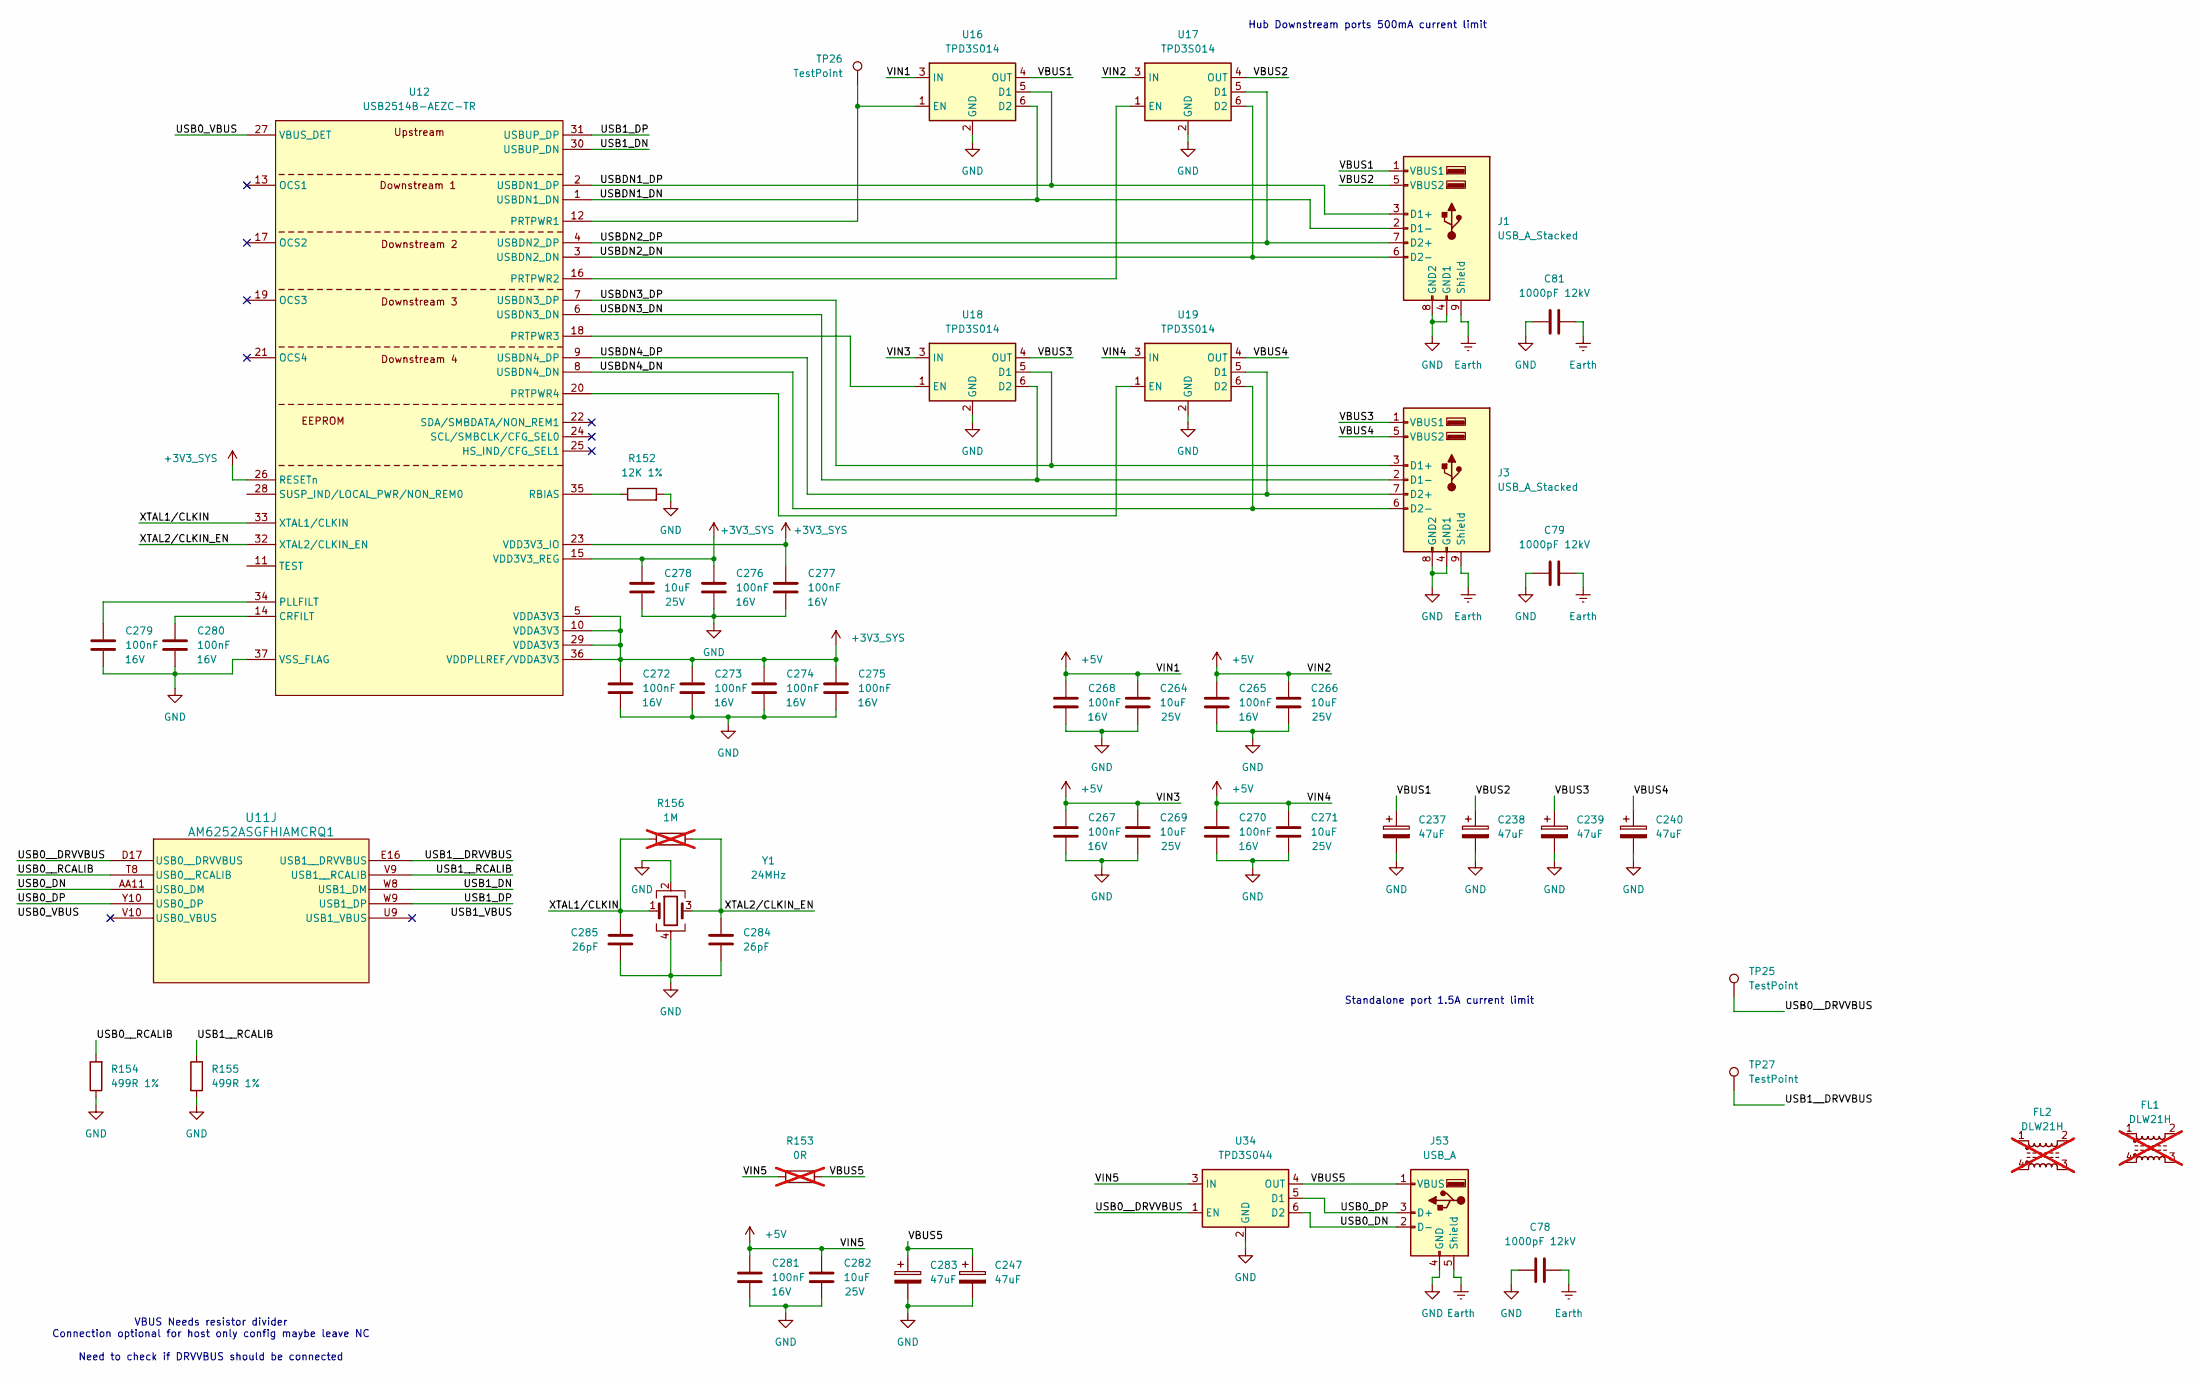
[picture p18: schematic SOC_USB.kicad_sch]

Parts:
C78, C79, C81: 1000pF 12kV; C_1206_3216Metric
C237, C238, C239, C240, C247, C283: 47uF; CP_EIA-3528-21_Kemet-B
C264, C266, C269, C271, C278, C282: 10uF; C_0603_1608Metric; voltage 25V; LCSC C96446
C265, C267, C268, C270, C272, C273, C274, C275, C276, C277, C279, C280: 100nF; C_0402_1005Metric; Voltage 16V
C281: 100nF; C_0603_1608Metric; Voltage 16V
C284, C285: 26pF; C_0402_1005Metric
FL1, FL2: DLW21H; L_CommonModeChoke_Coilcraft_0603USB; LCSC C80529; not fitted
J1, J3: USB_A_Stacked; SHOU HAN AF SS-JB17.6
J53: USB_A; Jing USB 4P THT Sideways
R152: 12K 1%; R_0603_1608Metric
R153: 0R; R_0603_1608Metric; not fitted
R154, R155: 499R 1%; R_0402_1005Metric
R156: 1M; R_0402_1005Metric; not fitted
TP25, TP26: TestPoint; TestPoint_Pad_D1.5mm
TP27: TestPoint; TestPoint_Pad_D1.0mm
U11: AM6252ASGFHIAMCRQ1; FCBGA441_AMC_TEX
U12: USB2514B-AEZC-TR; QFN-36-1EP_6x6mm_P0.5mm_EP3.7x3.7mm_ThermalVias
U16, U17, U18, U19: TPD3S014; SOT-23-6
U34: TPD3S044; SOT-23-6
Y1: 24MHz; Crystal_SMD_3225-4Pin_3.2x2.5mm

Connections:
+3V3_SYS: C272.1, C273.1, C274.1, C275.1, C276.1, C277.1, C278.1, U12.5 (VDDA3V3), U12.10 (VDDA3V3), U12.15 (VDD3V3_REG), U12.23 (VDD3V3_IO), U12.26 (RESETn), U12.29 (VDDA3V3), U12.36 (VDDPLLREF/VDDA3V3)
+5V: C264.1, C265.1, C266.1, C267.1, C268.1, C269.1, C270.1, C271.1, C281.1, C282.1, R153.1, U16.3 (IN), U17.3 (IN), U18.3 (IN), U19.3 (IN), U34.3 (IN)
Earth: C78.2, C79.2, C81.2, J1.9 (Shield), J3.9 (Shield), J53.5 (Shield)
GND: C78.1, C79.1, C81.1, C237.2, C238.2, C239.2, C240.2, C247.2, C264.2, C265.2, C266.2, C267.2, C268.2, C269.2, C270.2, C271.2, C272.2, C273.2, C274.2, C275.2, C276.2, C277.2, C278.2, C279.2, C280.2, C281.2, C282.2, C283.2, C284.2, C285.2, J1.4 (GND1), J1.8 (GND2), J3.4 (GND1), J3.8 (GND2), J53.4 (GND), R152.2, R154.1, R155.2, U12.37 (VSS_FLAG), U16.2 (GND), U17.2 (GND), U18.2 (GND), U19.2 (GND), U34.2 (GND), Y1.2, Y1.4
unnamed: C279.1, U12.34 (PLLFILT)
unnamed: C280.1, U12.14 (CRFILT)
unnamed: R152.1, U12.35 (RBIAS)
unnamed: TP26.1, U12.12 (PRTPWR1), U16.1 (EN)
unnamed: U12.16 (PRTPWR2), U17.1 (EN)
unnamed: U12.18 (PRTPWR3), U18.1 (EN)
unnamed: U12.20 (PRTPWR4), U19.1 (EN)
USB0_DN: J53.2 (D-), U11.AA11 (USB0_DM), U34.6 (D2)
USB0_DP: J53.3 (D+), U11.Y10 (USB0_DP), U34.5 (D1)
USB0_VBUS: U12.27 (VBUS_DET)
USB0__DRVVBUS: TP25.1, U11.D17 (USB0__DRVVBUS), U34.1 (EN)
USB0__RCALIB: R154.2, U11.T8 (USB0__RCALIB)
USB1_DN: U11.W8 (USB1_DM), U12.30 (USBUP_DN)
USB1_DP: U11.W9 (USB1_DP), U12.31 (USBUP_DP)
USB1__DRVVBUS: TP27.1, U11.E16 (USB1__DRVVBUS)
USB1__RCALIB: R155.1, U11.V9 (USB1__RCALIB)
USBDN1_DN: J1.2 (D1-), U12.1 (USBDN1_DN), U16.6 (D2)
USBDN1_DP: J1.3 (D1+), U12.2 (USBDN1_DP), U16.5 (D1)
USBDN2_DN: J1.6 (D2-), U12.3 (USBDN2_DN), U17.6 (D2)
USBDN2_DP: J1.7 (D2+), U12.4 (USBDN2_DP), U17.5 (D1)
USBDN3_DN: J3.2 (D1-), U12.6 (USBDN3_DN), U18.6 (D2)
USBDN3_DP: J3.3 (D1+), U12.7 (USBDN3_DP), U18.5 (D1)
USBDN4_DN: J3.6 (D2-), U12.8 (USBDN4_DN), U19.6 (D2)
USBDN4_DP: J3.7 (D2+), U12.9 (USBDN4_DP), U19.5 (D1)
VBUS1: C237.1, J1.1 (VBUS1), U16.4 (OUT)
VBUS2: C238.1, J1.5 (VBUS2), U17.4 (OUT)
VBUS3: C239.1, J3.1 (VBUS1), U18.4 (OUT)
VBUS4: C240.1, J3.5 (VBUS2), U19.4 (OUT)
VBUS5: C247.1, C283.1, J53.1 (VBUS), R153.2, U34.4 (OUT)
XTAL1/CLKIN: C285.1, R156.1, U12.33 (XTAL1/CLKIN), Y1.1
XTAL2/CLKIN_EN: C284.1, R156.2, U12.32 (XTAL2/CLKIN_EN), Y1.3

Notes on the sheet:
Hub Downstream ports 500mA current limit
Standalone port 1.5A current limit
VBUS Needs resistor divider Connection optional for host only config maybe leave NC Need to check if DRVVBUS should be connected
