h3llf/Euclid-8/Controller/SOC_Video_Interface.kicad_sch

## KiCad design Controller/SOC_Video_Interface.kicad_sch (2026-04-20)

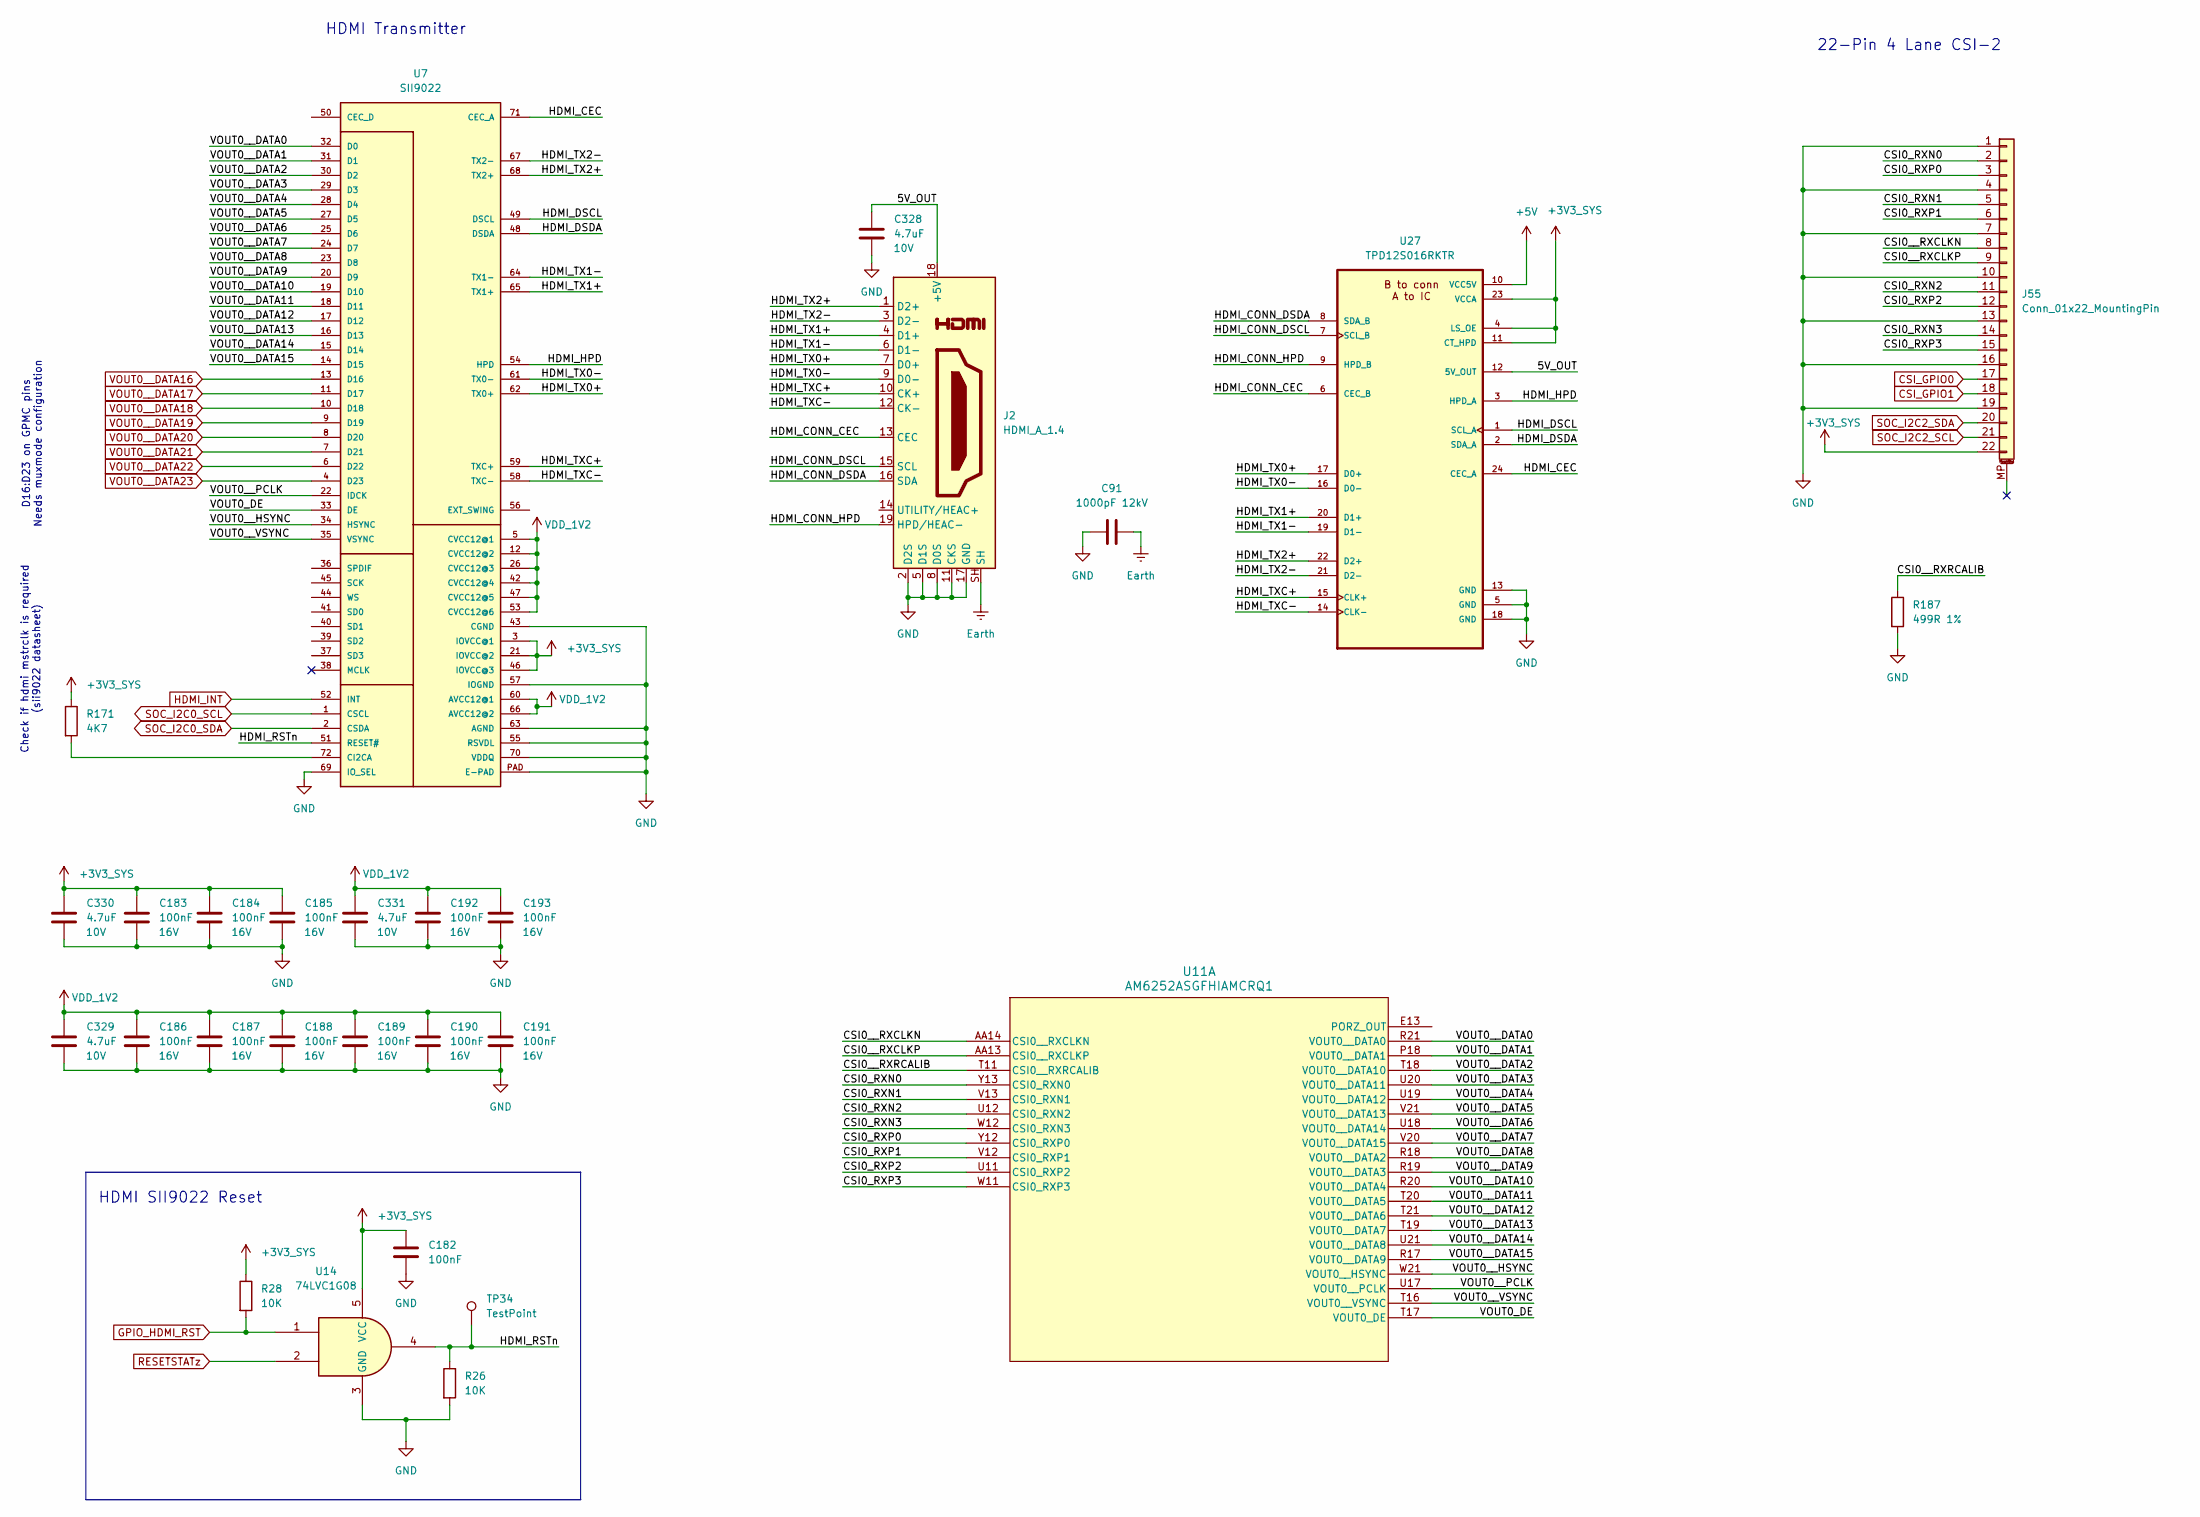
[picture p19: schematic SOC_Video_Interface.kicad_sch]

Parts:
C91: 1000pF 12kV; C_1206_3216Metric
C182: 100nF; C_0603_1608Metric; LCSC C1591
C183, C184, C185, C186, C187, C188, C189, C190, C191, C192, C193: 100nF; C_0402_1005Metric; Voltage 16V
C328, C329, C330, C331: 4.7uF; C_0402_1005Metric; voltage 10V; LCSC C368809
J2: HDMI_A_1.4; HDMI-001S_XUNPU
J55: Conn_01x22_MountingPin; JUSHUO AFC11-S22ICA-00
R26, R28: 10K; R_0603_1608Metric
R171: 4K7; R_0603_1608Metric
R187: 499R 1%; R_0402_1005Metric
TP34: TestPoint; TestPoint_Pad_D1.5mm
U7: SII9022; QFN-72
U11: AM6252ASGFHIAMCRQ1; FCBGA441_AMC_TEX
U14: 74LVC1G08; Texas_R-PDSO-G5_DCK-5; LCSC2 C2983745 (UMW) or C2870856 (TI)
U27: TPD12S016RKTR; IC_TPD12S016RKTR

Connections:
5V_OUT: C328.1, J2.18 (+5V), U27.12 (5V_OUT)
+3V3_SYS: C182.1, C183.1, C184.1, C185.1, C330.1, J55.22, R28.1, R171.1, U7.3 (IOVCC@1), U7.21 (IOVCC@2), U7.46 (IOVCC@3), U14.5 (VCC), U27.4 (LS_OE), U27.11 (CT_HPD), U27.23 (VCCA)
+5V: U27.10 (VCC5V)
CSI0_RXN0: J55.2, U11.Y13 (CSI0_RXN0)
CSI0_RXN1: J55.5, U11.V13 (CSI0_RXN1)
CSI0_RXN2: J55.11, U11.U12 (CSI0_RXN2)
CSI0_RXN3: J55.14, U11.W12 (CSI0_RXN3)
CSI0_RXP0: J55.3, U11.Y12 (CSI0_RXP0)
CSI0_RXP1: J55.6, U11.V12 (CSI0_RXP1)
CSI0_RXP2: J55.12, U11.U11 (CSI0_RXP2)
CSI0_RXP3: J55.15, U11.W11 (CSI0_RXP3)
CSI0__RXCLKN: J55.8, U11.AA14 (CSI0__RXCLKN)
CSI0__RXCLKP: J55.9, U11.AA13 (CSI0__RXCLKP)
CSI0__RXRCALIB: R187.1, U11.T11 (CSI0__RXRCALIB)
CSI_GPIO0: J55.17
CSI_GPIO1: J55.18
Earth: C91.2, J2.SH
GND: C91.1, C182.2, C183.2, C184.2, C185.2, C186.2, C187.2, C188.2, C189.2, C190.2, C191.2, C192.2, C193.2, C328.2, C329.2, C330.2, C331.2, J2.2 (D2S), J2.5 (D1S), J2.8 (D0S), J2.11 (CKS), J2.17 (GND), J55.1, J55.4, J55.7, J55.10, J55.13, J55.16, J55.19, R26.2, R187.2, U7.43 (CGND), U7.55 (RSVDL), U7.57 (IOGND), U7.63 (AGND), U7.69 (IO_SEL), U7.70 (VDDQ), U7.PAD (E-PAD), U14.3 (GND), U27.5 (GND), U27.13 (GND), U27.18 (GND)
GPIO_HDMI_RST: R28.2, U14.1
HDMI_CEC: U7.71 (CEC_A), U27.24 (CEC_A)
HDMI_CONN_CEC: J2.13 (CEC), U27.6 (CEC_B)
HDMI_CONN_DSCL: J2.15 (SCL), U27.7 (SCL_B)
HDMI_CONN_DSDA: J2.16 (SDA), U27.8 (SDA_B)
HDMI_CONN_HPD: J2.19 (HPD/HEAC-), U27.9 (HPD_B)
HDMI_DSCL: U7.49 (DSCL), U27.1 (SCL_A)
HDMI_DSDA: U7.48 (DSDA), U27.2 (SDA_A)
HDMI_HPD: U7.54 (HPD), U27.3 (HPD_A)
HDMI_INT: U7.52 (INT)
HDMI_RSTn: R26.1, TP34.1, U7.51 (RESET#), U14.4
HDMI_TX0+: J2.7 (D0+), U7.62 (TX0+), U27.17 (D0+)
HDMI_TX0-: J2.9 (D0-), U7.61 (TX0-), U27.16 (D0-)
HDMI_TX1+: J2.4 (D1+), U7.65 (TX1+), U27.20 (D1+)
HDMI_TX1-: J2.6 (D1-), U7.64 (TX1-), U27.19 (D1-)
HDMI_TX2+: J2.1 (D2+), U7.68 (TX2+), U27.22 (D2+)
HDMI_TX2-: J2.3 (D2-), U7.67 (TX2-), U27.21 (D2-)
HDMI_TXC+: J2.10 (CK+), U7.59 (TXC+), U27.15 (CLK+)
HDMI_TXC-: J2.12 (CK-), U7.58 (TXC-), U27.14 (CLK-)
unnamed: R171.2, U7.72 (CI2CA)
RESETSTATz: U14.2
SOC_I2C0_SCL: U7.1 (CSCL)
SOC_I2C0_SDA: U7.2 (CSDA)
SOC_I2C2_SCL: J55.21
SOC_I2C2_SDA: J55.20
VDD_1V2: C186.1, C187.1, C188.1, C189.1, C190.1, C191.1, C192.1, C193.1, C329.1, C331.1, U7.5 (CVCC12@1), U7.12 (CVCC12@2), U7.26 (CVCC12@3), U7.42 (CVCC12@4), U7.47 (CVCC12@5), U7.53 (CVCC12@6), U7.60 (AVCC12@1), U7.66 (AVCC12@2)
VOUT0_DE: U7.33 (DE), U11.T17 (VOUT0_DE)
VOUT0__DATA0: U7.32 (D0), U11.R21 (VOUT0__DATA0)
VOUT0__DATA1: U7.31 (D1), U11.P18 (VOUT0__DATA1)
VOUT0__DATA2: U7.30 (D2), U11.T18 (VOUT0__DATA10)
VOUT0__DATA3: U7.29 (D3), U11.U20 (VOUT0__DATA11)
VOUT0__DATA4: U7.28 (D4), U11.U19 (VOUT0__DATA12)
VOUT0__DATA5: U7.27 (D5), U11.V21 (VOUT0__DATA13)
VOUT0__DATA6: U7.25 (D6), U11.U18 (VOUT0__DATA14)
VOUT0__DATA7: U7.24 (D7), U11.V20 (VOUT0__DATA15)
VOUT0__DATA8: U7.23 (D8), U11.R18 (VOUT0__DATA2)
VOUT0__DATA9: U7.20 (D9), U11.R19 (VOUT0__DATA3)
VOUT0__DATA10: U7.19 (D10), U11.R20 (VOUT0__DATA4)
VOUT0__DATA11: U7.18 (D11), U11.T20 (VOUT0__DATA5)
VOUT0__DATA12: U7.17 (D12), U11.T21 (VOUT0__DATA6)
VOUT0__DATA13: U7.16 (D13), U11.T19 (VOUT0__DATA7)
VOUT0__DATA14: U7.15 (D14), U11.U21 (VOUT0__DATA8)
VOUT0__DATA15: U7.14 (D15), U11.R17 (VOUT0__DATA9)
VOUT0__DATA16: U7.13 (D16)
VOUT0__DATA17: U7.11 (D17)
VOUT0__DATA18: U7.10 (D18)
VOUT0__DATA19: U7.9 (D19)
VOUT0__DATA20: U7.8 (D20)
VOUT0__DATA21: U7.7 (D21)
VOUT0__DATA22: U7.6 (D22)
VOUT0__DATA23: U7.4 (D23)
VOUT0__HSYNC: U7.34 (HSYNC), U11.W21 (VOUT0__HSYNC)
VOUT0__PCLK: U7.22 (IDCK), U11.U17 (VOUT0__PCLK)
VOUT0__VSYNC: U7.35 (VSYNC), U11.T16 (VOUT0__VSYNC)

Notes on the sheet:
Check if hdmi mstrclk is required (sii9022 datasheet)
D16:D23 on GPMC pins Needs muxmode configuration
HDMI SII9022 Reset
22-Pin 4 Lane CSI-2
HDMI Transmitter
