h3llf/Euclid-8/(commit log)

2026-03-03 Revision 1
    [ADC.kicad_sch, AM6254_DDR4.kicad_sch, Board_Power.kicad_sch, CAN.kicad_sch, Controller.kicad_sch, Drivers.kicad_sch, End_Stops.kicad_sch, Fans.kicad_sch]
2026-03-07 Fixed some minor issues, started some scheamtic clean up
    [Board_Power.kicad_sch, Controller.kicad_sch, SOC_Ethernet.kicad_sch, SOC_Ethernet2.kicad_sch, SOC_PMIC.kicad_sch, SOC_Power.kicad_sch]
2026-03-28 Reconfigured 12v & 5v buck converteres
    [ADC.kicad_sch, AM6254_DDR4.kicad_sch, Board_Power.kicad_sch, CAN.kicad_sch, Controller.kicad_sch, Drivers.kicad_sch, End_Stops.kicad_sch, Fans.kicad_sch]
2026-04-12 DDR_CLK termination
    [AM6254_DDR4.kicad_sch, Board_Power.kicad_sch, GPMC_Interface.kicad_sch, SOC_PMIC.kicad_sch, SOC_Video_Interface.kicad_sch]
2026-04-20 Testpoints + DDR velocity comp
    [ADC.kicad_sch, AM6254_DDR4.kicad_sch, Controller.kicad_sch, Drivers.kicad_sch, Heaters.kicad_sch, M.2_KeyE_WIFI.kicad_sch, MMC.kicad_sch, SOC_PMIC.kicad_sch]
2026-05-04 REV 1B
    [Board_Power.kicad_sch, GPMC_Interface.kicad_sch, SOC_PMIC.kicad_sch]
